3321485853ray-hue/Rhythm-of-Notes/images/04_声部分配与音高.png

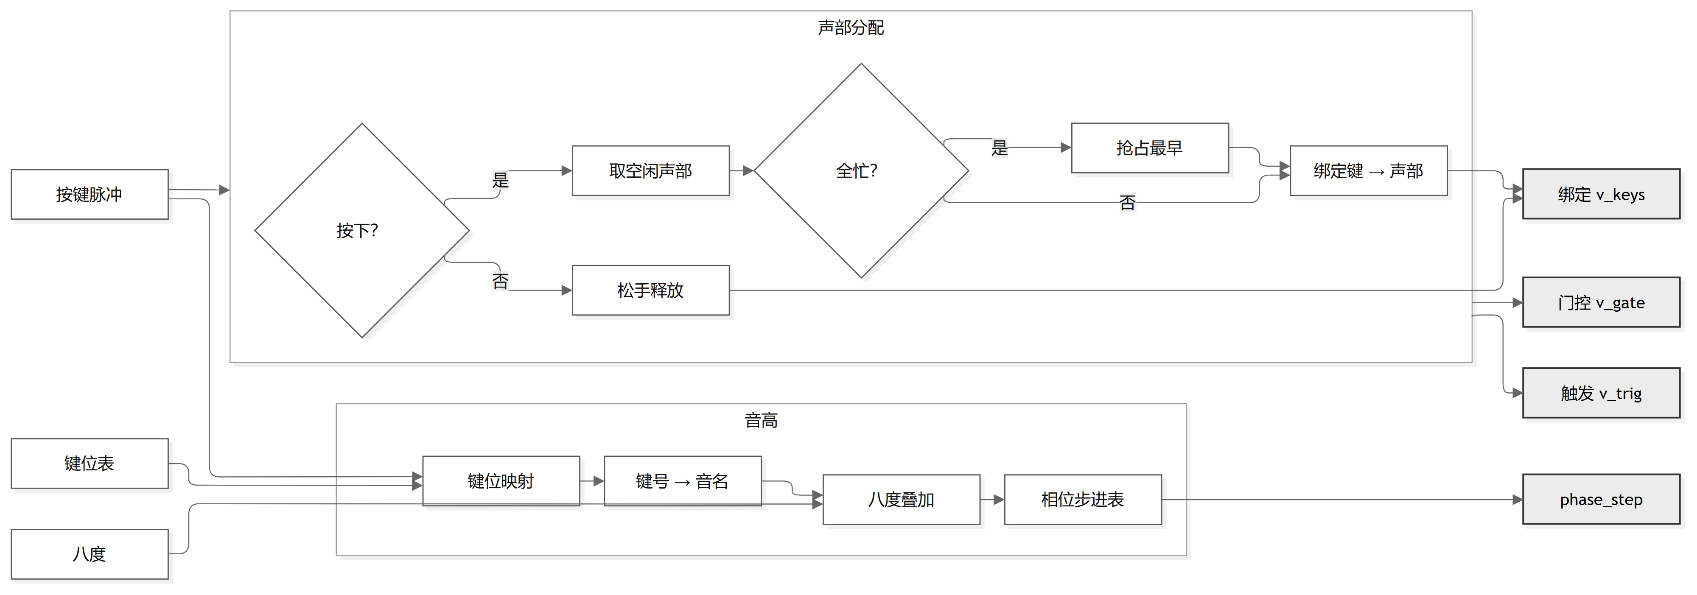
images/04_声部分配与音高.png
