3321485853ray-hue/Rhythm-of-Notes/images/05_加法合成引擎.png

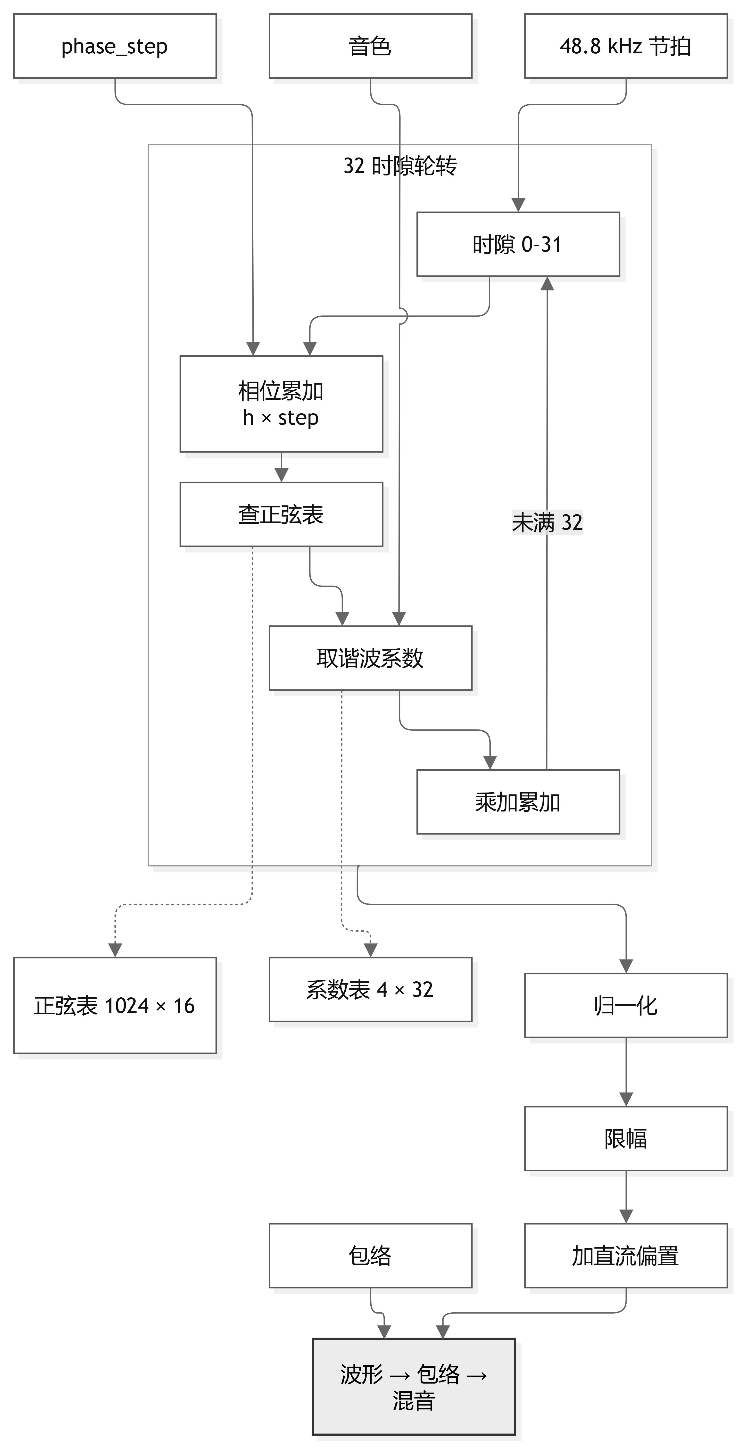
images/05_加法合成引擎.png
