3321485853ray-hue/Rhythm-of-Notes/images/10_FFT频谱.png

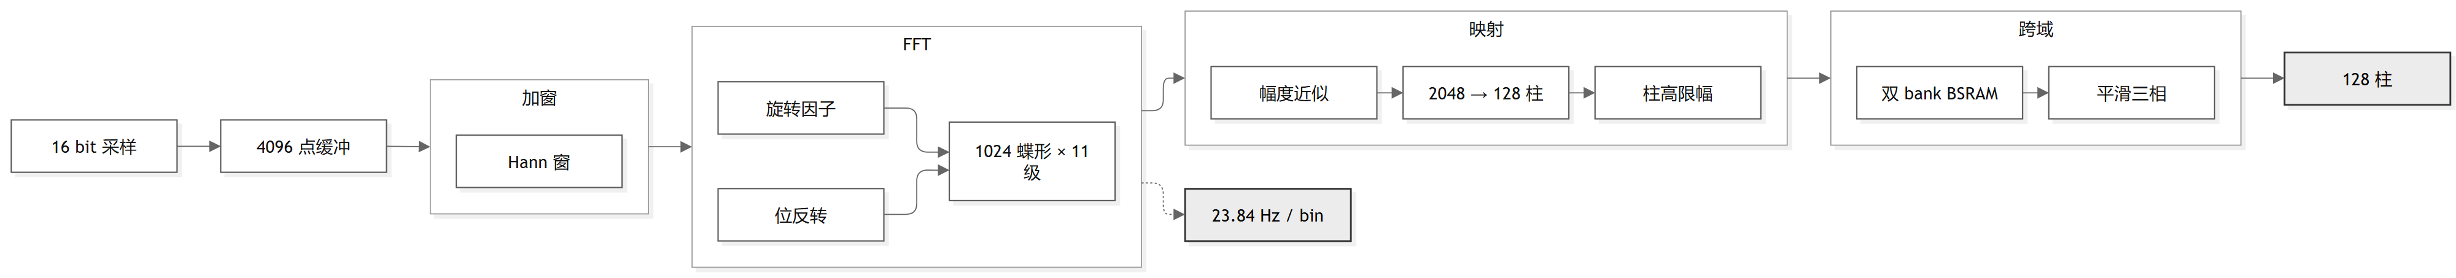
images/10_FFT频谱.png
