3321485853ray-hue/Rhythm-of-Notes/images/图3-12_I2S时序波形.png

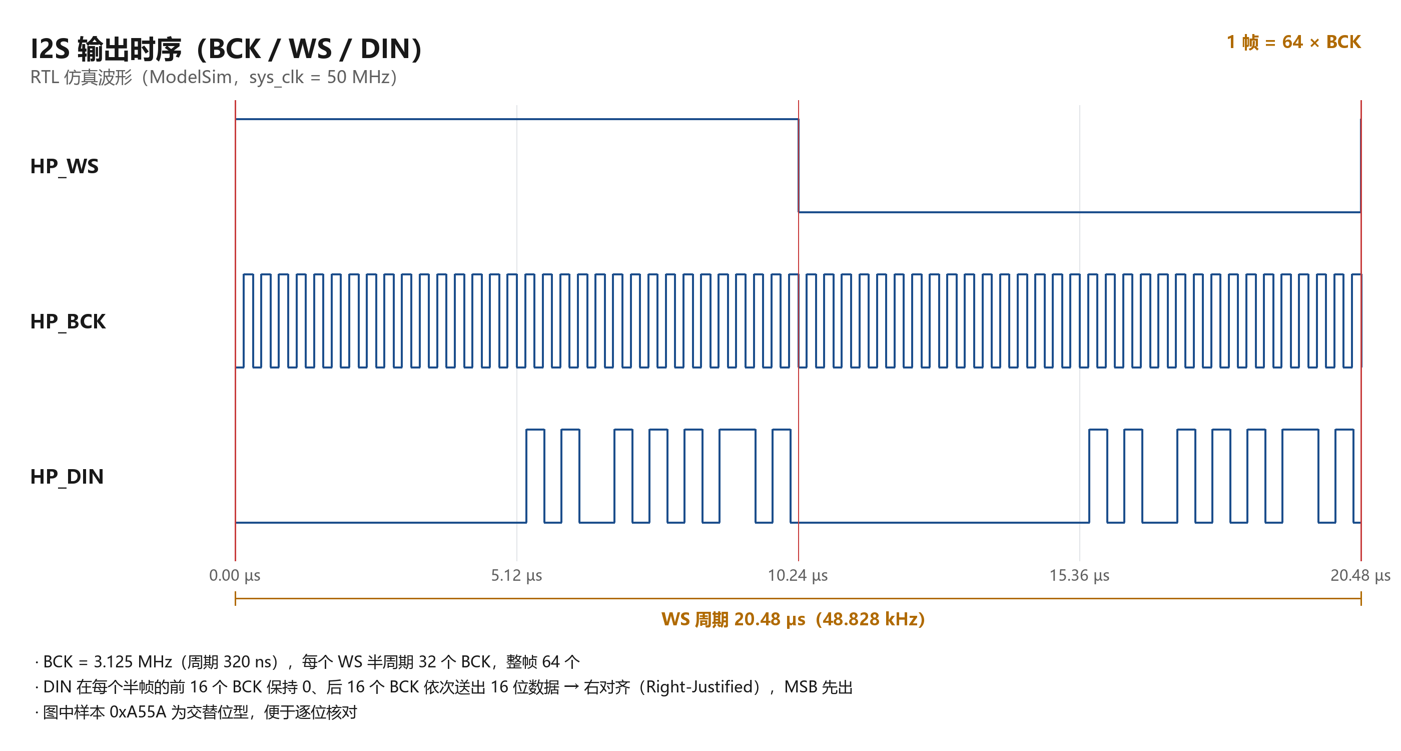
images/图3-12_I2S时序波形.png
