3321485853ray-hue/Rhythm-of-Notes/images/图3-12_ModelSim波形.png

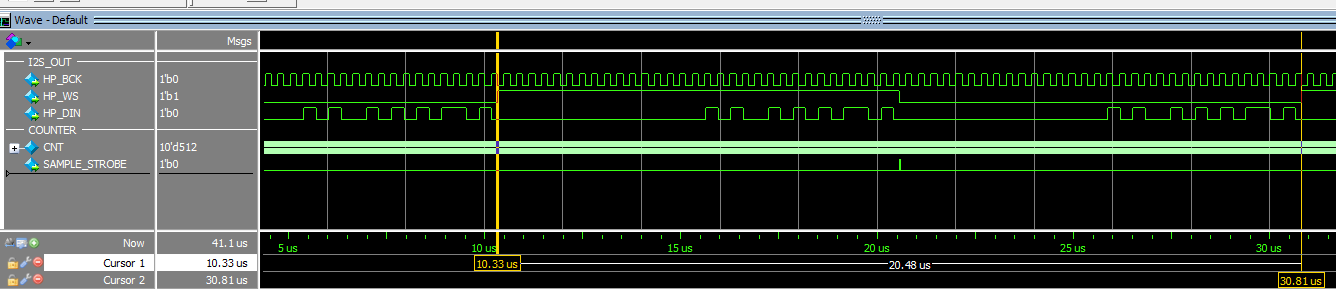
images/图3-12_ModelSim波形.png
