3321485853ray-hue/Rhythm-of-Notes/images/图3-14_颤音震音.png

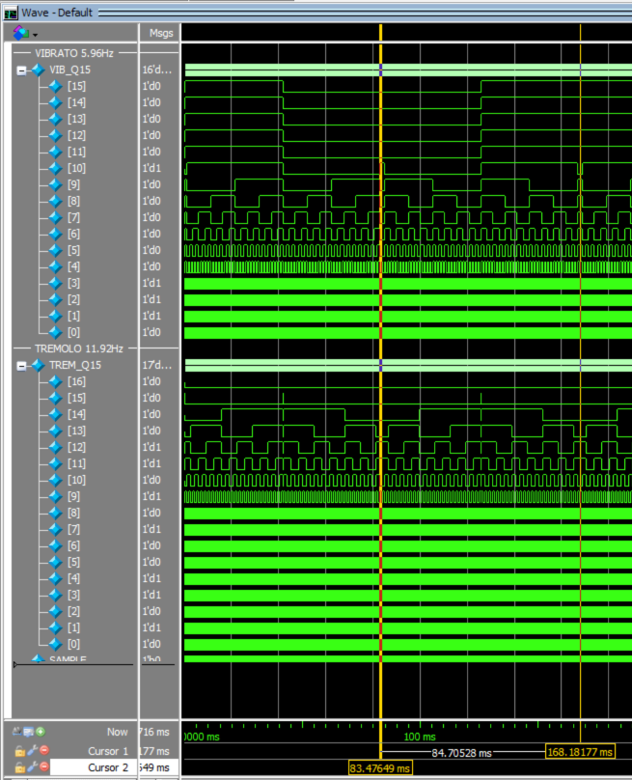
images/图3-14_颤音震音.png
