3321485853ray-hue/Rhythm-of-Notes/images/图3-15_UART帧.png

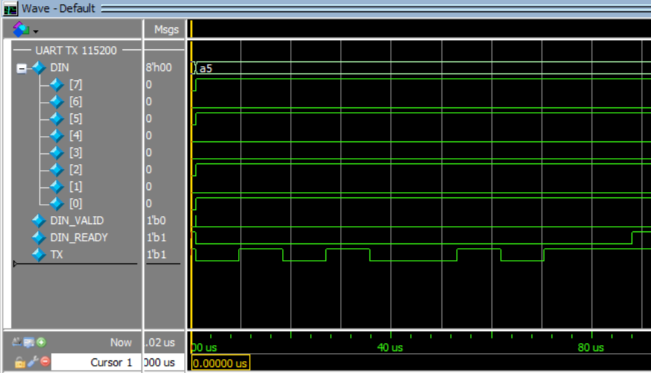
images/图3-15_UART帧.png
