3321485853ray-hue/Rhythm-of-Notes/images/图3-16_延迟.png

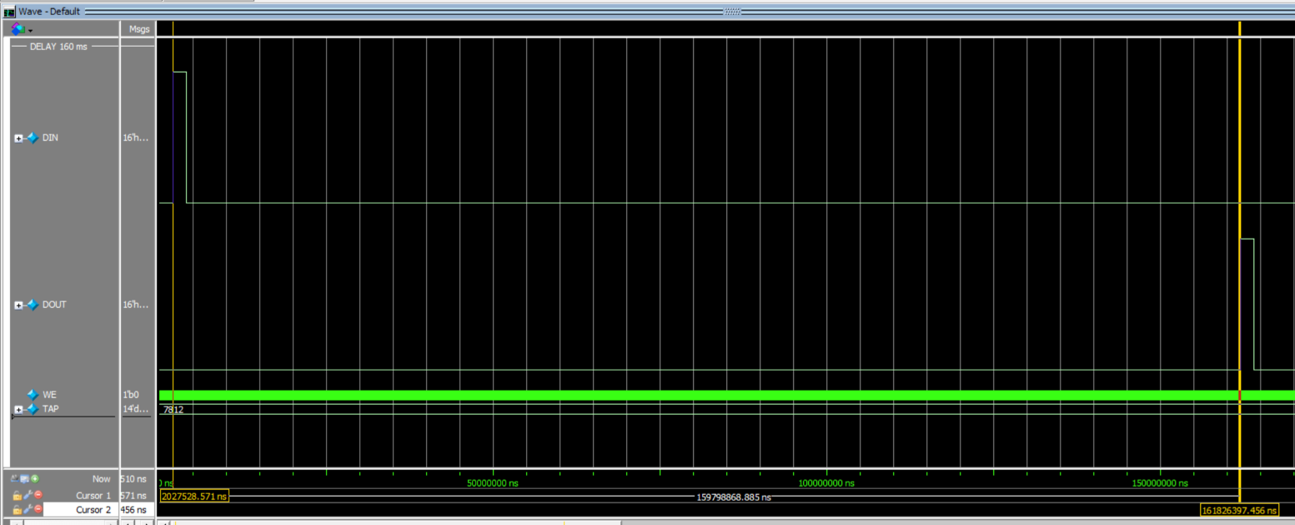
images/图3-16_延迟.png
