3321485853ray-hue/Rhythm-of-Notes/images/图3-17_混响.png

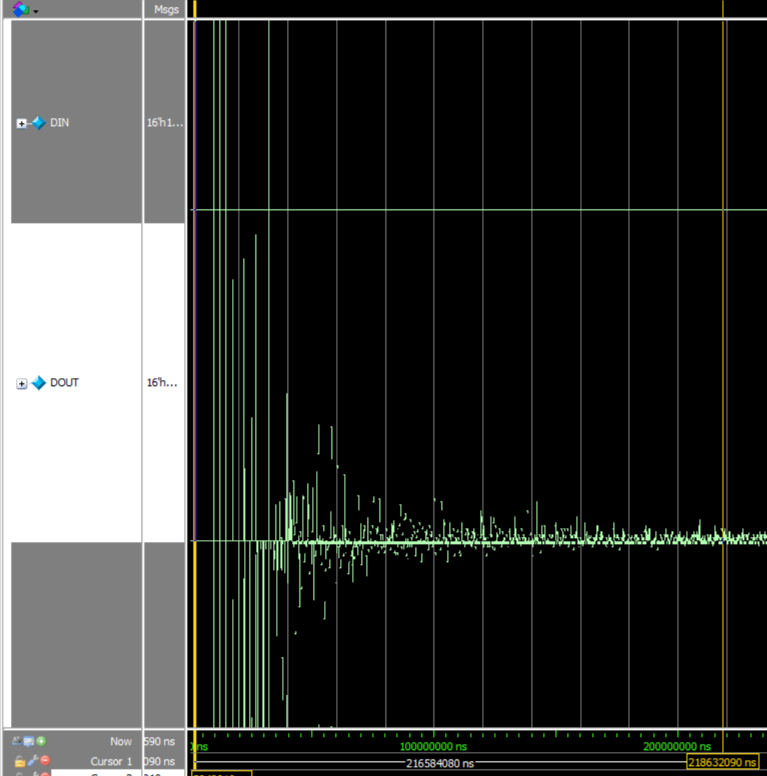
images/图3-17_混响.png
