3321485853ray-hue/Rhythm-of-Notes/images/图3-18_按键消抖.png

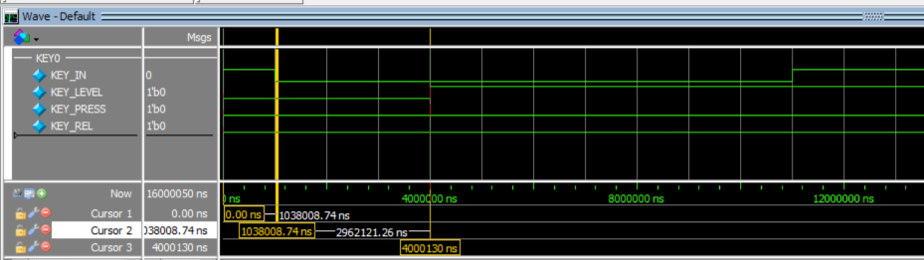
images/图3-18_按键消抖.png
