3321485853ray-hue/Rhythm-of-Notes/hardware/Black.stl

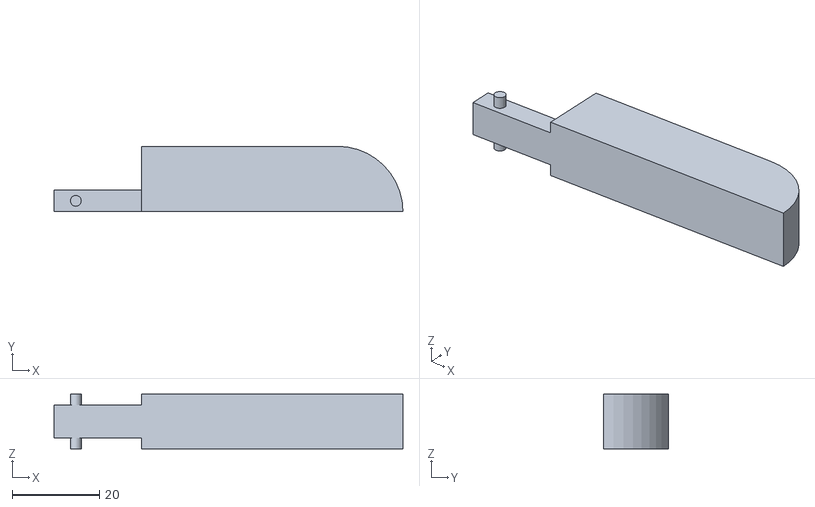
[picture p41: CAD file, 2026-11-04]
hardware/Black.stl
80.0 x 15.0 x 12.5
