3321485853ray-hue/Rhythm-of-Notes/hardware/WhiteUltimate.stl

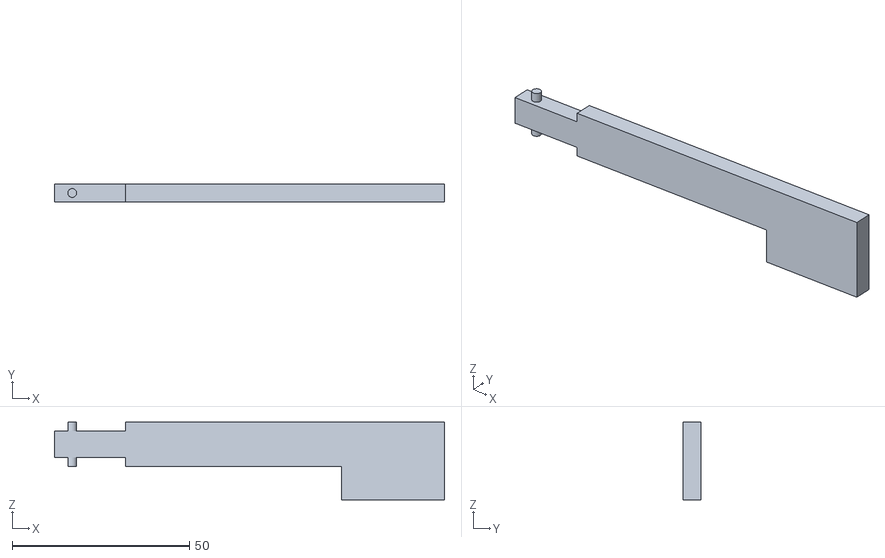
[picture p42: CAD file, 2026-11-04]
hardware/WhiteUltimate.stl
110.0 x 5.00 x 21.9
