3321485853ray-hue/Rhythm-of-Notes/hardware/Holder.stl

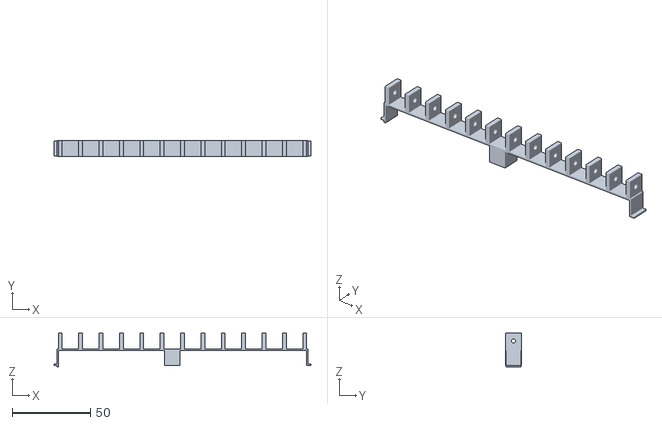
[picture p43: CAD file, 2026-11-04]
hardware/Holder.stl
164.0 x 10.0 x 21.5
