3321485853ray-hue/Rhythm-of-Notes/hardware/WhiteSide.stl

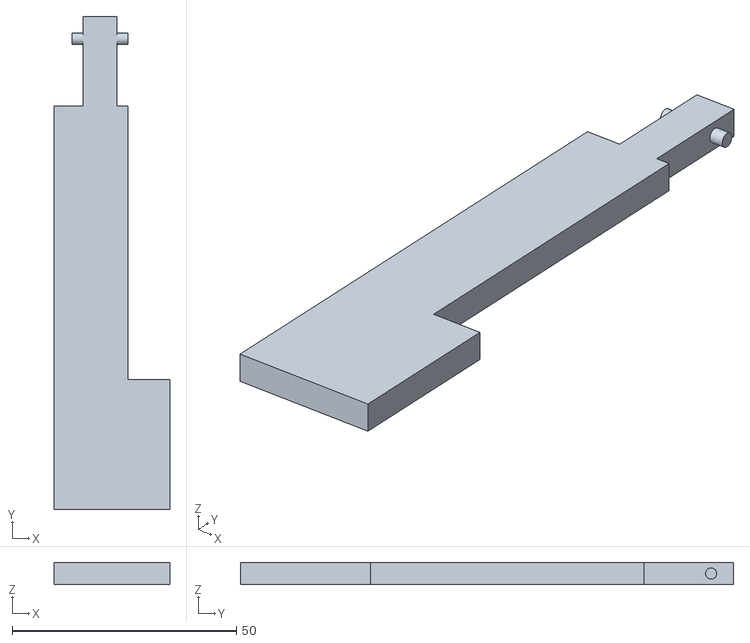
[picture p44: CAD file, 2026-11-04]
hardware/WhiteSide.stl
25.9 x 110.0 x 5.00
