3321485853ray-hue/Rhythm-of-Notes/hardware/base2.stl

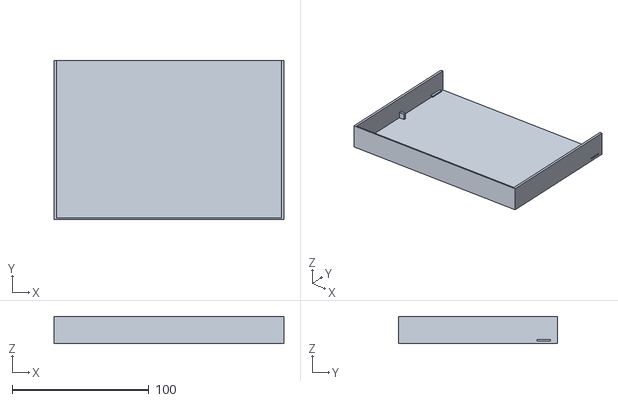
[picture p45: CAD file, 2026-11-04]
hardware/base2.stl
168.0 x 116.0 x 20.0
