3321485853ray-hue/Rhythm-of-Notes/hardware/Whiteequal.stl

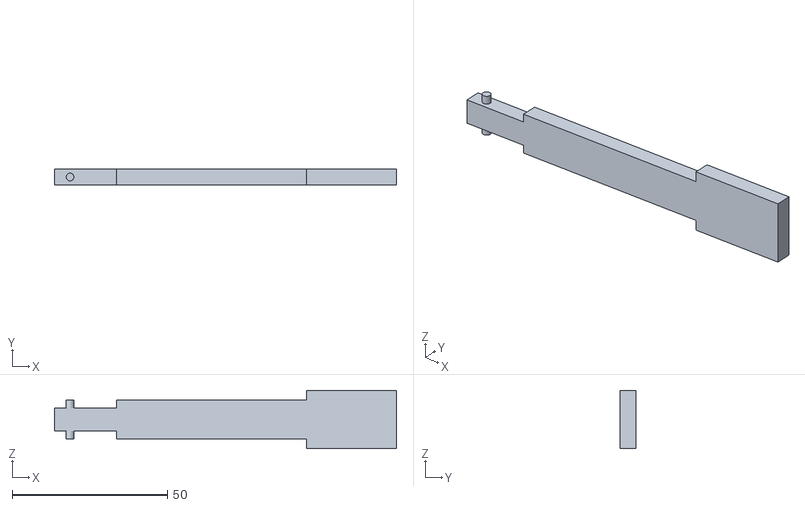
[picture p46: CAD file, 2026-11-04]
hardware/Whiteequal.stl
110.0 x 5.00 x 18.8
