3321485853ray-hue/Rhythm-of-Notes/(list of files, cad)

Other CAD files:
hardware/Whitecringe.stl
