3321485853ray-hue/Rhythm-of-Notes/fpga/src/harm_coef_rom.v

// harm_coef_rom.v —— 各音色 32 次谐波系数（coef>>5，0..255）

module harm_coef_rom (
    input  wire       clk,
    input  wire [7:0] addr,
    output reg  [7:0] dout = 8'd0
);
    reg [7:0] mem [0:255];
    initial begin
        mem[  0] = 8'd255;
        mem[  1] = 8'd  0;
        mem[  2] = 8'd  0;
        mem[  3] = 8'd  0;
        mem[  4] = 8'd  0;
        mem[  5] = 8'd  0;
        mem[  6] = 8'd  0;
        mem[  7] = 8'd  0;
        mem[  8] = 8'd  0;
        mem[  9] = 8'd  0;
        mem[ 10] = 8'd  0;
        mem[ 11] = 8'd  0;
        mem[ 12] = 8'd  0;
        mem[ 13] = 8'd  0;
        mem[ 14] = 8'd  0;
        mem[ 15] = 8'd  0;
        mem[ 16] = 8'd  0;
        mem[ 17] = 8'd  0;
        mem[ 18] = 8'd  0;
        mem[ 19] = 8'd  0;
        mem[ 20] = 8'd  0;
        mem[ 21] = 8'd  0;
        mem[ 22] = 8'd  0;
        mem[ 23] = 8'd  0;
        mem[ 24] = 8'd  0;
        mem[ 25] = 8'd  0;
        mem[ 26] = 8'd  0;
        mem[ 27] = 8'd  0;
        mem[ 28] = 8'd  0;
        mem[ 29] = 8'd  0;
        mem[ 30] = 8'd  0;
        mem[ 31] = 8'd  0;
        mem[ 32] = 8'd114;
        mem[ 33] = 8'd 79;
        mem[ 34] = 8'd 59;
        mem[ 35] = 8'd 45;
        mem[ 36] = 8'd 35;
        mem[ 37] = 8'd 28;
        mem[ 38] = 8'd 22;
        mem[ 39] = 8'd 18;
        mem[ 40] = 8'd 14;
        mem[ 41] = 8'd 12;
        mem[ 42] = 8'd 11;
        mem[ 43] = 8'd 10;
        mem[ 44] = 8'd  9;
        mem[ 45] = 8'd  9;
        mem[ 46] = 8'd  8;
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
        mem[248] = 8'd  0;
        mem[249] = 8'd  0;
        mem[250] = 8'd  0;
        mem[251] = 8'd  0;
        mem[252] = 8'd  0;
        mem[253] = 8'd  0;
        mem[254] = 8'd  0;
        mem[255] = 8'd  0;
    end
    always @(posedge clk) dout <= mem[addr];
endmodule
