3321485853ray-hue/Rhythm-of-Notes/fpga/src/bin2bar_rom.v

// bin2bar_rom.v —— FFT bin → 128 根线性频率柱（0..16000 Hz）

module bin2bar_rom (
    input  wire        clk,
    input  wire [9:0] addr,
    output reg  [7:0] dout = 8'd0
);
    reg [7:0] mem [0:1023];
    initial begin
        mem[   0] = 8'hff;
        mem[   1] = 8'h00;
        mem[   2] = 8'h00;
        mem[   3] = 8'h00;
        mem[   4] = 8'h00;
        mem[   5] = 8'h00;
        mem[   6] = 8'h01;
        mem[   7] = 8'h01;
        mem[   8] = 8'h01;
        mem[   9] = 8'h01;
        mem[  10] = 8'h01;
        mem[  11] = 8'h02;
        mem[  12] = 8'h02;
        mem[  13] = 8'h02;
        mem[  14] = 8'h02;
        mem[  15] = 8'h02;
        mem[  16] = 8'h03;
        mem[  17] = 8'h03;
        mem[  18] = 8'h03;
        mem[  19] = 8'h03;
        mem[  20] = 8'h03;
        mem[  21] = 8'h04;
        mem[  22] = 8'h04;
        mem[  23] = 8'h04;
        mem[  24] = 8'h04;
        mem[  25] = 8'h04;
        mem[  26] = 8'h04;
        mem[  27] = 8'h05;
        mem[  28] = 8'h05;
        mem[  29] = 8'h05;
        mem[  30] = 8'h05;
        mem[  31] = 8'h05;
        mem[  32] = 8'h06;
        mem[  33] = 8'h06;
        mem[  34] = 8'h06;
        mem[  35] = 8'h06;
        mem[  36] = 8'h06;
        mem[  37] = 8'h07;
        mem[  38] = 8'h07;
        mem[  39] = 8'h07;
        mem[  40] = 8'h07;
        mem[  41] = 8'h07;
        mem[  42] = 8'h08;
        mem[  43] = 8'h08;
        mem[  44] = 8'h08;
        mem[  45] = 8'h08;
        mem[  46] = 8'h08;
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
        mem[ 980] = 8'hff;
        mem[ 981] = 8'hff;
        mem[ 982] = 8'hff;
        mem[ 983] = 8'hff;
        mem[ 984] = 8'hff;
        mem[ 985] = 8'hff;
        mem[ 986] = 8'hff;
        mem[ 987] = 8'hff;
        mem[ 988] = 8'hff;
        mem[ 989] = 8'hff;
        mem[ 990] = 8'hff;
        mem[ 991] = 8'hff;
        mem[ 992] = 8'hff;
        mem[ 993] = 8'hff;
        mem[ 994] = 8'hff;
        mem[ 995] = 8'hff;
        mem[ 996] = 8'hff;
        mem[ 997] = 8'hff;
        mem[ 998] = 8'hff;
        mem[ 999] = 8'hff;
        mem[1000] = 8'hff;
        mem[1001] = 8'hff;
        mem[1002] = 8'hff;
        mem[1003] = 8'hff;
        mem[1004] = 8'hff;
        mem[1005] = 8'hff;
        mem[1006] = 8'hff;
        mem[1007] = 8'hff;
        mem[1008] = 8'hff;
        mem[1009] = 8'hff;
        mem[1010] = 8'hff;
        mem[1011] = 8'hff;
        mem[1012] = 8'hff;
        mem[1013] = 8'hff;
        mem[1014] = 8'hff;
        mem[1015] = 8'hff;
        mem[1016] = 8'hff;
        mem[1017] = 8'hff;
        mem[1018] = 8'hff;
        mem[1019] = 8'hff;
        mem[1020] = 8'hff;
        mem[1021] = 8'hff;
        mem[1022] = 8'hff;
        mem[1023] = 8'hff;
    end
    always @(posedge clk) dout <= mem[addr];
endmodule
