3321485853ray-hue/Rhythm-of-Notes/fpga/src/font_rom.v

// font_rom.v —— 8x16 点阵字库（ASCII 32..95，64 字符）

module font_rom (
    input  wire       clk,
    input  wire [9:0] addr,
    output reg  [7:0] dout = 8'd0
);
    reg [7:0] mem [0:1023];
    initial begin
        // ' '
        mem[  0] = 8'h00;
        mem[  1] = 8'h00;
        mem[  2] = 8'h00;
        mem[  3] = 8'h00;
        mem[  4] = 8'h00;
        mem[  5] = 8'h00;
        mem[  6] = 8'h00;
        mem[  7] = 8'h00;
        mem[  8] = 8'h00;
        mem[  9] = 8'h00;
        mem[ 10] = 8'h00;
        mem[ 11] = 8'h00;
        mem[ 12] = 8'h00;
        mem[ 13] = 8'h00;
        mem[ 14] = 8'h00;
        mem[ 15] = 8'h00;
        // '!'
        mem[ 16] = 8'h00;
        mem[ 17] = 8'h00;
        mem[ 18] = 8'h10;
        mem[ 19] = 8'h10;
        mem[ 20] = 8'h10;
        mem[ 21] = 8'h10;
        mem[ 22] = 8'h10;
        mem[ 23] = 8'h10;
        mem[ 24] = 8'h10;
        mem[ 25] = 8'h00;
        mem[ 26] = 8'h10;
        mem[ 27] = 8'h10;
        mem[ 28] = 8'h00;
        mem[ 29] = 8'h00;
        mem[ 30] = 8'h00;
        mem[ 31] = 8'h00;
        // '"'
        mem[ 32] = 8'h00;
        mem[ 33] = 8'h24;
        mem[ 34] = 8'h24;
        mem[ 35] = 8'h24;
        mem[ 36] = 8'h00;
        mem[ 37] = 8'h00;
        mem[ 38] = 8'h00;
        mem[ 39] = 8'h00;
        mem[ 40] = 8'h00;
        mem[ 41] = 8'h00;
        mem[ 42] = 8'h00;
        mem[ 43] = 8'h00;
        mem[ 44] = 8'h00;
        mem[ 45] = 8'h00;
        mem[ 46] = 8'h00;
        mem[ 47] = 8'h00;
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
        mem[980] = 8'h08;
        mem[981] = 8'h08;
        mem[982] = 8'h08;
        mem[983] = 8'h08;
        mem[984] = 8'h08;
        mem[985] = 8'h08;
        mem[986] = 8'h08;
        mem[987] = 8'h38;
        mem[988] = 8'h00;
        mem[989] = 8'h00;
        mem[990] = 8'h00;
        mem[991] = 8'h00;
        // '^'
        mem[992] = 8'h00;
        mem[993] = 8'h10;
        mem[994] = 8'h28;
        mem[995] = 8'h44;
        mem[996] = 8'h00;
        mem[997] = 8'h00;
        mem[998] = 8'h00;
        mem[999] = 8'h00;
        mem[1000] = 8'h00;
        mem[1001] = 8'h00;
        mem[1002] = 8'h00;
        mem[1003] = 8'h00;
        mem[1004] = 8'h00;
        mem[1005] = 8'h00;
        mem[1006] = 8'h00;
        mem[1007] = 8'h00;
        // '_'
        mem[1008] = 8'h00;
        mem[1009] = 8'h00;
        mem[1010] = 8'h00;
        mem[1011] = 8'h00;
        mem[1012] = 8'h00;
        mem[1013] = 8'h00;
        mem[1014] = 8'h00;
        mem[1015] = 8'h00;
        mem[1016] = 8'h00;
        mem[1017] = 8'h00;
        mem[1018] = 8'h00;
        mem[1019] = 8'h00;
        mem[1020] = 8'h00;
        mem[1021] = 8'h7E;
        mem[1022] = 8'h00;
        mem[1023] = 8'h00;
    end
    always @(posedge clk) dout <= mem[addr];
endmodule
