3321485853ray-hue/Rhythm-of-Notes/fpga/src/hann_rom.v

// hann_rom.v —— 2048 点 Hann 窗（Q15，周期型）

module hann_rom (
    input  wire        clk,
    input  wire [10:0] addr,
    output reg  [15:0] dout = 16'd0
);
    reg [15:0] mem [0:2047];
    initial begin
        mem[   0] = 16'h0000;
        mem[   1] = 16'h0000;
        mem[   2] = 16'h0000;
        mem[   3] = 16'h0001;
        mem[   4] = 16'h0001;
        mem[   5] = 16'h0002;
        mem[   6] = 16'h0003;
        mem[   7] = 16'h0004;
        mem[   8] = 16'h0005;
        mem[   9] = 16'h0006;
        mem[  10] = 16'h0008;
        mem[  11] = 16'h0009;
        mem[  12] = 16'h000b;
        mem[  13] = 16'h000d;
        mem[  14] = 16'h000f;
        mem[  15] = 16'h0011;
        mem[  16] = 16'h0014;
        mem[  17] = 16'h0016;
        mem[  18] = 16'h0019;
        mem[  19] = 16'h001c;
        mem[  20] = 16'h001f;
        mem[  21] = 16'h0022;
        mem[  22] = 16'h0025;
        mem[  23] = 16'h0029;
        mem[  24] = 16'h002c;
        mem[  25] = 16'h0030;
        mem[  26] = 16'h0034;
        mem[  27] = 16'h0038;
        mem[  28] = 16'h003c;
        mem[  29] = 16'h0041;
        mem[  30] = 16'h0045;
        mem[  31] = 16'h004a;
        mem[  32] = 16'h004f;
        mem[  33] = 16'h0054;
        mem[  34] = 16'h0059;
        mem[  35] = 16'h005e;
        mem[  36] = 16'h0064;
        mem[  37] = 16'h0069;
        mem[  38] = 16'h006f;
        mem[  39] = 16'h0075;
        mem[  40] = 16'h007b;
        mem[  41] = 16'h0081;
        mem[  42] = 16'h0088;
        mem[  43] = 16'h008e;
        mem[  44] = 16'h0095;
        mem[  45] = 16'h009c;
        mem[  46] = 16'h00a3;
        mem[  47] = 16'h00aa;
        mem[  48] = 16'h00b1;
        mem[  49] = 16'h00b9;
        mem[  50] = 16'h00c0;
        mem[  51] = 16'h00c8;
        mem[  52] = 16'h00d0;
        mem[  53] = 16'h00d8;
        mem[  54] = 16'h00e0;
        mem[  55] = 16'h00e9;
        mem[  56] = 16'h00f1;
        mem[  57] = 16'h00fa;
        mem[  58] = 16'h0103;
        mem[  59] = 16'h010c;
        mem[  60] = 16'h0115;
        mem[  61] = 16'h011e;
        mem[  62] = 16'h0127;
        mem[  63] = 16'h0131;
        mem[  64] = 16'h013b;
        mem[  65] = 16'h0145;
        mem[  66] = 16'h014f;
        mem[  67] = 16'h0159;
        mem[  68] = 16'h0163;
        mem[  69] = 16'h016e;
        mem[  70] = 16'h0178;
        mem[  71] = 16'h0183;
        mem[  72] = 16'h018e;
        mem[  73] = 16'h0199;
        mem[  74] = 16'h01a4;
        mem[  75] = 16'h01b0;
        mem[  76] = 16'h01bb;
        mem[  77] = 16'h01c7;
        mem[  78] = 16'h01d3;
        mem[  79] = 16'h01df;
        mem[  80] = 16'h01eb;
        mem[  81] = 16'h01f7;
        mem[  82] = 16'h0204;
        mem[  83] = 16'h0210;
        mem[  84] = 16'h021d;
        mem[  85] = 16'h022a;
        mem[  86] = 16'h0237;
        mem[  87] = 16'h0244;
        mem[  88] = 16'h0251;
        mem[  89] = 16'h025f;
        mem[  90] = 16'h026d;
        mem[  91] = 16'h027a;
        mem[  92] = 16'h0288;
        mem[  93] = 16'h0296;
        mem[  94] = 16'h02a5;
        mem[  95] = 16'h02b3;
        mem[  96] = 16'h02c1;
        mem[  97] = 16'h02d0;
        mem[  98] = 16'h02df;
        mem[  99] = 16'h02ee;
        mem[ 100] = 16'h02fd;
        mem[ 101] = 16'h030c;
        mem[ 102] = 16'h031c;
        mem[ 103] = 16'h032b;
        mem[ 104] = 16'h033b;
        mem[ 105] = 16'h034b;
        mem[ 106] = 16'h035b;
        mem[ 107] = 16'h036b;
        mem[ 108] = 16'h037b;
        mem[ 109] = 16'h038c;
        mem[ 110] = 16'h039c;
        mem[ 111] = 16'h03ad;
        mem[ 112] = 16'h03be;
        mem[ 113] = 16'h03cf;
        mem[ 114] = 16'h03e0;
        mem[ 115] = 16'h03f1;
        mem[ 116] = 16'h0403;
        mem[ 117] = 16'h0414;
        mem[ 118] = 16'h0426;
        mem[ 119] = 16'h0438;
        mem[ 120] = 16'h044a;
        mem[ 121] = 16'h045c;
        mem[ 122] = 16'h046e;
        mem[ 123] = 16'h0481;
        mem[ 124] = 16'h0493;
        mem[ 125] = 16'h04a6;
        mem[ 126] = 16'h04b9;
        mem[ 127] = 16'h04cc;
        mem[ 128] = 16'h04df;
        mem[ 129] = 16'h04f2;
        mem[ 130] = 16'h0506;
        mem[ 131] = 16'h0519;
        mem[ 132] = 16'h052d;
        mem[ 133] = 16'h0541;
        mem[ 134] = 16'h0555;
        mem[ 135] = 16'h0569;
        mem[ 136] = 16'h057e;
        mem[ 137] = 16'h0592;
        mem[ 138] = 16'h05a7;
        mem[ 139] = 16'h05bb;
        mem[ 140] = 16'h05d0;
        mem[ 141] = 16'h05e5;
        mem[ 142] = 16'h05fa;
        mem[ 143] = 16'h0610;
        mem[ 144] = 16'h0625;
        mem[ 145] = 16'h063b;
        mem[ 146] = 16'h0650;
        mem[ 147] = 16'h0666;
        mem[ 148] = 16'h067c;
        mem[ 149] = 16'h0692;
        mem[ 150] = 16'h06a8;
        mem[ 151] = 16'h06bf;
        mem[ 152] = 16'h06d5;
        mem[ 153] = 16'h06ec;
        mem[ 154] = 16'h0703;
        mem[ 155] = 16'h071a;
        mem[ 156] = 16'h0731;
        mem[ 157] = 16'h0748;
        mem[ 158] = 16'h075f;
        mem[ 159] = 16'h0777;
        mem[ 160] = 16'h078f;
        mem[ 161] = 16'h07a6;
        mem[ 162] = 16'h07be;
        mem[ 163] = 16'h07d6;
        mem[ 164] = 16'h07ee;
        mem[ 165] = 16'h0807;
        mem[ 166] = 16'h081f;
        mem[ 167] = 16'h0838;
        mem[ 168] = 16'h0850;
        mem[ 169] = 16'h0869;
        mem[ 170] = 16'h0882;
        mem[ 171] = 16'h089b;
        mem[ 172] = 16'h08b5;
        mem[ 173] = 16'h08ce;
        mem[ 174] = 16'h08e7;
        mem[ 175] = 16'h0901;
        mem[ 176] = 16'h091b;
        mem[ 177] = 16'h0935;
        mem[ 178] = 16'h094f;
        mem[ 179] = 16'h0969;
        mem[ 180] = 16'h0983;
        mem[ 181] = 16'h099e;
        mem[ 182] = 16'h09b8;
        mem[ 183] = 16'h09d3;
        mem[ 184] = 16'h09ee;
        mem[ 185] = 16'h0a09;
        mem[ 186] = 16'h0a24;
        mem[ 187] = 16'h0a3f;
        mem[ 188] = 16'h0a5a;
        mem[ 189] = 16'h0a76;
        mem[ 190] = 16'h0a92;
        mem[ 191] = 16'h0aad;
        mem[ 192] = 16'h0ac9;
        mem[ 193] = 16'h0ae5;
        mem[ 194] = 16'h0b01;
        mem[ 195] = 16'h0b1d;
        mem[ 196] = 16'h0b3a;
        mem[ 197] = 16'h0b56;
        mem[ 198] = 16'h0b73;
        mem[ 199] = 16'h0b90;
        mem[ 200] = 16'h0bad;
        mem[ 201] = 16'h0bca;
        mem[ 202] = 16'h0be7;
        mem[ 203] = 16'h0c04;
        mem[ 204] = 16'h0c21;
        mem[ 205] = 16'h0c3f;
        mem[ 206] = 16'h0c5d;
        mem[ 207] = 16'h0c7a;
        mem[ 208] = 16'h0c98;
        mem[ 209] = 16'h0cb6;
        mem[ 210] = 16'h0cd4;
        mem[ 211] = 16'h0cf3;
        mem[ 212] = 16'h0d11;
        mem[ 213] = 16'h0d2f;
        mem[ 214] = 16'h0d4e;
        mem[ 215] = 16'h0d6d;
        mem[ 216] = 16'h0d8c;
        mem[ 217] = 16'h0dab;
        mem[ 218] = 16'h0dca;
        mem[ 219] = 16'h0de9;
        mem[ 220] = 16'h0e08;
        mem[ 221] = 16'h0e28;
        mem[ 222] = 16'h0e47;
        mem[ 223] = 16'h0e67;
        mem[ 224] = 16'h0e87;
        mem[ 225] = 16'h0ea7;
        mem[ 226] = 16'h0ec7;
        mem[ 227] = 16'h0ee7;
        mem[ 228] = 16'h0f07;
        mem[ 229] = 16'h0f28;
        mem[ 230] = 16'h0f48;
        mem[ 231] = 16'h0f69;
        mem[ 232] = 16'h0f8a;
        mem[ 233] = 16'h0fab;
        mem[ 234] = 16'h0fcc;
        mem[ 235] = 16'h0fed;
        mem[ 236] = 16'h100e;
        mem[ 237] = 16'h102f;
        mem[ 238] = 16'h1051;
        mem[ 239] = 16'h1072;
        mem[ 240] = 16'h1094;
        mem[ 241] = 16'h10b6;
        mem[ 242] = 16'h10d8;
        mem[ 243] = 16'h10fa;
        mem[ 244] = 16'h111c;
        mem[ 245] = 16'h113e;
        mem[ 246] = 16'h1161;
        mem[ 247] = 16'h1183;
        mem[ 248] = 16'h11a6;
        mem[ 249] = 16'h11c9;
        mem[ 250] = 16'h11eb;
        mem[ 251] = 16'h120e;
        mem[ 252] = 16'h1231;
        mem[ 253] = 16'h1254;
        mem[ 254] = 16'h1278;
        mem[ 255] = 16'h129b;
        mem[ 256] = 16'h12bf;
        mem[ 257] = 16'h12e2;
        mem[ 258] = 16'h1306;
        mem[ 259] = 16'h132a;
        mem[ 260] = 16'h134e;
        mem[ 261] = 16'h1372;
        mem[ 262] = 16'h1396;
        mem[ 263] = 16'h13ba;
        mem[ 264] = 16'h13de;
        mem[ 265] = 16'h1403;
        mem[ 266] = 16'h1427;
        mem[ 267] = 16'h144c;
        mem[ 268] = 16'h1471;
        mem[ 269] = 16'h1496;
        mem[ 270] = 16'h14bb;
        mem[ 271] = 16'h14e0;
        mem[ 272] = 16'h1505;
        mem[ 273] = 16'h152a;
        mem[ 274] = 16'h1550;
        mem[ 275] = 16'h1575;
        mem[ 276] = 16'h159b;
        mem[ 277] = 16'h15c1;
        mem[ 278] = 16'h15e6;
        mem[ 279] = 16'h160c;
        mem[ 280] = 16'h1632;
        mem[ 281] = 16'h1658;
        mem[ 282] = 16'h167f;
        mem[ 283] = 16'h16a5;
        mem[ 284] = 16'h16cb;
        mem[ 285] = 16'h16f2;
        mem[ 286] = 16'h1718;
        mem[ 287] = 16'h173f;
        mem[ 288] = 16'h1766;
        mem[ 289] = 16'h178d;
        mem[ 290] = 16'h17b4;
        mem[ 291] = 16'h17db;
        mem[ 292] = 16'h1802;
        mem[ 293] = 16'h1829;
        mem[ 294] = 16'h1851;
        mem[ 295] = 16'h1878;
        mem[ 296] = 16'h18a0;
        mem[ 297] = 16'h18c8;
        mem[ 298] = 16'h18ef;
        mem[ 299] = 16'h1917;
        mem[ 300] = 16'h193f;
        mem[ 301] = 16'h1967;
        mem[ 302] = 16'h198f;
        mem[ 303] = 16'h19b8;
        mem[ 304] = 16'h19e0;
        mem[ 305] = 16'h1a08;
        mem[ 306] = 16'h1a31;
        mem[ 307] = 16'h1a59;
        mem[ 308] = 16'h1a82;
        mem[ 309] = 16'h1aab;
        mem[ 310] = 16'h1ad4;
        mem[ 311] = 16'h1afd;
        mem[ 312] = 16'h1b26;
        mem[ 313] = 16'h1b4f;
        mem[ 314] = 16'h1b78;
        mem[ 315] = 16'h1ba1;
        mem[ 316] = 16'h1bcb;
        mem[ 317] = 16'h1bf4;
        mem[ 318] = 16'h1c1e;
        mem[ 319] = 16'h1c48;
        mem[ 320] = 16'h1c71;
        mem[ 321] = 16'h1c9b;
        mem[ 322] = 16'h1cc5;
        mem[ 323] = 16'h1cef;
        mem[ 324] = 16'h1d19;
        mem[ 325] = 16'h1d43;
        mem[ 326] = 16'h1d6e;
        mem[ 327] = 16'h1d98;
        mem[ 328] = 16'h1dc2;
        mem[ 329] = 16'h1ded;
        mem[ 330] = 16'h1e17;
        mem[ 331] = 16'h1e42;
        mem[ 332] = 16'h1e6d;
        mem[ 333] = 16'h1e98;
        mem[ 334] = 16'h1ec3;
        mem[ 335] = 16'h1eee;
        mem[ 336] = 16'h1f19;
        mem[ 337] = 16'h1f44;
        mem[ 338] = 16'h1f6f;
        mem[ 339] = 16'h1f9a;
        mem[ 340] = 16'h1fc6;
        mem[ 341] = 16'h1ff1;
        mem[ 342] = 16'h201d;
        mem[ 343] = 16'h2048;
        mem[ 344] = 16'h2074;
        mem[ 345] = 16'h20a0;
        mem[ 346] = 16'h20cc;
        mem[ 347] = 16'h20f8;
        mem[ 348] = 16'h2124;
        mem[ 349] = 16'h2150;
        mem[ 350] = 16'h217c;
        mem[ 351] = 16'h21a8;
        mem[ 352] = 16'h21d4;
        mem[ 353] = 16'h2201;
        mem[ 354] = 16'h222d;
        mem[ 355] = 16'h225a;
        mem[ 356] = 16'h2286;
        mem[ 357] = 16'h22b3;
        mem[ 358] = 16'h22e0;
        mem[ 359] = 16'h230c;
        mem[ 360] = 16'h2339;
        mem[ 361] = 16'h2366;
        mem[ 362] = 16'h2393;
        mem[ 363] = 16'h23c0;
        mem[ 364] = 16'h23ed;
        mem[ 365] = 16'h241b;
        mem[ 366] = 16'h2448;
        mem[ 367] = 16'h2475;
        mem[ 368] = 16'h24a3;
        mem[ 369] = 16'h24d0;
        mem[ 370] = 16'h24fe;
        mem[ 371] = 16'h252b;
        mem[ 372] = 16'h2559;
        mem[ 373] = 16'h2587;
        mem[ 374] = 16'h25b4;
        mem[ 375] = 16'h25e2;
        mem[ 376] = 16'h2610;
        mem[ 377] = 16'h263e;
        mem[ 378] = 16'h266c;
        mem[ 379] = 16'h269a;
        mem[ 380] = 16'h26c9;
        mem[ 381] = 16'h26f7;
        mem[ 382] = 16'h2725;
        mem[ 383] = 16'h2753;
        mem[ 384] = 16'h2782;
        mem[ 385] = 16'h27b0;
        mem[ 386] = 16'h27df;
        mem[ 387] = 16'h280d;
        mem[ 388] = 16'h283c;
        mem[ 389] = 16'h286b;
        mem[ 390] = 16'h2899;
        mem[ 391] = 16'h28c8;
        mem[ 392] = 16'h28f7;
        mem[ 393] = 16'h2926;
        mem[ 394] = 16'h2955;
        mem[ 395] = 16'h2984;
        mem[ 396] = 16'h29b3;
        mem[ 397] = 16'h29e2;
        mem[ 398] = 16'h2a12;
        mem[ 399] = 16'h2a41;
        mem[ 400] = 16'h2a70;
        mem[ 401] = 16'h2a9f;
        mem[ 402] = 16'h2acf;
        mem[ 403] = 16'h2afe;
        mem[ 404] = 16'h2b2e;
        mem[ 405] = 16'h2b5d;
        mem[ 406] = 16'h2b8d;
        mem[ 407] = 16'h2bbd;
        mem[ 408] = 16'h2bec;
        mem[ 409] = 16'h2c1c;
        mem[ 410] = 16'h2c4c;
        mem[ 411] = 16'h2c7c;
        mem[ 412] = 16'h2cac;
        mem[ 413] = 16'h2cdc;
        mem[ 414] = 16'h2d0c;
        mem[ 415] = 16'h2d3c;
        mem[ 416] = 16'h2d6c;
        mem[ 417] = 16'h2d9c;
        mem[ 418] = 16'h2dcc;
        mem[ 419] = 16'h2dfc;
        mem[ 420] = 16'h2e2c;
        mem[ 421] = 16'h2e5d;
        mem[ 422] = 16'h2e8d;
        mem[ 423] = 16'h2ebd;
        mem[ 424] = 16'h2eee;
        mem[ 425] = 16'h2f1e;
        mem[ 426] = 16'h2f4f;
        mem[ 427] = 16'h2f7f;
        mem[ 428] = 16'h2fb0;
        mem[ 429] = 16'h2fe1;
        mem[ 430] = 16'h3011;
        mem[ 431] = 16'h3042;
        mem[ 432] = 16'h3073;
        mem[ 433] = 16'h30a3;
        mem[ 434] = 16'h30d4;
        mem[ 435] = 16'h3105;
        mem[ 436] = 16'h3136;
        mem[ 437] = 16'h3167;
        mem[ 438] = 16'h3198;
        mem[ 439] = 16'h31c9;
        mem[ 440] = 16'h31fa;
        mem[ 441] = 16'h322b;
        mem[ 442] = 16'h325c;
        mem[ 443] = 16'h328d;
        mem[ 444] = 16'h32be;
        mem[ 445] = 16'h32ef;
        mem[ 446] = 16'h3321;
        mem[ 447] = 16'h3352;
        mem[ 448] = 16'h3383;
        mem[ 449] = 16'h33b5;
        mem[ 450] = 16'h33e6;
        mem[ 451] = 16'h3417;
        mem[ 452] = 16'h3449;
        mem[ 453] = 16'h347a;
        mem[ 454] = 16'h34ac;
        mem[ 455] = 16'h34dd;
        mem[ 456] = 16'h350f;
        mem[ 457] = 16'h3540;
        mem[ 458] = 16'h3572;
        mem[ 459] = 16'h35a3;
        mem[ 460] = 16'h35d5;
        mem[ 461] = 16'h3606;
        mem[ 462] = 16'h3638;
        mem[ 463] = 16'h366a;
        mem[ 464] = 16'h369c;
        mem[ 465] = 16'h36cd;
        mem[ 466] = 16'h36ff;
        mem[ 467] = 16'h3731;
        mem[ 468] = 16'h3763;
        mem[ 469] = 16'h3794;
        mem[ 470] = 16'h37c6;
        mem[ 471] = 16'h37f8;
        mem[ 472] = 16'h382a;
        mem[ 473] = 16'h385c;
        mem[ 474] = 16'h388e;
        mem[ 475] = 16'h38c0;
        mem[ 476] = 16'h38f2;
        mem[ 477] = 16'h3924;
        mem[ 478] = 16'h3956;
        mem[ 479] = 16'h3988;
        mem[ 480] = 16'h39ba;
        mem[ 481] = 16'h39ec;
        mem[ 482] = 16'h3a1e;
        mem[ 483] = 16'h3a50;
        mem[ 484] = 16'h3a82;
        mem[ 485] = 16'h3ab4;
        mem[ 486] = 16'h3ae6;
        mem[ 487] = 16'h3b18;
        mem[ 488] = 16'h3b4a;
        mem[ 489] = 16'h3b7c;
        mem[ 490] = 16'h3baf;
        mem[ 491] = 16'h3be1;
        mem[ 492] = 16'h3c13;
        mem[ 493] = 16'h3c45;
        mem[ 494] = 16'h3c77;
        mem[ 495] = 16'h3ca9;
        mem[ 496] = 16'h3cdc;
        mem[ 497] = 16'h3d0e;
        mem[ 498] = 16'h3d40;
        mem[ 499] = 16'h3d72;
        mem[ 500] = 16'h3da4;
        mem[ 501] = 16'h3dd7;
        mem[ 502] = 16'h3e09;
        mem[ 503] = 16'h3e3b;
        mem[ 504] = 16'h3e6d;
        mem[ 505] = 16'h3ea0;
        mem[ 506] = 16'h3ed2;
        mem[ 507] = 16'h3f04;
        mem[ 508] = 16'h3f36;
        mem[ 509] = 16'h3f69;
        mem[ 510] = 16'h3f9b;
        mem[ 511] = 16'h3fcd;
        mem[ 512] = 16'h3fff;
        mem[ 513] = 16'h4032;
        mem[ 514] = 16'h4064;
        mem[ 515] = 16'h4096;
        mem[ 516] = 16'h40c9;
        mem[ 517] = 16'h40fb;
        mem[ 518] = 16'h412d;
        mem[ 519] = 16'h415f;
        mem[ 520] = 16'h4192;
        mem[ 521] = 16'h41c4;
        mem[ 522] = 16'h41f6;
        mem[ 523] = 16'h4228;
        mem[ 524] = 16'h425b;
        mem[ 525] = 16'h428d;
        mem[ 526] = 16'h42bf;
        mem[ 527] = 16'h42f1;
        mem[ 528] = 16'h4323;
        mem[ 529] = 16'h4356;
        mem[ 530] = 16'h4388;
        mem[ 531] = 16'h43ba;
        mem[ 532] = 16'h43ec;
        mem[ 533] = 16'h441e;
        mem[ 534] = 16'h4450;
        mem[ 535] = 16'h4483;
        mem[ 536] = 16'h44b5;
        mem[ 537] = 16'h44e7;
        mem[ 538] = 16'h4519;
        mem[ 539] = 16'h454b;
        mem[ 540] = 16'h457d;
        mem[ 541] = 16'h45af;
        mem[ 542] = 16'h45e1;
        mem[ 543] = 16'h4613;
        mem[ 544] = 16'h4645;
        mem[ 545] = 16'h4677;
        mem[ 546] = 16'h46a9;
        mem[ 547] = 16'h46db;
        mem[ 548] = 16'h470d;
        mem[ 549] = 16'h473f;
        mem[ 550] = 16'h4771;
        mem[ 551] = 16'h47a3;
        mem[ 552] = 16'h47d5;
        mem[ 553] = 16'h4807;
        mem[ 554] = 16'h4839;
        mem[ 555] = 16'h486b;
        mem[ 556] = 16'h489c;
        mem[ 557] = 16'h48ce;
        mem[ 558] = 16'h4900;
        mem[ 559] = 16'h4932;
        mem[ 560] = 16'h4963;
        mem[ 561] = 16'h4995;
        mem[ 562] = 16'h49c7;
        mem[ 563] = 16'h49f9;
        mem[ 564] = 16'h4a2a;
        mem[ 565] = 16'h4a5c;
        mem[ 566] = 16'h4a8d;
        mem[ 567] = 16'h4abf;
        mem[ 568] = 16'h4af0;
        mem[ 569] = 16'h4b22;
        mem[ 570] = 16'h4b53;
        mem[ 571] = 16'h4b85;
        mem[ 572] = 16'h4bb6;
        mem[ 573] = 16'h4be8;
        mem[ 574] = 16'h4c19;
        mem[ 575] = 16'h4c4a;
        mem[ 576] = 16'h4c7c;
        mem[ 577] = 16'h4cad;
        mem[ 578] = 16'h4cde;
        mem[ 579] = 16'h4d10;
        mem[ 580] = 16'h4d41;
        mem[ 581] = 16'h4d72;
        mem[ 582] = 16'h4da3;
        mem[ 583] = 16'h4dd4;
        mem[ 584] = 16'h4e05;
        mem[ 585] = 16'h4e36;
        mem[ 586] = 16'h4e67;
        mem[ 587] = 16'h4e98;
        mem[ 588] = 16'h4ec9;
        mem[ 589] = 16'h4efa;
        mem[ 590] = 16'h4f2b;
        mem[ 591] = 16'h4f5c;
        mem[ 592] = 16'h4f8c;
        mem[ 593] = 16'h4fbd;
        mem[ 594] = 16'h4fee;
        mem[ 595] = 16'h501e;
        mem[ 596] = 16'h504f;
        mem[ 597] = 16'h5080;
        mem[ 598] = 16'h50b0;
        mem[ 599] = 16'h50e1;
        mem[ 600] = 16'h5111;
        mem[ 601] = 16'h5142;
        mem[ 602] = 16'h5172;
        mem[ 603] = 16'h51a2;
        mem[ 604] = 16'h51d3;
        mem[ 605] = 16'h5203;
        mem[ 606] = 16'h5233;
        mem[ 607] = 16'h5263;
        mem[ 608] = 16'h5293;
        mem[ 609] = 16'h52c3;
        mem[ 610] = 16'h52f3;
        mem[ 611] = 16'h5323;
        mem[ 612] = 16'h5353;
        mem[ 613] = 16'h5383;
        mem[ 614] = 16'h53b3;
        mem[ 615] = 16'h53e3;
        mem[ 616] = 16'h5413;
        mem[ 617] = 16'h5442;
        mem[ 618] = 16'h5472;
        mem[ 619] = 16'h54a2;
        mem[ 620] = 16'h54d1;
        mem[ 621] = 16'h5501;
        mem[ 622] = 16'h5530;
        mem[ 623] = 16'h5560;
        mem[ 624] = 16'h558f;
        mem[ 625] = 16'h55be;
        mem[ 626] = 16'h55ed;
        mem[ 627] = 16'h561d;
        mem[ 628] = 16'h564c;
        mem[ 629] = 16'h567b;
        mem[ 630] = 16'h56aa;
        mem[ 631] = 16'h56d9;
        mem[ 632] = 16'h5708;
        mem[ 633] = 16'h5737;
        mem[ 634] = 16'h5766;
        mem[ 635] = 16'h5794;
        mem[ 636] = 16'h57c3;
        mem[ 637] = 16'h57f2;
        mem[ 638] = 16'h5820;
        mem[ 639] = 16'h584f;
        mem[ 640] = 16'h587d;
        mem[ 641] = 16'h58ac;
        mem[ 642] = 16'h58da;
        mem[ 643] = 16'h5908;
        mem[ 644] = 16'h5936;
        mem[ 645] = 16'h5965;
        mem[ 646] = 16'h5993;
        mem[ 647] = 16'h59c1;
        mem[ 648] = 16'h59ef;
        mem[ 649] = 16'h5a1d;
        mem[ 650] = 16'h5a4b;
        mem[ 651] = 16'h5a78;
        mem[ 652] = 16'h5aa6;
        mem[ 653] = 16'h5ad4;
        mem[ 654] = 16'h5b01;
        mem[ 655] = 16'h5b2f;
        mem[ 656] = 16'h5b5c;
        mem[ 657] = 16'h5b8a;
        mem[ 658] = 16'h5bb7;
        mem[ 659] = 16'h5be4;
        mem[ 660] = 16'h5c12;
        mem[ 661] = 16'h5c3f;
        mem[ 662] = 16'h5c6c;
        mem[ 663] = 16'h5c99;
        mem[ 664] = 16'h5cc6;
        mem[ 665] = 16'h5cf3;
        mem[ 666] = 16'h5d1f;
        mem[ 667] = 16'h5d4c;
        mem[ 668] = 16'h5d79;
        mem[ 669] = 16'h5da5;
        mem[ 670] = 16'h5dd2;
        mem[ 671] = 16'h5dfe;
        mem[ 672] = 16'h5e2b;
        mem[ 673] = 16'h5e57;
        mem[ 674] = 16'h5e83;
        mem[ 675] = 16'h5eaf;
        mem[ 676] = 16'h5edb;
        mem[ 677] = 16'h5f07;
        mem[ 678] = 16'h5f33;
        mem[ 679] = 16'h5f5f;
        mem[ 680] = 16'h5f8b;
        mem[ 681] = 16'h5fb7;
        mem[ 682] = 16'h5fe2;
        mem[ 683] = 16'h600e;
        mem[ 684] = 16'h6039;
        mem[ 685] = 16'h6065;
        mem[ 686] = 16'h6090;
        mem[ 687] = 16'h60bb;
        mem[ 688] = 16'h60e6;
        mem[ 689] = 16'h6111;
        mem[ 690] = 16'h613c;
        mem[ 691] = 16'h6167;
        mem[ 692] = 16'h6192;
        mem[ 693] = 16'h61bd;
        mem[ 694] = 16'h61e8;
        mem[ 695] = 16'h6212;
        mem[ 696] = 16'h623d;
        mem[ 697] = 16'h6267;
        mem[ 698] = 16'h6291;
        mem[ 699] = 16'h62bc;
        mem[ 700] = 16'h62e6;
        mem[ 701] = 16'h6310;
        mem[ 702] = 16'h633a;
        mem[ 703] = 16'h6364;
        mem[ 704] = 16'h638e;
        mem[ 705] = 16'h63b7;
        mem[ 706] = 16'h63e1;
        mem[ 707] = 16'h640b;
        mem[ 708] = 16'h6434;
        mem[ 709] = 16'h645e;
        mem[ 710] = 16'h6487;
        mem[ 711] = 16'h64b0;
        mem[ 712] = 16'h64d9;
        mem[ 713] = 16'h6502;
        mem[ 714] = 16'h652b;
        mem[ 715] = 16'h6554;
        mem[ 716] = 16'h657d;
        mem[ 717] = 16'h65a6;
        mem[ 718] = 16'h65ce;
        mem[ 719] = 16'h65f7;
        mem[ 720] = 16'h661f;
        mem[ 721] = 16'h6647;
        mem[ 722] = 16'h6670;
        mem[ 723] = 16'h6698;
        mem[ 724] = 16'h66c0;
        mem[ 725] = 16'h66e8;
        mem[ 726] = 16'h6710;
        mem[ 727] = 16'h6737;
        mem[ 728] = 16'h675f;
        mem[ 729] = 16'h6787;
        mem[ 730] = 16'h67ae;
        mem[ 731] = 16'h67d6;
        mem[ 732] = 16'h67fd;
        mem[ 733] = 16'h6824;
        mem[ 734] = 16'h684b;
        mem[ 735] = 16'h6872;
        mem[ 736] = 16'h6899;
        mem[ 737] = 16'h68c0;
        mem[ 738] = 16'h68e7;
        mem[ 739] = 16'h690d;
        mem[ 740] = 16'h6934;
        mem[ 741] = 16'h695a;
        mem[ 742] = 16'h6980;
        mem[ 743] = 16'h69a7;
        mem[ 744] = 16'h69cd;
        mem[ 745] = 16'h69f3;
        mem[ 746] = 16'h6a19;
        mem[ 747] = 16'h6a3e;
        mem[ 748] = 16'h6a64;
        mem[ 749] = 16'h6a8a;
        mem[ 750] = 16'h6aaf;
        mem[ 751] = 16'h6ad5;
        mem[ 752] = 16'h6afa;
        mem[ 753] = 16'h6b1f;
        mem[ 754] = 16'h6b44;
        mem[ 755] = 16'h6b69;
        mem[ 756] = 16'h6b8e;
        mem[ 757] = 16'h6bb3;
        mem[ 758] = 16'h6bd8;
        mem[ 759] = 16'h6bfc;
        mem[ 760] = 16'h6c21;
        mem[ 761] = 16'h6c45;
        mem[ 762] = 16'h6c69;
        mem[ 763] = 16'h6c8d;
        mem[ 764] = 16'h6cb1;
        mem[ 765] = 16'h6cd5;
        mem[ 766] = 16'h6cf9;
        mem[ 767] = 16'h6d1d;
        mem[ 768] = 16'h6d40;
        mem[ 769] = 16'h6d64;
        mem[ 770] = 16'h6d87;
        mem[ 771] = 16'h6dab;
        mem[ 772] = 16'h6dce;
        mem[ 773] = 16'h6df1;
        mem[ 774] = 16'h6e14;
        mem[ 775] = 16'h6e36;
        mem[ 776] = 16'h6e59;
        mem[ 777] = 16'h6e7c;
        mem[ 778] = 16'h6e9e;
        mem[ 779] = 16'h6ec1;
        mem[ 780] = 16'h6ee3;
        mem[ 781] = 16'h6f05;
        mem[ 782] = 16'h6f27;
        mem[ 783] = 16'h6f49;
        mem[ 784] = 16'h6f6b;
        mem[ 785] = 16'h6f8d;
        mem[ 786] = 16'h6fae;
        mem[ 787] = 16'h6fd0;
        mem[ 788] = 16'h6ff1;
        mem[ 789] = 16'h7012;
        mem[ 790] = 16'h7033;
        mem[ 791] = 16'h7054;
        mem[ 792] = 16'h7075;
        mem[ 793] = 16'h7096;
        mem[ 794] = 16'h70b7;
        mem[ 795] = 16'h70d7;
        mem[ 796] = 16'h70f8;
        mem[ 797] = 16'h7118;
        mem[ 798] = 16'h7138;
        mem[ 799] = 16'h7158;
        mem[ 800] = 16'h7178;
        mem[ 801] = 16'h7198;
        mem[ 802] = 16'h71b8;
        mem[ 803] = 16'h71d7;
        mem[ 804] = 16'h71f7;
        mem[ 805] = 16'h7216;
        mem[ 806] = 16'h7235;
        mem[ 807] = 16'h7254;
        mem[ 808] = 16'h7273;
        mem[ 809] = 16'h7292;
        mem[ 810] = 16'h72b1;
        mem[ 811] = 16'h72d0;
        mem[ 812] = 16'h72ee;
        mem[ 813] = 16'h730c;
        mem[ 814] = 16'h732b;
        mem[ 815] = 16'h7349;
        mem[ 816] = 16'h7367;
        mem[ 817] = 16'h7385;
        mem[ 818] = 16'h73a2;
        mem[ 819] = 16'h73c0;
        mem[ 820] = 16'h73de;
        mem[ 821] = 16'h73fb;
        mem[ 822] = 16'h7418;
        mem[ 823] = 16'h7435;
        mem[ 824] = 16'h7452;
        mem[ 825] = 16'h746f;
        mem[ 826] = 16'h748c;
        mem[ 827] = 16'h74a9;
        mem[ 828] = 16'h74c5;
        mem[ 829] = 16'h74e2;
        mem[ 830] = 16'h74fe;
        mem[ 831] = 16'h751a;
        mem[ 832] = 16'h7536;
        mem[ 833] = 16'h7552;
        mem[ 834] = 16'h756d;
        mem[ 835] = 16'h7589;
        mem[ 836] = 16'h75a5;
        mem[ 837] = 16'h75c0;
        mem[ 838] = 16'h75db;
        mem[ 839] = 16'h75f6;
        mem[ 840] = 16'h7611;
        mem[ 841] = 16'h762c;
        mem[ 842] = 16'h7647;
        mem[ 843] = 16'h7661;
        mem[ 844] = 16'h767c;
        mem[ 845] = 16'h7696;
        mem[ 846] = 16'h76b0;
        mem[ 847] = 16'h76ca;
        mem[ 848] = 16'h76e4;
        mem[ 849] = 16'h76fe;
        mem[ 850] = 16'h7718;
        mem[ 851] = 16'h7731;
        mem[ 852] = 16'h774a;
        mem[ 853] = 16'h7764;
        mem[ 854] = 16'h777d;
        mem[ 855] = 16'h7796;
        mem[ 856] = 16'h77af;
        mem[ 857] = 16'h77c7;
        mem[ 858] = 16'h77e0;
        mem[ 859] = 16'h77f8;
        mem[ 860] = 16'h7811;
        mem[ 861] = 16'h7829;
        mem[ 862] = 16'h7841;
        mem[ 863] = 16'h7859;
        mem[ 864] = 16'h7870;
        mem[ 865] = 16'h7888;
        mem[ 866] = 16'h78a0;
        mem[ 867] = 16'h78b7;
        mem[ 868] = 16'h78ce;
        mem[ 869] = 16'h78e5;
        mem[ 870] = 16'h78fc;
        mem[ 871] = 16'h7913;
        mem[ 872] = 16'h792a;
        mem[ 873] = 16'h7940;
        mem[ 874] = 16'h7957;
        mem[ 875] = 16'h796d;
        mem[ 876] = 16'h7983;
        mem[ 877] = 16'h7999;
        mem[ 878] = 16'h79af;
        mem[ 879] = 16'h79c4;
        mem[ 880] = 16'h79da;
        mem[ 881] = 16'h79ef;
        mem[ 882] = 16'h7a05;
        mem[ 883] = 16'h7a1a;
        mem[ 884] = 16'h7a2f;
        mem[ 885] = 16'h7a44;
        mem[ 886] = 16'h7a58;
        mem[ 887] = 16'h7a6d;
        mem[ 888] = 16'h7a81;
        mem[ 889] = 16'h7a96;
        mem[ 890] = 16'h7aaa;
        mem[ 891] = 16'h7abe;
        mem[ 892] = 16'h7ad2;
        mem[ 893] = 16'h7ae6;
        mem[ 894] = 16'h7af9;
        mem[ 895] = 16'h7b0d;
        mem[ 896] = 16'h7b20;
        mem[ 897] = 16'h7b33;
        mem[ 898] = 16'h7b46;
        mem[ 899] = 16'h7b59;
        mem[ 900] = 16'h7b6c;
        mem[ 901] = 16'h7b7e;
        mem[ 902] = 16'h7b91;
        mem[ 903] = 16'h7ba3;
        mem[ 904] = 16'h7bb5;
        mem[ 905] = 16'h7bc7;
        mem[ 906] = 16'h7bd9;
        mem[ 907] = 16'h7beb;
        mem[ 908] = 16'h7bfc;
        mem[ 909] = 16'h7c0e;
        mem[ 910] = 16'h7c1f;
        mem[ 911] = 16'h7c30;
        mem[ 912] = 16'h7c41;
        mem[ 913] = 16'h7c52;
        mem[ 914] = 16'h7c63;
        mem[ 915] = 16'h7c73;
        mem[ 916] = 16'h7c84;
        mem[ 917] = 16'h7c94;
        mem[ 918] = 16'h7ca4;
        mem[ 919] = 16'h7cb4;
        mem[ 920] = 16'h7cc4;
        mem[ 921] = 16'h7cd4;
        mem[ 922] = 16'h7ce3;
        mem[ 923] = 16'h7cf3;
        mem[ 924] = 16'h7d02;
        mem[ 925] = 16'h7d11;
        mem[ 926] = 16'h7d20;
        mem[ 927] = 16'h7d2f;
        mem[ 928] = 16'h7d3e;
        mem[ 929] = 16'h7d4c;
        mem[ 930] = 16'h7d5a;
        mem[ 931] = 16'h7d69;
        mem[ 932] = 16'h7d77;
        mem[ 933] = 16'h7d85;
        mem[ 934] = 16'h7d92;
        mem[ 935] = 16'h7da0;
        mem[ 936] = 16'h7dae;
        mem[ 937] = 16'h7dbb;
        mem[ 938] = 16'h7dc8;
        mem[ 939] = 16'h7dd5;
        mem[ 940] = 16'h7de2;
        mem[ 941] = 16'h7def;
        mem[ 942] = 16'h7dfb;
        mem[ 943] = 16'h7e08;
        mem[ 944] = 16'h7e14;
        mem[ 945] = 16'h7e20;
        mem[ 946] = 16'h7e2c;
        mem[ 947] = 16'h7e38;
        mem[ 948] = 16'h7e44;
        mem[ 949] = 16'h7e4f;
        mem[ 950] = 16'h7e5b;
        mem[ 951] = 16'h7e66;
        mem[ 952] = 16'h7e71;
        mem[ 953] = 16'h7e7c;
        mem[ 954] = 16'h7e87;
        mem[ 955] = 16'h7e91;
        mem[ 956] = 16'h7e9c;
        mem[ 957] = 16'h7ea6;
        mem[ 958] = 16'h7eb0;
        mem[ 959] = 16'h7eba;
        mem[ 960] = 16'h7ec4;
        mem[ 961] = 16'h7ece;
        mem[ 962] = 16'h7ed8;
        mem[ 963] = 16'h7ee1;
        mem[ 964] = 16'h7eea;
        mem[ 965] = 16'h7ef3;
        mem[ 966] = 16'h7efc;
        mem[ 967] = 16'h7f05;
        mem[ 968] = 16'h7f0e;
        mem[ 969] = 16'h7f16;
        mem[ 970] = 16'h7f1f;
        mem[ 971] = 16'h7f27;
        mem[ 972] = 16'h7f2f;
        mem[ 973] = 16'h7f37;
        mem[ 974] = 16'h7f3f;
        mem[ 975] = 16'h7f46;
        mem[ 976] = 16'h7f4e;
        mem[ 977] = 16'h7f55;
        mem[ 978] = 16'h7f5c;
        mem[ 979] = 16'h7f63;
        mem[ 980] = 16'h7f6a;
        mem[ 981] = 16'h7f71;
        mem[ 982] = 16'h7f77;
        mem[ 983] = 16'h7f7e;
        mem[ 984] = 16'h7f84;
        mem[ 985] = 16'h7f8a;
        mem[ 986] = 16'h7f90;
        mem[ 987] = 16'h7f96;
        mem[ 988] = 16'h7f9b;
        mem[ 989] = 16'h7fa1;
        mem[ 990] = 16'h7fa6;
        mem[ 991] = 16'h7fab;
        mem[ 992] = 16'h7fb0;
        mem[ 993] = 16'h7fb5;
        mem[ 994] = 16'h7fba;
        mem[ 995] = 16'h7fbe;
        mem[ 996] = 16'h7fc3;
        mem[ 997] = 16'h7fc7;
        mem[ 998] = 16'h7fcb;
        mem[ 999] = 16'h7fcf;
        mem[1000] = 16'h7fd3;
        mem[1001] = 16'h7fd6;
        mem[1002] = 16'h7fda;
        mem[1003] = 16'h7fdd;
        mem[1004] = 16'h7fe0;
        mem[1005] = 16'h7fe3;
        mem[1006] = 16'h7fe6;
        mem[1007] = 16'h7fe9;
        mem[1008] = 16'h7feb;
        mem[1009] = 16'h7fee;
        mem[1010] = 16'h7ff0;
        mem[1011] = 16'h7ff2;
        mem[1012] = 16'h7ff4;
        mem[1013] = 16'h7ff6;
        mem[1014] = 16'h7ff7;
        mem[1015] = 16'h7ff9;
        mem[1016] = 16'h7ffa;
        mem[1017] = 16'h7ffb;
        mem[1018] = 16'h7ffc;
        mem[1019] = 16'h7ffd;
        mem[1020] = 16'h7ffe;
        mem[1021] = 16'h7ffe;
        mem[1022] = 16'h7fff;
        mem[1023] = 16'h7fff;
        mem[1024] = 16'h7fff;
        mem[1025] = 16'h7fff;
        mem[1026] = 16'h7fff;
        mem[1027] = 16'h7ffe;
        mem[1028] = 16'h7ffe;
        mem[1029] = 16'h7ffd;
        mem[1030] = 16'h7ffc;
        mem[1031] = 16'h7ffb;
        mem[1032] = 16'h7ffa;
        mem[1033] = 16'h7ff9;
        mem[1034] = 16'h7ff7;
        mem[1035] = 16'h7ff6;
        mem[1036] = 16'h7ff4;
        mem[1037] = 16'h7ff2;
        mem[1038] = 16'h7ff0;
        mem[1039] = 16'h7fee;
        mem[1040] = 16'h7feb;
        mem[1041] = 16'h7fe9;
        mem[1042] = 16'h7fe6;
        mem[1043] = 16'h7fe3;
        mem[1044] = 16'h7fe0;
        mem[1045] = 16'h7fdd;
        mem[1046] = 16'h7fda;
        mem[1047] = 16'h7fd6;
        mem[1048] = 16'h7fd3;
        mem[1049] = 16'h7fcf;
        mem[1050] = 16'h7fcb;
        mem[1051] = 16'h7fc7;
        mem[1052] = 16'h7fc3;
        mem[1053] = 16'h7fbe;
        mem[1054] = 16'h7fba;
        mem[1055] = 16'h7fb5;
        mem[1056] = 16'h7fb0;
        mem[1057] = 16'h7fab;
        mem[1058] = 16'h7fa6;
        mem[1059] = 16'h7fa1;
        mem[1060] = 16'h7f9b;
        mem[1061] = 16'h7f96;
        mem[1062] = 16'h7f90;
        mem[1063] = 16'h7f8a;
        mem[1064] = 16'h7f84;
        mem[1065] = 16'h7f7e;
        mem[1066] = 16'h7f77;
        mem[1067] = 16'h7f71;
        mem[1068] = 16'h7f6a;
        mem[1069] = 16'h7f63;
        mem[1070] = 16'h7f5c;
        mem[1071] = 16'h7f55;
        mem[1072] = 16'h7f4e;
        mem[1073] = 16'h7f46;
        mem[1074] = 16'h7f3f;
        mem[1075] = 16'h7f37;
        mem[1076] = 16'h7f2f;
        mem[1077] = 16'h7f27;
        mem[1078] = 16'h7f1f;
        mem[1079] = 16'h7f16;
        mem[1080] = 16'h7f0e;
        mem[1081] = 16'h7f05;
        mem[1082] = 16'h7efc;
        mem[1083] = 16'h7ef3;
        mem[1084] = 16'h7eea;
        mem[1085] = 16'h7ee1;
        mem[1086] = 16'h7ed8;
        mem[1087] = 16'h7ece;
        mem[1088] = 16'h7ec4;
        mem[1089] = 16'h7eba;
        mem[1090] = 16'h7eb0;
        mem[1091] = 16'h7ea6;
        mem[1092] = 16'h7e9c;
        mem[1093] = 16'h7e91;
        mem[1094] = 16'h7e87;
        mem[1095] = 16'h7e7c;
        mem[1096] = 16'h7e71;
        mem[1097] = 16'h7e66;
        mem[1098] = 16'h7e5b;
        mem[1099] = 16'h7e4f;
        mem[1100] = 16'h7e44;
        mem[1101] = 16'h7e38;
        mem[1102] = 16'h7e2c;
        mem[1103] = 16'h7e20;
        mem[1104] = 16'h7e14;
        mem[1105] = 16'h7e08;
        mem[1106] = 16'h7dfb;
        mem[1107] = 16'h7def;
        mem[1108] = 16'h7de2;
        mem[1109] = 16'h7dd5;
        mem[1110] = 16'h7dc8;
        mem[1111] = 16'h7dbb;
        mem[1112] = 16'h7dae;
        mem[1113] = 16'h7da0;
        mem[1114] = 16'h7d92;
        mem[1115] = 16'h7d85;
        mem[1116] = 16'h7d77;
        mem[1117] = 16'h7d69;
        mem[1118] = 16'h7d5a;
        mem[1119] = 16'h7d4c;
        mem[1120] = 16'h7d3e;
        mem[1121] = 16'h7d2f;
        mem[1122] = 16'h7d20;
        mem[1123] = 16'h7d11;
        mem[1124] = 16'h7d02;
        mem[1125] = 16'h7cf3;
        mem[1126] = 16'h7ce3;
        mem[1127] = 16'h7cd4;
        mem[1128] = 16'h7cc4;
        mem[1129] = 16'h7cb4;
        mem[1130] = 16'h7ca4;
        mem[1131] = 16'h7c94;
        mem[1132] = 16'h7c84;
        mem[1133] = 16'h7c73;
        mem[1134] = 16'h7c63;
        mem[1135] = 16'h7c52;
        mem[1136] = 16'h7c41;
        mem[1137] = 16'h7c30;
        mem[1138] = 16'h7c1f;
        mem[1139] = 16'h7c0e;
        mem[1140] = 16'h7bfc;
        mem[1141] = 16'h7beb;
        mem[1142] = 16'h7bd9;
        mem[1143] = 16'h7bc7;
        mem[1144] = 16'h7bb5;
        mem[1145] = 16'h7ba3;
        mem[1146] = 16'h7b91;
        mem[1147] = 16'h7b7e;
        mem[1148] = 16'h7b6c;
        mem[1149] = 16'h7b59;
        mem[1150] = 16'h7b46;
        mem[1151] = 16'h7b33;
        mem[1152] = 16'h7b20;
        mem[1153] = 16'h7b0d;
        mem[1154] = 16'h7af9;
        mem[1155] = 16'h7ae6;
        mem[1156] = 16'h7ad2;
        mem[1157] = 16'h7abe;
        mem[1158] = 16'h7aaa;
        mem[1159] = 16'h7a96;
        mem[1160] = 16'h7a81;
        mem[1161] = 16'h7a6d;
        mem[1162] = 16'h7a58;
        mem[1163] = 16'h7a44;
        mem[1164] = 16'h7a2f;
        mem[1165] = 16'h7a1a;
        mem[1166] = 16'h7a05;
        mem[1167] = 16'h79ef;
        mem[1168] = 16'h79da;
        mem[1169] = 16'h79c4;
        mem[1170] = 16'h79af;
        mem[1171] = 16'h7999;
        mem[1172] = 16'h7983;
        mem[1173] = 16'h796d;
        mem[1174] = 16'h7957;
        mem[1175] = 16'h7940;
        mem[1176] = 16'h792a;
        mem[1177] = 16'h7913;
        mem[1178] = 16'h78fc;
        mem[1179] = 16'h78e5;
        mem[1180] = 16'h78ce;
        mem[1181] = 16'h78b7;
        mem[1182] = 16'h78a0;
        mem[1183] = 16'h7888;
        mem[1184] = 16'h7870;
        mem[1185] = 16'h7859;
        mem[1186] = 16'h7841;
        mem[1187] = 16'h7829;
        mem[1188] = 16'h7811;
        mem[1189] = 16'h77f8;
        mem[1190] = 16'h77e0;
        mem[1191] = 16'h77c7;
        mem[1192] = 16'h77af;
        mem[1193] = 16'h7796;
        mem[1194] = 16'h777d;
        mem[1195] = 16'h7764;
        mem[1196] = 16'h774a;
        mem[1197] = 16'h7731;
        mem[1198] = 16'h7718;
        mem[1199] = 16'h76fe;
        mem[1200] = 16'h76e4;
        mem[1201] = 16'h76ca;
        mem[1202] = 16'h76b0;
        mem[1203] = 16'h7696;
        mem[1204] = 16'h767c;
        mem[1205] = 16'h7661;
        mem[1206] = 16'h7647;
        mem[1207] = 16'h762c;
        mem[1208] = 16'h7611;
        mem[1209] = 16'h75f6;
        mem[1210] = 16'h75db;
        mem[1211] = 16'h75c0;
        mem[1212] = 16'h75a5;
        mem[1213] = 16'h7589;
        mem[1214] = 16'h756d;
        mem[1215] = 16'h7552;
        mem[1216] = 16'h7536;
        mem[1217] = 16'h751a;
        mem[1218] = 16'h74fe;
        mem[1219] = 16'h74e2;
        mem[1220] = 16'h74c5;
        mem[1221] = 16'h74a9;
        mem[1222] = 16'h748c;
        mem[1223] = 16'h746f;
        mem[1224] = 16'h7452;
        mem[1225] = 16'h7435;
        mem[1226] = 16'h7418;
        mem[1227] = 16'h73fb;
        mem[1228] = 16'h73de;
        mem[1229] = 16'h73c0;
        mem[1230] = 16'h73a2;
        mem[1231] = 16'h7385;
        mem[1232] = 16'h7367;
        mem[1233] = 16'h7349;
        mem[1234] = 16'h732b;
        mem[1235] = 16'h730c;
        mem[1236] = 16'h72ee;
        mem[1237] = 16'h72d0;
        mem[1238] = 16'h72b1;
        mem[1239] = 16'h7292;
        mem[1240] = 16'h7273;
        mem[1241] = 16'h7254;
        mem[1242] = 16'h7235;
        mem[1243] = 16'h7216;
        mem[1244] = 16'h71f7;
        mem[1245] = 16'h71d7;
        mem[1246] = 16'h71b8;
        mem[1247] = 16'h7198;
        mem[1248] = 16'h7178;
        mem[1249] = 16'h7158;
        mem[1250] = 16'h7138;
        mem[1251] = 16'h7118;
        mem[1252] = 16'h70f8;
        mem[1253] = 16'h70d7;
        mem[1254] = 16'h70b7;
        mem[1255] = 16'h7096;
        mem[1256] = 16'h7075;
        mem[1257] = 16'h7054;
        mem[1258] = 16'h7033;
        mem[1259] = 16'h7012;
        mem[1260] = 16'h6ff1;
        mem[1261] = 16'h6fd0;
        mem[1262] = 16'h6fae;
        mem[1263] = 16'h6f8d;
        mem[1264] = 16'h6f6b;
        mem[1265] = 16'h6f49;
        mem[1266] = 16'h6f27;
        mem[1267] = 16'h6f05;
        mem[1268] = 16'h6ee3;
        mem[1269] = 16'h6ec1;
        mem[1270] = 16'h6e9e;
        mem[1271] = 16'h6e7c;
        mem[1272] = 16'h6e59;
        mem[1273] = 16'h6e36;
        mem[1274] = 16'h6e14;
        mem[1275] = 16'h6df1;
        mem[1276] = 16'h6dce;
        mem[1277] = 16'h6dab;
        mem[1278] = 16'h6d87;
        mem[1279] = 16'h6d64;
        mem[1280] = 16'h6d40;
        mem[1281] = 16'h6d1d;
        mem[1282] = 16'h6cf9;
        mem[1283] = 16'h6cd5;
        mem[1284] = 16'h6cb1;
        mem[1285] = 16'h6c8d;
        mem[1286] = 16'h6c69;
        mem[1287] = 16'h6c45;
        mem[1288] = 16'h6c21;
        mem[1289] = 16'h6bfc;
        mem[1290] = 16'h6bd8;
        mem[1291] = 16'h6bb3;
        mem[1292] = 16'h6b8e;
        mem[1293] = 16'h6b69;
        mem[1294] = 16'h6b44;
        mem[1295] = 16'h6b1f;
        mem[1296] = 16'h6afa;
        mem[1297] = 16'h6ad5;
        mem[1298] = 16'h6aaf;
        mem[1299] = 16'h6a8a;
        mem[1300] = 16'h6a64;
        mem[1301] = 16'h6a3e;
        mem[1302] = 16'h6a19;
        mem[1303] = 16'h69f3;
        mem[1304] = 16'h69cd;
        mem[1305] = 16'h69a7;
        mem[1306] = 16'h6980;
        mem[1307] = 16'h695a;
        mem[1308] = 16'h6934;
        mem[1309] = 16'h690d;
        mem[1310] = 16'h68e7;
        mem[1311] = 16'h68c0;
        mem[1312] = 16'h6899;
        mem[1313] = 16'h6872;
        mem[1314] = 16'h684b;
        mem[1315] = 16'h6824;
        mem[1316] = 16'h67fd;
        mem[1317] = 16'h67d6;
        mem[1318] = 16'h67ae;
        mem[1319] = 16'h6787;
        mem[1320] = 16'h675f;
        mem[1321] = 16'h6737;
        mem[1322] = 16'h6710;
        mem[1323] = 16'h66e8;
        mem[1324] = 16'h66c0;
        mem[1325] = 16'h6698;
        mem[1326] = 16'h6670;
        mem[1327] = 16'h6647;
        mem[1328] = 16'h661f;
        mem[1329] = 16'h65f7;
        mem[1330] = 16'h65ce;
        mem[1331] = 16'h65a6;
        mem[1332] = 16'h657d;
        mem[1333] = 16'h6554;
        mem[1334] = 16'h652b;
        mem[1335] = 16'h6502;
        mem[1336] = 16'h64d9;
        mem[1337] = 16'h64b0;
        mem[1338] = 16'h6487;
        mem[1339] = 16'h645e;
        mem[1340] = 16'h6434;
        mem[1341] = 16'h640b;
        mem[1342] = 16'h63e1;
        mem[1343] = 16'h63b7;
        mem[1344] = 16'h638e;
        mem[1345] = 16'h6364;
        mem[1346] = 16'h633a;
        mem[1347] = 16'h6310;
        mem[1348] = 16'h62e6;
        mem[1349] = 16'h62bc;
        mem[1350] = 16'h6291;
        mem[1351] = 16'h6267;
        mem[1352] = 16'h623d;
        mem[1353] = 16'h6212;
        mem[1354] = 16'h61e8;
        mem[1355] = 16'h61bd;
        mem[1356] = 16'h6192;
        mem[1357] = 16'h6167;
        mem[1358] = 16'h613c;
        mem[1359] = 16'h6111;
        mem[1360] = 16'h60e6;
        mem[1361] = 16'h60bb;
        mem[1362] = 16'h6090;
        mem[1363] = 16'h6065;
        mem[1364] = 16'h6039;
        mem[1365] = 16'h600e;
        mem[1366] = 16'h5fe2;
        mem[1367] = 16'h5fb7;
        mem[1368] = 16'h5f8b;
        mem[1369] = 16'h5f5f;
        mem[1370] = 16'h5f33;
        mem[1371] = 16'h5f07;
        mem[1372] = 16'h5edb;
        mem[1373] = 16'h5eaf;
        mem[1374] = 16'h5e83;
        mem[1375] = 16'h5e57;
        mem[1376] = 16'h5e2b;
        mem[1377] = 16'h5dfe;
        mem[1378] = 16'h5dd2;
        mem[1379] = 16'h5da5;
        mem[1380] = 16'h5d79;
        mem[1381] = 16'h5d4c;
        mem[1382] = 16'h5d1f;
        mem[1383] = 16'h5cf3;
        mem[1384] = 16'h5cc6;
        mem[1385] = 16'h5c99;
        mem[1386] = 16'h5c6c;
        mem[1387] = 16'h5c3f;
        mem[1388] = 16'h5c12;
        mem[1389] = 16'h5be4;
        mem[1390] = 16'h5bb7;
        mem[1391] = 16'h5b8a;
        mem[1392] = 16'h5b5c;
        mem[1393] = 16'h5b2f;
        mem[1394] = 16'h5b01;
        mem[1395] = 16'h5ad4;
        mem[1396] = 16'h5aa6;
        mem[1397] = 16'h5a78;
        mem[1398] = 16'h5a4b;
        mem[1399] = 16'h5a1d;
        mem[1400] = 16'h59ef;
        mem[1401] = 16'h59c1;
        mem[1402] = 16'h5993;
        mem[1403] = 16'h5965;
        mem[1404] = 16'h5936;
        mem[1405] = 16'h5908;
        mem[1406] = 16'h58da;
        mem[1407] = 16'h58ac;
        mem[1408] = 16'h587d;
        mem[1409] = 16'h584f;
        mem[1410] = 16'h5820;
        mem[1411] = 16'h57f2;
        mem[1412] = 16'h57c3;
        mem[1413] = 16'h5794;
        mem[1414] = 16'h5766;
        mem[1415] = 16'h5737;
        mem[1416] = 16'h5708;
        mem[1417] = 16'h56d9;
        mem[1418] = 16'h56aa;
        mem[1419] = 16'h567b;
        mem[1420] = 16'h564c;
        mem[1421] = 16'h561d;
        mem[1422] = 16'h55ed;
        mem[1423] = 16'h55be;
        mem[1424] = 16'h558f;
        mem[1425] = 16'h5560;
        mem[1426] = 16'h5530;
        mem[1427] = 16'h5501;
        mem[1428] = 16'h54d1;
        mem[1429] = 16'h54a2;
        mem[1430] = 16'h5472;
        mem[1431] = 16'h5442;
        mem[1432] = 16'h5413;
        mem[1433] = 16'h53e3;
        mem[1434] = 16'h53b3;
        mem[1435] = 16'h5383;
        mem[1436] = 16'h5353;
        mem[1437] = 16'h5323;
        mem[1438] = 16'h52f3;
        mem[1439] = 16'h52c3;
        mem[1440] = 16'h5293;
        mem[1441] = 16'h5263;
        mem[1442] = 16'h5233;
        mem[1443] = 16'h5203;
        mem[1444] = 16'h51d3;
        mem[1445] = 16'h51a2;
        mem[1446] = 16'h5172;
        mem[1447] = 16'h5142;
        mem[1448] = 16'h5111;
        mem[1449] = 16'h50e1;
        mem[1450] = 16'h50b0;
        mem[1451] = 16'h5080;
        mem[1452] = 16'h504f;
        mem[1453] = 16'h501e;
        mem[1454] = 16'h4fee;
        mem[1455] = 16'h4fbd;
        mem[1456] = 16'h4f8c;
        mem[1457] = 16'h4f5c;
        mem[1458] = 16'h4f2b;
        mem[1459] = 16'h4efa;
        mem[1460] = 16'h4ec9;
        mem[1461] = 16'h4e98;
        mem[1462] = 16'h4e67;
        mem[1463] = 16'h4e36;
        mem[1464] = 16'h4e05;
        mem[1465] = 16'h4dd4;
        mem[1466] = 16'h4da3;
        mem[1467] = 16'h4d72;
        mem[1468] = 16'h4d41;
        mem[1469] = 16'h4d10;
        mem[1470] = 16'h4cde;
        mem[1471] = 16'h4cad;
        mem[1472] = 16'h4c7c;
        mem[1473] = 16'h4c4a;
        mem[1474] = 16'h4c19;
        mem[1475] = 16'h4be8;
        mem[1476] = 16'h4bb6;
        mem[1477] = 16'h4b85;
        mem[1478] = 16'h4b53;
        mem[1479] = 16'h4b22;
        mem[1480] = 16'h4af0;
        mem[1481] = 16'h4abf;
        mem[1482] = 16'h4a8d;
        mem[1483] = 16'h4a5c;
        mem[1484] = 16'h4a2a;
        mem[1485] = 16'h49f9;
        mem[1486] = 16'h49c7;
        mem[1487] = 16'h4995;
        mem[1488] = 16'h4963;
        mem[1489] = 16'h4932;
        mem[1490] = 16'h4900;
        mem[1491] = 16'h48ce;
        mem[1492] = 16'h489c;
        mem[1493] = 16'h486b;
        mem[1494] = 16'h4839;
        mem[1495] = 16'h4807;
        mem[1496] = 16'h47d5;
        mem[1497] = 16'h47a3;
        mem[1498] = 16'h4771;
        mem[1499] = 16'h473f;
        mem[1500] = 16'h470d;
        mem[1501] = 16'h46db;
        mem[1502] = 16'h46a9;
        mem[1503] = 16'h4677;
        mem[1504] = 16'h4645;
        mem[1505] = 16'h4613;
        mem[1506] = 16'h45e1;
        mem[1507] = 16'h45af;
        mem[1508] = 16'h457d;
        mem[1509] = 16'h454b;
        mem[1510] = 16'h4519;
        mem[1511] = 16'h44e7;
        mem[1512] = 16'h44b5;
        mem[1513] = 16'h4483;
        mem[1514] = 16'h4450;
        mem[1515] = 16'h441e;
        mem[1516] = 16'h43ec;
        mem[1517] = 16'h43ba;
        mem[1518] = 16'h4388;
        mem[1519] = 16'h4356;
        mem[1520] = 16'h4323;
        mem[1521] = 16'h42f1;
        mem[1522] = 16'h42bf;
        mem[1523] = 16'h428d;
        mem[1524] = 16'h425b;
        mem[1525] = 16'h4228;
        mem[1526] = 16'h41f6;
        mem[1527] = 16'h41c4;
        mem[1528] = 16'h4192;
        mem[1529] = 16'h415f;
        mem[1530] = 16'h412d;
        mem[1531] = 16'h40fb;
        mem[1532] = 16'h40c9;
        mem[1533] = 16'h4096;
        mem[1534] = 16'h4064;
        mem[1535] = 16'h4032;
        mem[1536] = 16'h4000;
        mem[1537] = 16'h3fcd;
        mem[1538] = 16'h3f9b;
        mem[1539] = 16'h3f69;
        mem[1540] = 16'h3f36;
        mem[1541] = 16'h3f04;
        mem[1542] = 16'h3ed2;
        mem[1543] = 16'h3ea0;
        mem[1544] = 16'h3e6d;
        mem[1545] = 16'h3e3b;
        mem[1546] = 16'h3e09;
        mem[1547] = 16'h3dd7;
        mem[1548] = 16'h3da4;
        mem[1549] = 16'h3d72;
        mem[1550] = 16'h3d40;
        mem[1551] = 16'h3d0e;
        mem[1552] = 16'h3cdc;
        mem[1553] = 16'h3ca9;
        mem[1554] = 16'h3c77;
        mem[1555] = 16'h3c45;
        mem[1556] = 16'h3c13;
        mem[1557] = 16'h3be1;
        mem[1558] = 16'h3baf;
        mem[1559] = 16'h3b7c;
        mem[1560] = 16'h3b4a;
        mem[1561] = 16'h3b18;
        mem[1562] = 16'h3ae6;
        mem[1563] = 16'h3ab4;
        mem[1564] = 16'h3a82;
        mem[1565] = 16'h3a50;
        mem[1566] = 16'h3a1e;
        mem[1567] = 16'h39ec;
        mem[1568] = 16'h39ba;
        mem[1569] = 16'h3988;
        mem[1570] = 16'h3956;
        mem[1571] = 16'h3924;
        mem[1572] = 16'h38f2;
        mem[1573] = 16'h38c0;
        mem[1574] = 16'h388e;
        mem[1575] = 16'h385c;
        mem[1576] = 16'h382a;
        mem[1577] = 16'h37f8;
        mem[1578] = 16'h37c6;
        mem[1579] = 16'h3794;
        mem[1580] = 16'h3763;
        mem[1581] = 16'h3731;
        mem[1582] = 16'h36ff;
        mem[1583] = 16'h36cd;
        mem[1584] = 16'h369c;
        mem[1585] = 16'h366a;
        mem[1586] = 16'h3638;
        mem[1587] = 16'h3606;
        mem[1588] = 16'h35d5;
        mem[1589] = 16'h35a3;
        mem[1590] = 16'h3572;
        mem[1591] = 16'h3540;
        mem[1592] = 16'h350f;
        mem[1593] = 16'h34dd;
        mem[1594] = 16'h34ac;
        mem[1595] = 16'h347a;
        mem[1596] = 16'h3449;
        mem[1597] = 16'h3417;
        mem[1598] = 16'h33e6;
        mem[1599] = 16'h33b5;
        mem[1600] = 16'h3383;
        mem[1601] = 16'h3352;
        mem[1602] = 16'h3321;
        mem[1603] = 16'h32ef;
        mem[1604] = 16'h32be;
        mem[1605] = 16'h328d;
        mem[1606] = 16'h325c;
        mem[1607] = 16'h322b;
        mem[1608] = 16'h31fa;
        mem[1609] = 16'h31c9;
        mem[1610] = 16'h3198;
        mem[1611] = 16'h3167;
        mem[1612] = 16'h3136;
        mem[1613] = 16'h3105;
        mem[1614] = 16'h30d4;
        mem[1615] = 16'h30a3;
        mem[1616] = 16'h3073;
        mem[1617] = 16'h3042;
        mem[1618] = 16'h3011;
        mem[1619] = 16'h2fe1;
        mem[1620] = 16'h2fb0;
        mem[1621] = 16'h2f7f;
        mem[1622] = 16'h2f4f;
        mem[1623] = 16'h2f1e;
        mem[1624] = 16'h2eee;
        mem[1625] = 16'h2ebd;
        mem[1626] = 16'h2e8d;
        mem[1627] = 16'h2e5d;
        mem[1628] = 16'h2e2c;
        mem[1629] = 16'h2dfc;
        mem[1630] = 16'h2dcc;
        mem[1631] = 16'h2d9c;
        mem[1632] = 16'h2d6c;
        mem[1633] = 16'h2d3c;
        mem[1634] = 16'h2d0c;
        mem[1635] = 16'h2cdc;
        mem[1636] = 16'h2cac;
        mem[1637] = 16'h2c7c;
        mem[1638] = 16'h2c4c;
        mem[1639] = 16'h2c1c;
        mem[1640] = 16'h2bec;
        mem[1641] = 16'h2bbd;
        mem[1642] = 16'h2b8d;
        mem[1643] = 16'h2b5d;
        mem[1644] = 16'h2b2e;
        mem[1645] = 16'h2afe;
        mem[1646] = 16'h2acf;
        mem[1647] = 16'h2a9f;
        mem[1648] = 16'h2a70;
        mem[1649] = 16'h2a41;
        mem[1650] = 16'h2a12;
        mem[1651] = 16'h29e2;
        mem[1652] = 16'h29b3;
        mem[1653] = 16'h2984;
        mem[1654] = 16'h2955;
        mem[1655] = 16'h2926;
        mem[1656] = 16'h28f7;
        mem[1657] = 16'h28c8;
        mem[1658] = 16'h2899;
        mem[1659] = 16'h286b;
        mem[1660] = 16'h283c;
        mem[1661] = 16'h280d;
        mem[1662] = 16'h27df;
        mem[1663] = 16'h27b0;
        mem[1664] = 16'h2782;
        mem[1665] = 16'h2753;
        mem[1666] = 16'h2725;
        mem[1667] = 16'h26f7;
        mem[1668] = 16'h26c9;
        mem[1669] = 16'h269a;
        mem[1670] = 16'h266c;
        mem[1671] = 16'h263e;
        mem[1672] = 16'h2610;
        mem[1673] = 16'h25e2;
        mem[1674] = 16'h25b4;
        mem[1675] = 16'h2587;
        mem[1676] = 16'h2559;
        mem[1677] = 16'h252b;
        mem[1678] = 16'h24fe;
        mem[1679] = 16'h24d0;
        mem[1680] = 16'h24a3;
        mem[1681] = 16'h2475;
        mem[1682] = 16'h2448;
        mem[1683] = 16'h241b;
        mem[1684] = 16'h23ed;
        mem[1685] = 16'h23c0;
        mem[1686] = 16'h2393;
        mem[1687] = 16'h2366;
        mem[1688] = 16'h2339;
        mem[1689] = 16'h230c;
        mem[1690] = 16'h22e0;
        mem[1691] = 16'h22b3;
        mem[1692] = 16'h2286;
        mem[1693] = 16'h225a;
        mem[1694] = 16'h222d;
        mem[1695] = 16'h2201;
        mem[1696] = 16'h21d4;
        mem[1697] = 16'h21a8;
        mem[1698] = 16'h217c;
        mem[1699] = 16'h2150;
        mem[1700] = 16'h2124;
        mem[1701] = 16'h20f8;
        mem[1702] = 16'h20cc;
        mem[1703] = 16'h20a0;
        mem[1704] = 16'h2074;
        mem[1705] = 16'h2048;
        mem[1706] = 16'h201d;
        mem[1707] = 16'h1ff1;
        mem[1708] = 16'h1fc6;
        mem[1709] = 16'h1f9a;
        mem[1710] = 16'h1f6f;
        mem[1711] = 16'h1f44;
        mem[1712] = 16'h1f19;
        mem[1713] = 16'h1eee;
        mem[1714] = 16'h1ec3;
        mem[1715] = 16'h1e98;
        mem[1716] = 16'h1e6d;
        mem[1717] = 16'h1e42;
        mem[1718] = 16'h1e17;
        mem[1719] = 16'h1ded;
        mem[1720] = 16'h1dc2;
        mem[1721] = 16'h1d98;
        mem[1722] = 16'h1d6e;
        mem[1723] = 16'h1d43;
        mem[1724] = 16'h1d19;
        mem[1725] = 16'h1cef;
        mem[1726] = 16'h1cc5;
        mem[1727] = 16'h1c9b;
        mem[1728] = 16'h1c71;
        mem[1729] = 16'h1c48;
        mem[1730] = 16'h1c1e;
        mem[1731] = 16'h1bf4;
        mem[1732] = 16'h1bcb;
        mem[1733] = 16'h1ba1;
        mem[1734] = 16'h1b78;
        mem[1735] = 16'h1b4f;
        mem[1736] = 16'h1b26;
        mem[1737] = 16'h1afd;
        mem[1738] = 16'h1ad4;
        mem[1739] = 16'h1aab;
        mem[1740] = 16'h1a82;
        mem[1741] = 16'h1a59;
        mem[1742] = 16'h1a31;
        mem[1743] = 16'h1a08;
        mem[1744] = 16'h19e0;
        mem[1745] = 16'h19b8;
        mem[1746] = 16'h198f;
        mem[1747] = 16'h1967;
        mem[1748] = 16'h193f;
        mem[1749] = 16'h1917;
        mem[1750] = 16'h18ef;
        mem[1751] = 16'h18c8;
        mem[1752] = 16'h18a0;
        mem[1753] = 16'h1878;
        mem[1754] = 16'h1851;
        mem[1755] = 16'h1829;
        mem[1756] = 16'h1802;
        mem[1757] = 16'h17db;
        mem[1758] = 16'h17b4;
        mem[1759] = 16'h178d;
        mem[1760] = 16'h1766;
        mem[1761] = 16'h173f;
        mem[1762] = 16'h1718;
        mem[1763] = 16'h16f2;
        mem[1764] = 16'h16cb;
        mem[1765] = 16'h16a5;
        mem[1766] = 16'h167f;
        mem[1767] = 16'h1658;
        mem[1768] = 16'h1632;
        mem[1769] = 16'h160c;
        mem[1770] = 16'h15e6;
        mem[1771] = 16'h15c1;
        mem[1772] = 16'h159b;
        mem[1773] = 16'h1575;
        mem[1774] = 16'h1550;
        mem[1775] = 16'h152a;
        mem[1776] = 16'h1505;
        mem[1777] = 16'h14e0;
        mem[1778] = 16'h14bb;
        mem[1779] = 16'h1496;
        mem[1780] = 16'h1471;
        mem[1781] = 16'h144c;
        mem[1782] = 16'h1427;
        mem[1783] = 16'h1403;
        mem[1784] = 16'h13de;
        mem[1785] = 16'h13ba;
        mem[1786] = 16'h1396;
        mem[1787] = 16'h1372;
        mem[1788] = 16'h134e;
        mem[1789] = 16'h132a;
        mem[1790] = 16'h1306;
        mem[1791] = 16'h12e2;
        mem[1792] = 16'h12bf;
        mem[1793] = 16'h129b;
        mem[1794] = 16'h1278;
        mem[1795] = 16'h1254;
        mem[1796] = 16'h1231;
        mem[1797] = 16'h120e;
        mem[1798] = 16'h11eb;
        mem[1799] = 16'h11c9;
        mem[1800] = 16'h11a6;
        mem[1801] = 16'h1183;
        mem[1802] = 16'h1161;
        mem[1803] = 16'h113e;
        mem[1804] = 16'h111c;
        mem[1805] = 16'h10fa;
        mem[1806] = 16'h10d8;
        mem[1807] = 16'h10b6;
        mem[1808] = 16'h1094;
        mem[1809] = 16'h1072;
        mem[1810] = 16'h1051;
        mem[1811] = 16'h102f;
        mem[1812] = 16'h100e;
        mem[1813] = 16'h0fed;
        mem[1814] = 16'h0fcc;
        mem[1815] = 16'h0fab;
        mem[1816] = 16'h0f8a;
        mem[1817] = 16'h0f69;
        mem[1818] = 16'h0f48;
        mem[1819] = 16'h0f28;
        mem[1820] = 16'h0f07;
        mem[1821] = 16'h0ee7;
        mem[1822] = 16'h0ec7;
        mem[1823] = 16'h0ea7;
        mem[1824] = 16'h0e87;
        mem[1825] = 16'h0e67;
        mem[1826] = 16'h0e47;
        mem[1827] = 16'h0e28;
        mem[1828] = 16'h0e08;
        mem[1829] = 16'h0de9;
        mem[1830] = 16'h0dca;
        mem[1831] = 16'h0dab;
        mem[1832] = 16'h0d8c;
        mem[1833] = 16'h0d6d;
        mem[1834] = 16'h0d4e;
        mem[1835] = 16'h0d2f;
        mem[1836] = 16'h0d11;
        mem[1837] = 16'h0cf3;
        mem[1838] = 16'h0cd4;
        mem[1839] = 16'h0cb6;
        mem[1840] = 16'h0c98;
        mem[1841] = 16'h0c7a;
        mem[1842] = 16'h0c5d;
        mem[1843] = 16'h0c3f;
        mem[1844] = 16'h0c21;
        mem[1845] = 16'h0c04;
        mem[1846] = 16'h0be7;
        mem[1847] = 16'h0bca;
        mem[1848] = 16'h0bad;
        mem[1849] = 16'h0b90;
        mem[1850] = 16'h0b73;
        mem[1851] = 16'h0b56;
        mem[1852] = 16'h0b3a;
        mem[1853] = 16'h0b1d;
        mem[1854] = 16'h0b01;
        mem[1855] = 16'h0ae5;
        mem[1856] = 16'h0ac9;
        mem[1857] = 16'h0aad;
        mem[1858] = 16'h0a92;
        mem[1859] = 16'h0a76;
        mem[1860] = 16'h0a5a;
        mem[1861] = 16'h0a3f;
        mem[1862] = 16'h0a24;
        mem[1863] = 16'h0a09;
        mem[1864] = 16'h09ee;
        mem[1865] = 16'h09d3;
        mem[1866] = 16'h09b8;
        mem[1867] = 16'h099e;
        mem[1868] = 16'h0983;
        mem[1869] = 16'h0969;
        mem[1870] = 16'h094f;
        mem[1871] = 16'h0935;
        mem[1872] = 16'h091b;
        mem[1873] = 16'h0901;
        mem[1874] = 16'h08e7;
        mem[1875] = 16'h08ce;
        mem[1876] = 16'h08b5;
        mem[1877] = 16'h089b;
        mem[1878] = 16'h0882;
        mem[1879] = 16'h0869;
        mem[1880] = 16'h0850;
        mem[1881] = 16'h0838;
        mem[1882] = 16'h081f;
        mem[1883] = 16'h0807;
        mem[1884] = 16'h07ee;
        mem[1885] = 16'h07d6;
        mem[1886] = 16'h07be;
        mem[1887] = 16'h07a6;
        mem[1888] = 16'h078f;
        mem[1889] = 16'h0777;
        mem[1890] = 16'h075f;
        mem[1891] = 16'h0748;
        mem[1892] = 16'h0731;
        mem[1893] = 16'h071a;
        mem[1894] = 16'h0703;
        mem[1895] = 16'h06ec;
        mem[1896] = 16'h06d5;
        mem[1897] = 16'h06bf;
        mem[1898] = 16'h06a8;
        mem[1899] = 16'h0692;
        mem[1900] = 16'h067c;
        mem[1901] = 16'h0666;
        mem[1902] = 16'h0650;
        mem[1903] = 16'h063b;
        mem[1904] = 16'h0625;
        mem[1905] = 16'h0610;
        mem[1906] = 16'h05fa;
        mem[1907] = 16'h05e5;
        mem[1908] = 16'h05d0;
        mem[1909] = 16'h05bb;
        mem[1910] = 16'h05a7;
        mem[1911] = 16'h0592;
        mem[1912] = 16'h057e;
        mem[1913] = 16'h0569;
        mem[1914] = 16'h0555;
        mem[1915] = 16'h0541;
        mem[1916] = 16'h052d;
        mem[1917] = 16'h0519;
        mem[1918] = 16'h0506;
        mem[1919] = 16'h04f2;
        mem[1920] = 16'h04df;
        mem[1921] = 16'h04cc;
        mem[1922] = 16'h04b9;
        mem[1923] = 16'h04a6;
        mem[1924] = 16'h0493;
        mem[1925] = 16'h0481;
        mem[1926] = 16'h046e;
        mem[1927] = 16'h045c;
        mem[1928] = 16'h044a;
        mem[1929] = 16'h0438;
        mem[1930] = 16'h0426;
        mem[1931] = 16'h0414;
        mem[1932] = 16'h0403;
        mem[1933] = 16'h03f1;
        mem[1934] = 16'h03e0;
        mem[1935] = 16'h03cf;
        mem[1936] = 16'h03be;
        mem[1937] = 16'h03ad;
        mem[1938] = 16'h039c;
        mem[1939] = 16'h038c;
        mem[1940] = 16'h037b;
        mem[1941] = 16'h036b;
        mem[1942] = 16'h035b;
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
        mem[2041] = 16'h0004;
        mem[2042] = 16'h0003;
        mem[2043] = 16'h0002;
        mem[2044] = 16'h0001;
        mem[2045] = 16'h0001;
        mem[2046] = 16'h0000;
        mem[2047] = 16'h0000;
    end
    always @(posedge clk) dout <= mem[addr];
endmodule
