3321485853ray-hue/Rhythm-of-Notes/fpga/src/label_rom.v

// label_rom.v —— 160x45 字符屏的静态标签（720p，原点 y=8）

module label_rom (
    input  wire        clk,
    input  wire [12:0] addr,
    output reg  [7:0]  dout = 8'd0
);
    reg [7:0] mem [0:8191];
    initial begin
        // row  0
        mem[   0] = 8'h20;
        mem[   1] = 8'h20;
        mem[   2] = 8'h20;
        mem[   3] = 8'h20;
        mem[   4] = 8'h20;
        mem[   5] = 8'h20;
        mem[   6] = 8'h20;
        mem[   7] = 8'h20;
        mem[   8] = 8'h20;
        mem[   9] = 8'h20;
        mem[  10] = 8'h20;
        mem[  11] = 8'h20;
        mem[  12] = 8'h20;
        mem[  13] = 8'h20;
        mem[  14] = 8'h20;
        mem[  15] = 8'h20;
        mem[  16] = 8'h20;
        mem[  17] = 8'h20;
        mem[  18] = 8'h20;
        mem[  19] = 8'h20;
        mem[  20] = 8'h20;
        mem[  21] = 8'h20;
        mem[  22] = 8'h20;
        mem[  23] = 8'h20;
        mem[  24] = 8'h20;
        mem[  25] = 8'h20;
        mem[  26] = 8'h20;
        mem[  27] = 8'h20;
        mem[  28] = 8'h20;
        mem[  29] = 8'h20;
        mem[  30] = 8'h20;
        mem[  31] = 8'h20;
        mem[  32] = 8'h20;
        mem[  33] = 8'h20;
        mem[  34] = 8'h20;
        mem[  35] = 8'h20;
        mem[  36] = 8'h20;
        mem[  37] = 8'h20;
        mem[  38] = 8'h20;
        mem[  39] = 8'h20;
        mem[  40] = 8'h20;
        mem[  41] = 8'h20;
        mem[  42] = 8'h20;
        mem[  43] = 8'h20;
        mem[  44] = 8'h20;
        mem[  45] = 8'h20;
        mem[  46] = 8'h20;
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
        mem[4393] = 8'h20;
        mem[4394] = 8'h20;
        mem[4395] = 8'h20;
        mem[4396] = 8'h20;
        mem[4397] = 8'h20;
        mem[4398] = 8'h20;
        mem[4399] = 8'h20;
        mem[4400] = 8'h20;
        mem[4401] = 8'h20;
        mem[4402] = 8'h20;
        mem[4403] = 8'h20;
        mem[4404] = 8'h20;
        mem[4405] = 8'h20;
        mem[4406] = 8'h20;
        mem[4407] = 8'h20;
        mem[4408] = 8'h20;
        mem[4409] = 8'h20;
        mem[4410] = 8'h20;
        mem[4411] = 8'h20;
        mem[4412] = 8'h20;
        mem[4413] = 8'h20;
        mem[4414] = 8'h20;
        mem[4415] = 8'h20;
        mem[4416] = 8'h20;
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
