3321485853ray-hue/Rhythm-of-Notes/fpga/src/sine_rom.v

// sine_rom.v — 1024 点 × 16 位有符号正弦表（一个完整周期，10 位地址）

module sine_rom (
    input  wire               clk,
    input  wire [9:0]         addr,
    output reg  signed [15:0] dout = 16'sd0
);
reg signed [15:0] mem [0:1023];
initial begin
    mem[   0] = 16'h0000;
    mem[   1] = 16'h00B8;
    mem[   2] = 16'h0170;
    mem[   3] = 16'h0228;
    mem[   4] = 16'h02E0;
    mem[   5] = 16'h0398;
    mem[   6] = 16'h0450;
    mem[   7] = 16'h0508;
    mem[   8] = 16'h05C0;
    mem[   9] = 16'h0678;
    mem[  10] = 16'h0730;
    mem[  11] = 16'h07E7;
    mem[  12] = 16'h089F;
    mem[  13] = 16'h0956;
    mem[  14] = 16'h0A0E;
    mem[  15] = 16'h0AC5;
    mem[  16] = 16'h0B7D;
    mem[  17] = 16'h0C34;
    mem[  18] = 16'h0CEB;
    mem[  19] = 16'h0DA2;
    mem[  20] = 16'h0E58;
    mem[  21] = 16'h0F0F;
    mem[  22] = 16'h0FC5;
    mem[  23] = 16'h107C;
    mem[  24] = 16'h1132;
    mem[  25] = 16'h11E8;
    mem[  26] = 16'h129E;
    mem[  27] = 16'h1353;
    mem[  28] = 16'h1409;
    mem[  29] = 16'h14BE;
    mem[  30] = 16'h1573;
    mem[  31] = 16'h1628;
    mem[  32] = 16'h16DD;
    mem[  33] = 16'h1791;
    mem[  34] = 16'h1845;
    mem[  35] = 16'h18F9;
    mem[  36] = 16'h19AD;
    mem[  37] = 16'h1A61;
    mem[  38] = 16'h1B14;
    mem[  39] = 16'h1BC7;
    mem[  40] = 16'h1C79;
    mem[  41] = 16'h1D2C;
    mem[  42] = 16'h1DDE;
    mem[  43] = 16'h1E90;
    mem[  44] = 16'h1F41;
    mem[  45] = 16'h1FF3;
    mem[  46] = 16'h20A4;
    mem[  47] = 16'h2154;
    mem[  48] = 16'h2205;
    mem[  49] = 16'h22B5;
    mem[  50] = 16'h2364;
    mem[  51] = 16'h2413;
    mem[  52] = 16'h24C2;
    mem[  53] = 16'h2571;
    mem[  54] = 16'h261F;
    mem[  55] = 16'h26CD;
    mem[  56] = 16'h277B;
    mem[  57] = 16'h2828;
    mem[  58] = 16'h28D5;
    mem[  59] = 16'h2981;
    mem[  60] = 16'h2A2D;
    mem[  61] = 16'h2AD8;
    mem[  62] = 16'h2B84;
    mem[  63] = 16'h2C2E;
    mem[  64] = 16'h2CD9;
    mem[  65] = 16'h2D82;
    mem[  66] = 16'h2E2C;
    mem[  67] = 16'h2ED5;
    mem[  68] = 16'h2F7D;
    mem[  69] = 16'h3025;
    mem[  70] = 16'h30CD;
    mem[  71] = 16'h3174;
    mem[  72] = 16'h321B;
    mem[  73] = 16'h32C1;
    mem[  74] = 16'h3366;
    mem[  75] = 16'h340C;
    mem[  76] = 16'h34B0;
    mem[  77] = 16'h3555;
    mem[  78] = 16'h35F8;
    mem[  79] = 16'h369B;
    mem[  80] = 16'h373E;
    mem[  81] = 16'h37E0;
    mem[  82] = 16'h3882;
    mem[  83] = 16'h3923;
    mem[  84] = 16'h39C3;
    mem[  85] = 16'h3A63;
    mem[  86] = 16'h3B02;
    mem[  87] = 16'h3BA1;
    mem[  88] = 16'h3C3F;
    mem[  89] = 16'h3CDD;
    mem[  90] = 16'h3D7A;
    mem[  91] = 16'h3E16;
    mem[  92] = 16'h3EB2;
    mem[  93] = 16'h3F4D;
    mem[  94] = 16'h3FE8;
    mem[  95] = 16'h4082;
    mem[  96] = 16'h411B;
    mem[  97] = 16'h41B4;
    mem[  98] = 16'h424C;
    mem[  99] = 16'h42E3;
    mem[ 100] = 16'h437A;
    mem[ 101] = 16'h4410;
    mem[ 102] = 16'h44A6;
    mem[ 103] = 16'h453B;
    mem[ 104] = 16'h45CF;
    mem[ 105] = 16'h4662;
    mem[ 106] = 16'h46F5;
    mem[ 107] = 16'h4787;
    mem[ 108] = 16'h4819;
    mem[ 109] = 16'h48AA;
    mem[ 110] = 16'h493A;
    mem[ 111] = 16'h49C9;
    mem[ 112] = 16'h4A58;
    mem[ 113] = 16'h4AE6;
    mem[ 114] = 16'h4B73;
    mem[ 115] = 16'h4BFF;
    mem[ 116] = 16'h4C8B;
    mem[ 117] = 16'h4D16;
    mem[ 118] = 16'h4DA0;
    mem[ 119] = 16'h4E2A;
    mem[ 120] = 16'h4EB3;
    mem[ 121] = 16'h4F3B;
    mem[ 122] = 16'h4FC2;
    mem[ 123] = 16'h5049;
    mem[ 124] = 16'h50CE;
    mem[ 125] = 16'h5153;
    mem[ 126] = 16'h51D7;
    mem[ 127] = 16'h525B;
    mem[ 128] = 16'h52DD;
    mem[ 129] = 16'h535F;
    mem[ 130] = 16'h53E0;
    mem[ 131] = 16'h5460;
    mem[ 132] = 16'h54DF;
    mem[ 133] = 16'h555E;
    mem[ 134] = 16'h55DC;
    mem[ 135] = 16'h5658;
    mem[ 136] = 16'h56D5;
    mem[ 137] = 16'h5750;
    mem[ 138] = 16'h57CA;
    mem[ 139] = 16'h5844;
    mem[ 140] = 16'h58BC;
    mem[ 141] = 16'h5934;
    mem[ 142] = 16'h59AB;
    mem[ 143] = 16'h5A21;
    mem[ 144] = 16'h5A96;
    mem[ 145] = 16'h5B0B;
    mem[ 146] = 16'h5B7E;
    mem[ 147] = 16'h5BF1;
    mem[ 148] = 16'h5C62;
    mem[ 149] = 16'h5CD3;
    mem[ 150] = 16'h5D43;
    mem[ 151] = 16'h5DB2;
    mem[ 152] = 16'h5E20;
    mem[ 153] = 16'h5E8D;
    mem[ 154] = 16'h5EFA;
    mem[ 155] = 16'h5F65;
    mem[ 156] = 16'h5FD0;
    mem[ 157] = 16'h6039;
    mem[ 158] = 16'h60A2;
    mem[ 159] = 16'h6109;
    mem[ 160] = 16'h6170;
    mem[ 161] = 16'h61D6;
    mem[ 162] = 16'h623B;
    mem[ 163] = 16'h629F;
    mem[ 164] = 16'h6302;
    mem[ 165] = 16'h6364;
    mem[ 166] = 16'h63C5;
    mem[ 167] = 16'h6425;
    mem[ 168] = 16'h6484;
    mem[ 169] = 16'h64E2;
    mem[ 170] = 16'h653F;
    mem[ 171] = 16'h659B;
    mem[ 172] = 16'h65F7;
    mem[ 173] = 16'h6651;
    mem[ 174] = 16'h66AA;
    mem[ 175] = 16'h6702;
    mem[ 176] = 16'h675A;
    mem[ 177] = 16'h67B0;
    mem[ 178] = 16'h6805;
    mem[ 179] = 16'h6859;
    mem[ 180] = 16'h68AD;
    mem[ 181] = 16'h68FF;
    mem[ 182] = 16'h6950;
    mem[ 183] = 16'h69A0;
    mem[ 184] = 16'h69F0;
    mem[ 185] = 16'h6A3E;
    mem[ 186] = 16'h6A8B;
    mem[ 187] = 16'h6AD7;
    mem[ 188] = 16'h6B22;
    mem[ 189] = 16'h6B6C;
    mem[ 190] = 16'h6BB5;
    mem[ 191] = 16'h6BFD;
    mem[ 192] = 16'h6C44;
    mem[ 193] = 16'h6C8A;
    mem[ 194] = 16'h6CCF;
    mem[ 195] = 16'h6D13;
    mem[ 196] = 16'h6D56;
    mem[ 197] = 16'h6D98;
    mem[ 198] = 16'h6DD8;
    mem[ 199] = 16'h6E18;
    mem[ 200] = 16'h6E56;
    mem[ 201] = 16'h6E94;
    mem[ 202] = 16'h6ED0;
    mem[ 203] = 16'h6F0C;
    mem[ 204] = 16'h6F46;
    mem[ 205] = 16'h6F7F;
    mem[ 206] = 16'h6FB7;
    mem[ 207] = 16'h6FEE;
    mem[ 208] = 16'h7024;
    mem[ 209] = 16'h7059;
    mem[ 210] = 16'h708D;
    mem[ 211] = 16'h70C0;
    mem[ 212] = 16'h70F1;
    mem[ 213] = 16'h7122;
    mem[ 214] = 16'h7151;
    mem[ 215] = 16'h7180;
    mem[ 216] = 16'h71AD;
    mem[ 217] = 16'h71D9;
    mem[ 218] = 16'h7204;
    mem[ 219] = 16'h722E;
    mem[ 220] = 16'h7257;
    mem[ 221] = 16'h727F;
    mem[ 222] = 16'h72A6;
    mem[ 223] = 16'h72CB;
    mem[ 224] = 16'h72F0;
    mem[ 225] = 16'h7313;
    mem[ 226] = 16'h7335;
    mem[ 227] = 16'h7356;
    mem[ 228] = 16'h7376;
    mem[ 229] = 16'h7395;
    mem[ 230] = 16'h73B3;
    mem[ 231] = 16'h73D0;
    mem[ 232] = 16'h73EB;
    mem[ 233] = 16'h7406;
    mem[ 234] = 16'h741F;
    mem[ 235] = 16'h7437;
    mem[ 236] = 16'h744E;
    mem[ 237] = 16'h7464;
    mem[ 238] = 16'h7479;
    mem[ 239] = 16'h748D;
    mem[ 240] = 16'h74A0;
    mem[ 241] = 16'h74B1;
    mem[ 242] = 16'h74C1;
    mem[ 243] = 16'h74D1;
    mem[ 244] = 16'h74DF;
    mem[ 245] = 16'h74EC;
    mem[ 246] = 16'h74F8;
    mem[ 247] = 16'h7502;
    mem[ 248] = 16'h750C;
    mem[ 249] = 16'h7514;
    mem[ 250] = 16'h751C;
    mem[ 251] = 16'h7522;
    mem[ 252] = 16'h7527;
    mem[ 253] = 16'h752B;
    mem[ 254] = 16'h752E;
    mem[ 255] = 16'h752F;
    mem[ 256] = 16'h7530;
    mem[ 257] = 16'h752F;
    mem[ 258] = 16'h752E;
    mem[ 259] = 16'h752B;
    mem[ 260] = 16'h7527;
    mem[ 261] = 16'h7522;
    mem[ 262] = 16'h751C;
    mem[ 263] = 16'h7514;
    mem[ 264] = 16'h750C;
    mem[ 265] = 16'h7502;
    mem[ 266] = 16'h74F8;
    mem[ 267] = 16'h74EC;
    mem[ 268] = 16'h74DF;
    mem[ 269] = 16'h74D1;
    mem[ 270] = 16'h74C1;
    mem[ 271] = 16'h74B1;
    mem[ 272] = 16'h74A0;
    mem[ 273] = 16'h748D;
    mem[ 274] = 16'h7479;
    mem[ 275] = 16'h7464;
    mem[ 276] = 16'h744E;
    mem[ 277] = 16'h7437;
    mem[ 278] = 16'h741F;
    mem[ 279] = 16'h7406;
    mem[ 280] = 16'h73EB;
    mem[ 281] = 16'h73D0;
    mem[ 282] = 16'h73B3;
    mem[ 283] = 16'h7395;
    mem[ 284] = 16'h7376;
    mem[ 285] = 16'h7356;
    mem[ 286] = 16'h7335;
    mem[ 287] = 16'h7313;
    mem[ 288] = 16'h72F0;
    mem[ 289] = 16'h72CB;
    mem[ 290] = 16'h72A6;
    mem[ 291] = 16'h727F;
    mem[ 292] = 16'h7257;
    mem[ 293] = 16'h722E;
    mem[ 294] = 16'h7204;
    mem[ 295] = 16'h71D9;
    mem[ 296] = 16'h71AD;
    mem[ 297] = 16'h7180;
    mem[ 298] = 16'h7151;
    mem[ 299] = 16'h7122;
    mem[ 300] = 16'h70F1;
    mem[ 301] = 16'h70C0;
    mem[ 302] = 16'h708D;
    mem[ 303] = 16'h7059;
    mem[ 304] = 16'h7024;
    mem[ 305] = 16'h6FEE;
    mem[ 306] = 16'h6FB7;
    mem[ 307] = 16'h6F7F;
    mem[ 308] = 16'h6F46;
    mem[ 309] = 16'h6F0C;
    mem[ 310] = 16'h6ED0;
    mem[ 311] = 16'h6E94;
    mem[ 312] = 16'h6E56;
    mem[ 313] = 16'h6E18;
    mem[ 314] = 16'h6DD8;
    mem[ 315] = 16'h6D98;
    mem[ 316] = 16'h6D56;
    mem[ 317] = 16'h6D13;
    mem[ 318] = 16'h6CCF;
    mem[ 319] = 16'h6C8A;
    mem[ 320] = 16'h6C44;
    mem[ 321] = 16'h6BFD;
    mem[ 322] = 16'h6BB5;
    mem[ 323] = 16'h6B6C;
    mem[ 324] = 16'h6B22;
    mem[ 325] = 16'h6AD7;
    mem[ 326] = 16'h6A8B;
    mem[ 327] = 16'h6A3E;
    mem[ 328] = 16'h69F0;
    mem[ 329] = 16'h69A0;
    mem[ 330] = 16'h6950;
    mem[ 331] = 16'h68FF;
    mem[ 332] = 16'h68AD;
    mem[ 333] = 16'h6859;
    mem[ 334] = 16'h6805;
    mem[ 335] = 16'h67B0;
    mem[ 336] = 16'h675A;
    mem[ 337] = 16'h6702;
    mem[ 338] = 16'h66AA;
    mem[ 339] = 16'h6651;
    mem[ 340] = 16'h65F7;
    mem[ 341] = 16'h659B;
    mem[ 342] = 16'h653F;
    mem[ 343] = 16'h64E2;
    mem[ 344] = 16'h6484;
    mem[ 345] = 16'h6425;
    mem[ 346] = 16'h63C5;
    mem[ 347] = 16'h6364;
    mem[ 348] = 16'h6302;
    mem[ 349] = 16'h629F;
    mem[ 350] = 16'h623B;
    mem[ 351] = 16'h61D6;
    mem[ 352] = 16'h6170;
    mem[ 353] = 16'h6109;
    mem[ 354] = 16'h60A2;
    mem[ 355] = 16'h6039;
    mem[ 356] = 16'h5FD0;
    mem[ 357] = 16'h5F65;
    mem[ 358] = 16'h5EFA;
    mem[ 359] = 16'h5E8D;
    mem[ 360] = 16'h5E20;
    mem[ 361] = 16'h5DB2;
    mem[ 362] = 16'h5D43;
    mem[ 363] = 16'h5CD3;
    mem[ 364] = 16'h5C62;
    mem[ 365] = 16'h5BF1;
    mem[ 366] = 16'h5B7E;
    mem[ 367] = 16'h5B0B;
    mem[ 368] = 16'h5A96;
    mem[ 369] = 16'h5A21;
    mem[ 370] = 16'h59AB;
    mem[ 371] = 16'h5934;
    mem[ 372] = 16'h58BC;
    mem[ 373] = 16'h5844;
    mem[ 374] = 16'h57CA;
    mem[ 375] = 16'h5750;
    mem[ 376] = 16'h56D5;
    mem[ 377] = 16'h5658;
    mem[ 378] = 16'h55DC;
    mem[ 379] = 16'h555E;
    mem[ 380] = 16'h54DF;
    mem[ 381] = 16'h5460;
    mem[ 382] = 16'h53E0;
    mem[ 383] = 16'h535F;
    mem[ 384] = 16'h52DD;
    mem[ 385] = 16'h525B;
    mem[ 386] = 16'h51D7;
    mem[ 387] = 16'h5153;
    mem[ 388] = 16'h50CE;
    mem[ 389] = 16'h5049;
    mem[ 390] = 16'h4FC2;
    mem[ 391] = 16'h4F3B;
    mem[ 392] = 16'h4EB3;
    mem[ 393] = 16'h4E2A;
    mem[ 394] = 16'h4DA0;
    mem[ 395] = 16'h4D16;
    mem[ 396] = 16'h4C8B;
    mem[ 397] = 16'h4BFF;
    mem[ 398] = 16'h4B73;
    mem[ 399] = 16'h4AE6;
    mem[ 400] = 16'h4A58;
    mem[ 401] = 16'h49C9;
    mem[ 402] = 16'h493A;
    mem[ 403] = 16'h48AA;
    mem[ 404] = 16'h4819;
    mem[ 405] = 16'h4787;
    mem[ 406] = 16'h46F5;
    mem[ 407] = 16'h4662;
    mem[ 408] = 16'h45CF;
    mem[ 409] = 16'h453B;
    mem[ 410] = 16'h44A6;
    mem[ 411] = 16'h4410;
    mem[ 412] = 16'h437A;
    mem[ 413] = 16'h42E3;
    mem[ 414] = 16'h424C;
    mem[ 415] = 16'h41B4;
    mem[ 416] = 16'h411B;
    mem[ 417] = 16'h4082;
    mem[ 418] = 16'h3FE8;
    mem[ 419] = 16'h3F4D;
    mem[ 420] = 16'h3EB2;
    mem[ 421] = 16'h3E16;
    mem[ 422] = 16'h3D7A;
    mem[ 423] = 16'h3CDD;
    mem[ 424] = 16'h3C3F;
    mem[ 425] = 16'h3BA1;
    mem[ 426] = 16'h3B02;
    mem[ 427] = 16'h3A63;
    mem[ 428] = 16'h39C3;
    mem[ 429] = 16'h3923;
    mem[ 430] = 16'h3882;
    mem[ 431] = 16'h37E0;
    mem[ 432] = 16'h373E;
    mem[ 433] = 16'h369B;
    mem[ 434] = 16'h35F8;
    mem[ 435] = 16'h3555;
    mem[ 436] = 16'h34B0;
    mem[ 437] = 16'h340C;
    mem[ 438] = 16'h3366;
    mem[ 439] = 16'h32C1;
    mem[ 440] = 16'h321B;
    mem[ 441] = 16'h3174;
    mem[ 442] = 16'h30CD;
    mem[ 443] = 16'h3025;
    mem[ 444] = 16'h2F7D;
    mem[ 445] = 16'h2ED5;
    mem[ 446] = 16'h2E2C;
    mem[ 447] = 16'h2D82;
    mem[ 448] = 16'h2CD9;
    mem[ 449] = 16'h2C2E;
    mem[ 450] = 16'h2B84;
    mem[ 451] = 16'h2AD8;
    mem[ 452] = 16'h2A2D;
    mem[ 453] = 16'h2981;
    mem[ 454] = 16'h28D5;
    mem[ 455] = 16'h2828;
    mem[ 456] = 16'h277B;
    mem[ 457] = 16'h26CD;
    mem[ 458] = 16'h261F;
    mem[ 459] = 16'h2571;
    mem[ 460] = 16'h24C2;
    mem[ 461] = 16'h2413;
    mem[ 462] = 16'h2364;
    mem[ 463] = 16'h22B5;
    mem[ 464] = 16'h2205;
    mem[ 465] = 16'h2154;
    mem[ 466] = 16'h20A4;
    mem[ 467] = 16'h1FF3;
    mem[ 468] = 16'h1F41;
    mem[ 469] = 16'h1E90;
    mem[ 470] = 16'h1DDE;
    mem[ 471] = 16'h1D2C;
    mem[ 472] = 16'h1C79;
    mem[ 473] = 16'h1BC7;
    mem[ 474] = 16'h1B14;
    mem[ 475] = 16'h1A61;
    mem[ 476] = 16'h19AD;
    mem[ 477] = 16'h18F9;
    mem[ 478] = 16'h1845;
    mem[ 479] = 16'h1791;
    mem[ 480] = 16'h16DD;
    mem[ 481] = 16'h1628;
    mem[ 482] = 16'h1573;
    mem[ 483] = 16'h14BE;
    mem[ 484] = 16'h1409;
    mem[ 485] = 16'h1353;
    mem[ 486] = 16'h129E;
    mem[ 487] = 16'h11E8;
    mem[ 488] = 16'h1132;
    mem[ 489] = 16'h107C;
    mem[ 490] = 16'h0FC5;
    mem[ 491] = 16'h0F0F;
    mem[ 492] = 16'h0E58;
    mem[ 493] = 16'h0DA2;
    mem[ 494] = 16'h0CEB;
    mem[ 495] = 16'h0C34;
    mem[ 496] = 16'h0B7D;
    mem[ 497] = 16'h0AC5;
    mem[ 498] = 16'h0A0E;
    mem[ 499] = 16'h0956;
    mem[ 500] = 16'h089F;
    mem[ 501] = 16'h07E7;
    mem[ 502] = 16'h0730;
    mem[ 503] = 16'h0678;
    mem[ 504] = 16'h05C0;
    mem[ 505] = 16'h0508;
    mem[ 506] = 16'h0450;
    mem[ 507] = 16'h0398;
    mem[ 508] = 16'h02E0;
    mem[ 509] = 16'h0228;
    mem[ 510] = 16'h0170;
    mem[ 511] = 16'h00B8;
    mem[ 512] = 16'h0000;
    mem[ 513] = 16'hFF48;
    mem[ 514] = 16'hFE90;
    mem[ 515] = 16'hFDD8;
    mem[ 516] = 16'hFD20;
    mem[ 517] = 16'hFC68;
    mem[ 518] = 16'hFBB0;
    mem[ 519] = 16'hFAF8;
    mem[ 520] = 16'hFA40;
    mem[ 521] = 16'hF988;
    mem[ 522] = 16'hF8D0;
    mem[ 523] = 16'hF819;
    mem[ 524] = 16'hF761;
    mem[ 525] = 16'hF6AA;
    mem[ 526] = 16'hF5F2;
    mem[ 527] = 16'hF53B;
    mem[ 528] = 16'hF483;
    mem[ 529] = 16'hF3CC;
    mem[ 530] = 16'hF315;
    mem[ 531] = 16'hF25E;
    mem[ 532] = 16'hF1A8;
    mem[ 533] = 16'hF0F1;
    mem[ 534] = 16'hF03B;
    mem[ 535] = 16'hEF84;
    mem[ 536] = 16'hEECE;
    mem[ 537] = 16'hEE18;
    mem[ 538] = 16'hED62;
    mem[ 539] = 16'hECAD;
    mem[ 540] = 16'hEBF7;
    mem[ 541] = 16'hEB42;
    mem[ 542] = 16'hEA8D;
    mem[ 543] = 16'hE9D8;
    mem[ 544] = 16'hE923;
    mem[ 545] = 16'hE86F;
    mem[ 546] = 16'hE7BB;
    mem[ 547] = 16'hE707;
    mem[ 548] = 16'hE653;
    mem[ 549] = 16'hE59F;
    mem[ 550] = 16'hE4EC;
    mem[ 551] = 16'hE439;
    mem[ 552] = 16'hE387;
    mem[ 553] = 16'hE2D4;
    mem[ 554] = 16'hE222;
    mem[ 555] = 16'hE170;
    mem[ 556] = 16'hE0BF;
    mem[ 557] = 16'hE00D;
    mem[ 558] = 16'hDF5C;
    mem[ 559] = 16'hDEAC;
    mem[ 560] = 16'hDDFB;
    mem[ 561] = 16'hDD4B;
    mem[ 562] = 16'hDC9C;
    mem[ 563] = 16'hDBED;
    mem[ 564] = 16'hDB3E;
    mem[ 565] = 16'hDA8F;
    mem[ 566] = 16'hD9E1;
    mem[ 567] = 16'hD933;
    mem[ 568] = 16'hD885;
    mem[ 569] = 16'hD7D8;
    mem[ 570] = 16'hD72B;
    mem[ 571] = 16'hD67F;
    mem[ 572] = 16'hD5D3;
    mem[ 573] = 16'hD528;
    mem[ 574] = 16'hD47C;
    mem[ 575] = 16'hD3D2;
    mem[ 576] = 16'hD327;
    mem[ 577] = 16'hD27E;
    mem[ 578] = 16'hD1D4;
    mem[ 579] = 16'hD12B;
    mem[ 580] = 16'hD083;
    mem[ 581] = 16'hCFDB;
    mem[ 582] = 16'hCF33;
    mem[ 583] = 16'hCE8C;
    mem[ 584] = 16'hCDE5;
    mem[ 585] = 16'hCD3F;
    mem[ 586] = 16'hCC9A;
    mem[ 587] = 16'hCBF4;
    mem[ 588] = 16'hCB50;
    mem[ 589] = 16'hCAAB;
    mem[ 590] = 16'hCA08;
    mem[ 591] = 16'hC965;
    mem[ 592] = 16'hC8C2;
    mem[ 593] = 16'hC820;
    mem[ 594] = 16'hC77E;
    mem[ 595] = 16'hC6DD;
    mem[ 596] = 16'hC63D;
    mem[ 597] = 16'hC59D;
    mem[ 598] = 16'hC4FE;
    mem[ 599] = 16'hC45F;
    mem[ 600] = 16'hC3C1;
    mem[ 601] = 16'hC323;
    mem[ 602] = 16'hC286;
    mem[ 603] = 16'hC1EA;
    mem[ 604] = 16'hC14E;
    mem[ 605] = 16'hC0B3;
    mem[ 606] = 16'hC018;
    mem[ 607] = 16'hBF7E;
    mem[ 608] = 16'hBEE5;
    mem[ 609] = 16'hBE4C;
    mem[ 610] = 16'hBDB4;
    mem[ 611] = 16'hBD1D;
    mem[ 612] = 16'hBC86;
    mem[ 613] = 16'hBBF0;
    mem[ 614] = 16'hBB5A;
    mem[ 615] = 16'hBAC5;
    mem[ 616] = 16'hBA31;
    mem[ 617] = 16'hB99E;
    mem[ 618] = 16'hB90B;
    mem[ 619] = 16'hB879;
    mem[ 620] = 16'hB7E7;
    mem[ 621] = 16'hB756;
    mem[ 622] = 16'hB6C6;
    mem[ 623] = 16'hB637;
    mem[ 624] = 16'hB5A8;
    mem[ 625] = 16'hB51A;
    mem[ 626] = 16'hB48D;
    mem[ 627] = 16'hB401;
    mem[ 628] = 16'hB375;
    mem[ 629] = 16'hB2EA;
    mem[ 630] = 16'hB260;
    mem[ 631] = 16'hB1D6;
    mem[ 632] = 16'hB14D;
    mem[ 633] = 16'hB0C5;
    mem[ 634] = 16'hB03E;
    mem[ 635] = 16'hAFB7;
    mem[ 636] = 16'hAF32;
    mem[ 637] = 16'hAEAD;
    mem[ 638] = 16'hAE29;
    mem[ 639] = 16'hADA5;
    mem[ 640] = 16'hAD23;
    mem[ 641] = 16'hACA1;
    mem[ 642] = 16'hAC20;
    mem[ 643] = 16'hABA0;
    mem[ 644] = 16'hAB21;
    mem[ 645] = 16'hAAA2;
    mem[ 646] = 16'hAA24;
    mem[ 647] = 16'hA9A8;
    mem[ 648] = 16'hA92B;
    mem[ 649] = 16'hA8B0;
    mem[ 650] = 16'hA836;
    mem[ 651] = 16'hA7BC;
    mem[ 652] = 16'hA744;
    mem[ 653] = 16'hA6CC;
    mem[ 654] = 16'hA655;
    mem[ 655] = 16'hA5DF;
    mem[ 656] = 16'hA56A;
    mem[ 657] = 16'hA4F5;
    mem[ 658] = 16'hA482;
    mem[ 659] = 16'hA40F;
    mem[ 660] = 16'hA39E;
    mem[ 661] = 16'hA32D;
    mem[ 662] = 16'hA2BD;
    mem[ 663] = 16'hA24E;
    mem[ 664] = 16'hA1E0;
    mem[ 665] = 16'hA173;
    mem[ 666] = 16'hA106;
    mem[ 667] = 16'hA09B;
    mem[ 668] = 16'hA030;
    mem[ 669] = 16'h9FC7;
    mem[ 670] = 16'h9F5E;
    mem[ 671] = 16'h9EF7;
    mem[ 672] = 16'h9E90;
    mem[ 673] = 16'h9E2A;
    mem[ 674] = 16'h9DC5;
    mem[ 675] = 16'h9D61;
    mem[ 676] = 16'h9CFE;
    mem[ 677] = 16'h9C9C;
    mem[ 678] = 16'h9C3B;
    mem[ 679] = 16'h9BDB;
    mem[ 680] = 16'h9B7C;
    mem[ 681] = 16'h9B1E;
    mem[ 682] = 16'h9AC1;
    mem[ 683] = 16'h9A65;
    mem[ 684] = 16'h9A09;
    mem[ 685] = 16'h99AF;
    mem[ 686] = 16'h9956;
    mem[ 687] = 16'h98FE;
    mem[ 688] = 16'h98A6;
    mem[ 689] = 16'h9850;
    mem[ 690] = 16'h97FB;
    mem[ 691] = 16'h97A7;
    mem[ 692] = 16'h9753;
    mem[ 693] = 16'h9701;
    mem[ 694] = 16'h96B0;
    mem[ 695] = 16'h9660;
    mem[ 696] = 16'h9610;
    mem[ 697] = 16'h95C2;
    mem[ 698] = 16'h9575;
    mem[ 699] = 16'h9529;
    mem[ 700] = 16'h94DE;
    mem[ 701] = 16'h9494;
    mem[ 702] = 16'h944B;
    mem[ 703] = 16'h9403;
    mem[ 704] = 16'h93BC;
    mem[ 705] = 16'h9376;
    mem[ 706] = 16'h9331;
    mem[ 707] = 16'h92ED;
    mem[ 708] = 16'h92AA;
    mem[ 709] = 16'h9268;
    mem[ 710] = 16'h9228;
    mem[ 711] = 16'h91E8;
    mem[ 712] = 16'h91AA;
    mem[ 713] = 16'h916C;
    mem[ 714] = 16'h9130;
    mem[ 715] = 16'h90F4;
    mem[ 716] = 16'h90BA;
    mem[ 717] = 16'h9081;
    mem[ 718] = 16'h9049;
    mem[ 719] = 16'h9012;
    mem[ 720] = 16'h8FDC;
    mem[ 721] = 16'h8FA7;
    mem[ 722] = 16'h8F73;
    mem[ 723] = 16'h8F40;
    mem[ 724] = 16'h8F0F;
    mem[ 725] = 16'h8EDE;
    mem[ 726] = 16'h8EAF;
    mem[ 727] = 16'h8E80;
    mem[ 728] = 16'h8E53;
    mem[ 729] = 16'h8E27;
    mem[ 730] = 16'h8DFC;
    mem[ 731] = 16'h8DD2;
    mem[ 732] = 16'h8DA9;
    mem[ 733] = 16'h8D81;
    mem[ 734] = 16'h8D5A;
    mem[ 735] = 16'h8D35;
    mem[ 736] = 16'h8D10;
    mem[ 737] = 16'h8CED;
    mem[ 738] = 16'h8CCB;
    mem[ 739] = 16'h8CAA;
    mem[ 740] = 16'h8C8A;
    mem[ 741] = 16'h8C6B;
    mem[ 742] = 16'h8C4D;
    mem[ 743] = 16'h8C30;
    mem[ 744] = 16'h8C15;
    mem[ 745] = 16'h8BFA;
    mem[ 746] = 16'h8BE1;
    mem[ 747] = 16'h8BC9;
    mem[ 748] = 16'h8BB2;
    mem[ 749] = 16'h8B9C;
    mem[ 750] = 16'h8B87;
    mem[ 751] = 16'h8B73;
    mem[ 752] = 16'h8B60;
    mem[ 753] = 16'h8B4F;
    mem[ 754] = 16'h8B3F;
    mem[ 755] = 16'h8B2F;
    mem[ 756] = 16'h8B21;
    mem[ 757] = 16'h8B14;
    mem[ 758] = 16'h8B08;
    mem[ 759] = 16'h8AFE;
    mem[ 760] = 16'h8AF4;
    mem[ 761] = 16'h8AEC;
    mem[ 762] = 16'h8AE4;
    mem[ 763] = 16'h8ADE;
    mem[ 764] = 16'h8AD9;
    mem[ 765] = 16'h8AD5;
    mem[ 766] = 16'h8AD2;
    mem[ 767] = 16'h8AD1;
    mem[ 768] = 16'h8AD0;
    mem[ 769] = 16'h8AD1;
    mem[ 770] = 16'h8AD2;
    mem[ 771] = 16'h8AD5;
    mem[ 772] = 16'h8AD9;
    mem[ 773] = 16'h8ADE;
    mem[ 774] = 16'h8AE4;
    mem[ 775] = 16'h8AEC;
    mem[ 776] = 16'h8AF4;
    mem[ 777] = 16'h8AFE;
    mem[ 778] = 16'h8B08;
    mem[ 779] = 16'h8B14;
    mem[ 780] = 16'h8B21;
    mem[ 781] = 16'h8B2F;
    mem[ 782] = 16'h8B3F;
    mem[ 783] = 16'h8B4F;
    mem[ 784] = 16'h8B60;
    mem[ 785] = 16'h8B73;
    mem[ 786] = 16'h8B87;
    mem[ 787] = 16'h8B9C;
    mem[ 788] = 16'h8BB2;
    mem[ 789] = 16'h8BC9;
    mem[ 790] = 16'h8BE1;
    mem[ 791] = 16'h8BFA;
    mem[ 792] = 16'h8C15;
    mem[ 793] = 16'h8C30;
    mem[ 794] = 16'h8C4D;
    mem[ 795] = 16'h8C6B;
    mem[ 796] = 16'h8C8A;
    mem[ 797] = 16'h8CAA;
    mem[ 798] = 16'h8CCB;
    mem[ 799] = 16'h8CED;
    mem[ 800] = 16'h8D10;
    mem[ 801] = 16'h8D35;
    mem[ 802] = 16'h8D5A;
    mem[ 803] = 16'h8D81;
    mem[ 804] = 16'h8DA9;
    mem[ 805] = 16'h8DD2;
    mem[ 806] = 16'h8DFC;
    mem[ 807] = 16'h8E27;
    mem[ 808] = 16'h8E53;
    mem[ 809] = 16'h8E80;
    mem[ 810] = 16'h8EAF;
    mem[ 811] = 16'h8EDE;
    mem[ 812] = 16'h8F0F;
    mem[ 813] = 16'h8F40;
    mem[ 814] = 16'h8F73;
    mem[ 815] = 16'h8FA7;
    mem[ 816] = 16'h8FDC;
    mem[ 817] = 16'h9012;
    mem[ 818] = 16'h9049;
    mem[ 819] = 16'h9081;
    mem[ 820] = 16'h90BA;
    mem[ 821] = 16'h90F4;
    mem[ 822] = 16'h9130;
    mem[ 823] = 16'h916C;
    mem[ 824] = 16'h91AA;
    mem[ 825] = 16'h91E8;
    mem[ 826] = 16'h9228;
    mem[ 827] = 16'h9268;
    mem[ 828] = 16'h92AA;
    mem[ 829] = 16'h92ED;
    mem[ 830] = 16'h9331;
    mem[ 831] = 16'h9376;
    mem[ 832] = 16'h93BC;
    mem[ 833] = 16'h9403;
    mem[ 834] = 16'h944B;
    mem[ 835] = 16'h9494;
    mem[ 836] = 16'h94DE;
    mem[ 837] = 16'h9529;
    mem[ 838] = 16'h9575;
    mem[ 839] = 16'h95C2;
    mem[ 840] = 16'h9610;
    mem[ 841] = 16'h9660;
    mem[ 842] = 16'h96B0;
    mem[ 843] = 16'h9701;
    mem[ 844] = 16'h9753;
    mem[ 845] = 16'h97A7;
    mem[ 846] = 16'h97FB;
    mem[ 847] = 16'h9850;
    mem[ 848] = 16'h98A6;
    mem[ 849] = 16'h98FE;
    mem[ 850] = 16'h9956;
    mem[ 851] = 16'h99AF;
    mem[ 852] = 16'h9A09;
    mem[ 853] = 16'h9A65;
    mem[ 854] = 16'h9AC1;
    mem[ 855] = 16'h9B1E;
    mem[ 856] = 16'h9B7C;
    mem[ 857] = 16'h9BDB;
    mem[ 858] = 16'h9C3B;
    mem[ 859] = 16'h9C9C;
    mem[ 860] = 16'h9CFE;
    mem[ 861] = 16'h9D61;
    mem[ 862] = 16'h9DC5;
    mem[ 863] = 16'h9E2A;
    mem[ 864] = 16'h9E90;
    mem[ 865] = 16'h9EF7;
    mem[ 866] = 16'h9F5E;
    mem[ 867] = 16'h9FC7;
    mem[ 868] = 16'hA030;
    mem[ 869] = 16'hA09B;
    mem[ 870] = 16'hA106;
    mem[ 871] = 16'hA173;
    mem[ 872] = 16'hA1E0;
    mem[ 873] = 16'hA24E;
    mem[ 874] = 16'hA2BD;
    mem[ 875] = 16'hA32D;
    mem[ 876] = 16'hA39E;
    mem[ 877] = 16'hA40F;
    mem[ 878] = 16'hA482;
    mem[ 879] = 16'hA4F5;
    mem[ 880] = 16'hA56A;
    mem[ 881] = 16'hA5DF;
    mem[ 882] = 16'hA655;
    mem[ 883] = 16'hA6CC;
    mem[ 884] = 16'hA744;
    mem[ 885] = 16'hA7BC;
    mem[ 886] = 16'hA836;
    mem[ 887] = 16'hA8B0;
    mem[ 888] = 16'hA92B;
    mem[ 889] = 16'hA9A8;
    mem[ 890] = 16'hAA24;
    mem[ 891] = 16'hAAA2;
    mem[ 892] = 16'hAB21;
    mem[ 893] = 16'hABA0;
    mem[ 894] = 16'hAC20;
    mem[ 895] = 16'hACA1;
    mem[ 896] = 16'hAD23;
    mem[ 897] = 16'hADA5;
    mem[ 898] = 16'hAE29;
    mem[ 899] = 16'hAEAD;
    mem[ 900] = 16'hAF32;
    mem[ 901] = 16'hAFB7;
    mem[ 902] = 16'hB03E;
    mem[ 903] = 16'hB0C5;
    mem[ 904] = 16'hB14D;
    mem[ 905] = 16'hB1D6;
    mem[ 906] = 16'hB260;
    mem[ 907] = 16'hB2EA;
    mem[ 908] = 16'hB375;
    mem[ 909] = 16'hB401;
    mem[ 910] = 16'hB48D;
    mem[ 911] = 16'hB51A;
    mem[ 912] = 16'hB5A8;
    mem[ 913] = 16'hB637;
    mem[ 914] = 16'hB6C6;
    mem[ 915] = 16'hB756;
    mem[ 916] = 16'hB7E7;
    mem[ 917] = 16'hB879;
    mem[ 918] = 16'hB90B;
    mem[ 919] = 16'hB99E;
    mem[ 920] = 16'hBA31;
    mem[ 921] = 16'hBAC5;
    mem[ 922] = 16'hBB5A;
    mem[ 923] = 16'hBBF0;
    mem[ 924] = 16'hBC86;
    mem[ 925] = 16'hBD1D;
    mem[ 926] = 16'hBDB4;
    mem[ 927] = 16'hBE4C;
    mem[ 928] = 16'hBEE5;
    mem[ 929] = 16'hBF7E;
    mem[ 930] = 16'hC018;
    mem[ 931] = 16'hC0B3;
    mem[ 932] = 16'hC14E;
    mem[ 933] = 16'hC1EA;
    mem[ 934] = 16'hC286;
    mem[ 935] = 16'hC323;
    mem[ 936] = 16'hC3C1;
    mem[ 937] = 16'hC45F;
    mem[ 938] = 16'hC4FE;
    mem[ 939] = 16'hC59D;
    mem[ 940] = 16'hC63D;
    mem[ 941] = 16'hC6DD;
    mem[ 942] = 16'hC77E;
    mem[ 943] = 16'hC820;
    mem[ 944] = 16'hC8C2;
    mem[ 945] = 16'hC965;
    mem[ 946] = 16'hCA08;
    mem[ 947] = 16'hCAAB;
    mem[ 948] = 16'hCB50;
    mem[ 949] = 16'hCBF4;
    mem[ 950] = 16'hCC9A;
    mem[ 951] = 16'hCD3F;
    mem[ 952] = 16'hCDE5;
    mem[ 953] = 16'hCE8C;
    mem[ 954] = 16'hCF33;
    mem[ 955] = 16'hCFDB;
    mem[ 956] = 16'hD083;
    mem[ 957] = 16'hD12B;
    mem[ 958] = 16'hD1D4;
    mem[ 959] = 16'hD27E;
    mem[ 960] = 16'hD327;
    mem[ 961] = 16'hD3D2;
    mem[ 962] = 16'hD47C;
    mem[ 963] = 16'hD528;
    mem[ 964] = 16'hD5D3;
    mem[ 965] = 16'hD67F;
    mem[ 966] = 16'hD72B;
    mem[ 967] = 16'hD7D8;
    mem[ 968] = 16'hD885;
    mem[ 969] = 16'hD933;
    mem[ 970] = 16'hD9E1;
    mem[ 971] = 16'hDA8F;
    mem[ 972] = 16'hDB3E;
    mem[ 973] = 16'hDBED;
    mem[ 974] = 16'hDC9C;
    mem[ 975] = 16'hDD4B;
    mem[ 976] = 16'hDDFB;
    mem[ 977] = 16'hDEAC;
    mem[ 978] = 16'hDF5C;
    mem[ 979] = 16'hE00D;
    mem[ 980] = 16'hE0BF;
    mem[ 981] = 16'hE170;
    mem[ 982] = 16'hE222;
    mem[ 983] = 16'hE2D4;
    mem[ 984] = 16'hE387;
    mem[ 985] = 16'hE439;
    mem[ 986] = 16'hE4EC;
    mem[ 987] = 16'hE59F;
    mem[ 988] = 16'hE653;
    mem[ 989] = 16'hE707;
    mem[ 990] = 16'hE7BB;
    mem[ 991] = 16'hE86F;
    mem[ 992] = 16'hE923;
    mem[ 993] = 16'hE9D8;
    mem[ 994] = 16'hEA8D;
    mem[ 995] = 16'hEB42;
    mem[ 996] = 16'hEBF7;
    mem[ 997] = 16'hECAD;
    mem[ 998] = 16'hED62;
    mem[ 999] = 16'hEE18;
    mem[1000] = 16'hEECE;
    mem[1001] = 16'hEF84;
    mem[1002] = 16'hF03B;
    mem[1003] = 16'hF0F1;
    mem[1004] = 16'hF1A8;
    mem[1005] = 16'hF25E;
    mem[1006] = 16'hF315;
    mem[1007] = 16'hF3CC;
    mem[1008] = 16'hF483;
    mem[1009] = 16'hF53B;
    mem[1010] = 16'hF5F2;
    mem[1011] = 16'hF6AA;
    mem[1012] = 16'hF761;
    mem[1013] = 16'hF819;
    mem[1014] = 16'hF8D0;
    mem[1015] = 16'hF988;
    mem[1016] = 16'hFA40;
    mem[1017] = 16'hFAF8;
    mem[1018] = 16'hFBB0;
    mem[1019] = 16'hFC68;
    mem[1020] = 16'hFD20;
    mem[1021] = 16'hFDD8;
    mem[1022] = 16'hFE90;
    mem[1023] = 16'hFF48;
end
always @(posedge clk) dout <= mem[addr];   // 同步读，1 拍延迟
endmodule
