3321485853ray-hue/Rhythm-of-Notes/fpga/src/twiddle_rom.v

// twiddle_rom.v —— 2048 点 FFT 旋转因子（Q15）

module twiddle_rom (
    input  wire        clk,
    input  wire [9:0] addr,
    output reg  [31:0] dout = 32'd0
);
    reg [31:0] mem [0:1023];
    initial begin
        mem[   0] = 32'h7fff0000;
        mem[   1] = 32'h7fffff9b;
        mem[   2] = 32'h7ffeff37;
        mem[   3] = 32'h7ffefed2;
        mem[   4] = 32'h7ffdfe6e;
        mem[   5] = 32'h7ffbfe09;
        mem[   6] = 32'h7ff9fda5;
        mem[   7] = 32'h7ff7fd40;
        mem[   8] = 32'h7ff5fcdc;
        mem[   9] = 32'h7ff3fc77;
        mem[  10] = 32'h7ff0fc13;
        mem[  11] = 32'h7fecfbae;
        mem[  12] = 32'h7fe9fb4a;
        mem[  13] = 32'h7fe5fae5;
        mem[  14] = 32'h7fe1fa81;
        mem[  15] = 32'h7fdcfa1d;
        mem[  16] = 32'h7fd8f9b8;
        mem[  17] = 32'h7fd2f954;
        mem[  18] = 32'h7fcdf8ef;
        mem[  19] = 32'h7fc7f88b;
        mem[  20] = 32'h7fc1f827;
        mem[  21] = 32'h7fbbf7c2;
        mem[  22] = 32'h7fb4f75e;
        mem[  23] = 32'h7fadf6fa;
        mem[  24] = 32'h7fa6f696;
        mem[  25] = 32'h7f9ff631;
        mem[  26] = 32'h7f97f5cd;
        mem[  27] = 32'h7f8ff569;
        mem[  28] = 32'h7f86f505;
        mem[  29] = 32'h7f7df4a1;
        mem[  30] = 32'h7f74f43c;
        mem[  31] = 32'h7f6bf3d8;
        mem[  32] = 32'h7f61f374;
        mem[  33] = 32'h7f57f310;
        mem[  34] = 32'h7f4df2ac;
        mem[  35] = 32'h7f42f248;
        mem[  36] = 32'h7f37f1e4;
        mem[  37] = 32'h7f2cf180;
        mem[  38] = 32'h7f21f11d;
        mem[  39] = 32'h7f15f0b9;
        mem[  40] = 32'h7f09f055;
        mem[  41] = 32'h7efceff1;
        mem[  42] = 32'h7eefef8e;
        mem[  43] = 32'h7ee2ef2a;
        mem[  44] = 32'h7ed5eec6;
        mem[  45] = 32'h7ec7ee63;
        mem[  46] = 32'h7eb9edff;
        mem[  47] = 32'h7eabed9c;
        mem[  48] = 32'h7e9ced38;
        mem[  49] = 32'h7e8decd5;
        mem[  50] = 32'h7e7eec71;
        mem[  51] = 32'h7e6fec0e;
        mem[  52] = 32'h7e5febab;
        mem[  53] = 32'h7e4feb47;
        mem[  54] = 32'h7e3eeae4;
        mem[  55] = 32'h7e2eea81;
        mem[  56] = 32'h7e1dea1e;
        mem[  57] = 32'h7e0be9bb;
        mem[  58] = 32'h7dfae958;
        mem[  59] = 32'h7de8e8f5;
        mem[  60] = 32'h7dd5e892;
        mem[  61] = 32'h7dc3e830;
        mem[  62] = 32'h7db0e7cd;
        mem[  63] = 32'h7d9de76a;
        mem[  64] = 32'h7d89e707;
        mem[  65] = 32'h7d76e6a5;
        mem[  66] = 32'h7d62e642;
        mem[  67] = 32'h7d4de5e0;
        mem[  68] = 32'h7d39e57e;
        mem[  69] = 32'h7d24e51b;
        mem[  70] = 32'h7d0ee4b9;
        mem[  71] = 32'h7cf9e457;
        mem[  72] = 32'h7ce3e3f5;
        mem[  73] = 32'h7ccde393;
        mem[  74] = 32'h7cb6e331;
        mem[  75] = 32'h7c9fe2cf;
        mem[  76] = 32'h7c88e26d;
        mem[  77] = 32'h7c71e20b;
        mem[  78] = 32'h7c59e1a9;
        mem[  79] = 32'h7c41e148;
        mem[  80] = 32'h7c29e0e6;
        mem[  81] = 32'h7c10e085;
        mem[  82] = 32'h7bf8e023;
        mem[  83] = 32'h7bdedfc2;
        mem[  84] = 32'h7bc5df61;
        mem[  85] = 32'h7babdf00;
        mem[  86] = 32'h7b91de9f;
        mem[  87] = 32'h7b77de3e;
        mem[  88] = 32'h7b5cdddd;
        mem[  89] = 32'h7b41dd7c;
        mem[  90] = 32'h7b26dd1b;
        mem[  91] = 32'h7b0adcba;
        mem[  92] = 32'h7aeedc5a;
        mem[  93] = 32'h7ad2dbf9;
        mem[  94] = 32'h7ab6db99;
        mem[  95] = 32'h7a99db38;
        mem[  96] = 32'h7a7cdad8;
        mem[  97] = 32'h7a5fda78;
        mem[  98] = 32'h7a41da18;
        mem[  99] = 32'h7a23d9b8;
        mem[ 100] = 32'h7a05d958;
        mem[ 101] = 32'h79e6d8f8;
        mem[ 102] = 32'h79c8d899;
        mem[ 103] = 32'h79a9d839;
        mem[ 104] = 32'h7989d7da;
        mem[ 105] = 32'h796ad77a;
        mem[ 106] = 32'h794ad71b;
        mem[ 107] = 32'h7929d6bc;
        mem[ 108] = 32'h7909d65d;
        mem[ 109] = 32'h78e8d5fe;
        mem[ 110] = 32'h78c7d59f;
        mem[ 111] = 32'h78a5d540;
        mem[ 112] = 32'h7884d4e1;
        mem[ 113] = 32'h7862d483;
        mem[ 114] = 32'h783fd424;
        mem[ 115] = 32'h781dd3c6;
        mem[ 116] = 32'h77fad367;
        mem[ 117] = 32'h77d7d309;
        mem[ 118] = 32'h77b3d2ab;
        mem[ 119] = 32'h778fd24d;
        mem[ 120] = 32'h776bd1ef;
        mem[ 121] = 32'h7747d192;
        mem[ 122] = 32'h7722d134;
        mem[ 123] = 32'h76fed0d6;
        mem[ 124] = 32'h76d8d079;
        mem[ 125] = 32'h76b3d01c;
        mem[ 126] = 32'h768dcfbf;
        mem[ 127] = 32'h7667cf62;
        mem[ 128] = 32'h7641cf05;
        mem[ 129] = 32'h761acea8;
        mem[ 130] = 32'h75f3ce4b;
        mem[ 131] = 32'h75cccdef;
        mem[ 132] = 32'h75a5cd92;
        mem[ 133] = 32'h757dcd36;
        mem[ 134] = 32'h7555ccda;
        mem[ 135] = 32'h752dcc7d;
        mem[ 136] = 32'h7504cc21;
        mem[ 137] = 32'h74dbcbc6;
        mem[ 138] = 32'h74b2cb6a;
        mem[ 139] = 32'h7488cb0e;
        mem[ 140] = 32'h745fcab3;
        mem[ 141] = 32'h7435ca58;
        mem[ 142] = 32'h740ac9fc;
        mem[ 143] = 32'h73e0c9a1;
        mem[ 144] = 32'h73b5c946;
        mem[ 145] = 32'h738ac8eb;
        mem[ 146] = 32'h735ec891;
        mem[ 147] = 32'h7333c836;
        mem[ 148] = 32'h7307c7dc;
        mem[ 149] = 32'h72dbc782;
        mem[ 150] = 32'h72aec727;
        mem[ 151] = 32'h7281c6cd;
        mem[ 152] = 32'h7254c674;
        mem[ 153] = 32'h7227c61a;
        mem[ 154] = 32'h71f9c5c0;
        mem[ 155] = 32'h71cbc567;
        mem[ 156] = 32'h719dc50e;
        mem[ 157] = 32'h716fc4b4;
        mem[ 158] = 32'h7140c45b;
        mem[ 159] = 32'h7111c402;
        mem[ 160] = 32'h70e2c3aa;
        mem[ 161] = 32'h70b2c351;
        mem[ 162] = 32'h7083c2f9;
        mem[ 163] = 32'h7053c2a0;
        mem[ 164] = 32'h7022c248;
        mem[ 165] = 32'h6ff2c1f0;
        mem[ 166] = 32'h6fc1c198;
        mem[ 167] = 32'h6f90c141;
        mem[ 168] = 32'h6f5ec0e9;
        mem[ 169] = 32'h6f2cc092;
        mem[ 170] = 32'h6efbc03b;
        mem[ 171] = 32'h6ec8bfe3;
        mem[ 172] = 32'h6e96bf8d;
        mem[ 173] = 32'h6e63bf36;
        mem[ 174] = 32'h6e30bedf;
        mem[ 175] = 32'h6dfdbe89;
        mem[ 176] = 32'h6dc9be32;
        mem[ 177] = 32'h6d95bddc;
        mem[ 178] = 32'h6d61bd86;
        mem[ 179] = 32'h6d2dbd30;
        mem[ 180] = 32'h6cf8bcdb;
        mem[ 181] = 32'h6cc3bc85;
        mem[ 182] = 32'h6c8ebc30;
        mem[ 183] = 32'h6c59bbdb;
        mem[ 184] = 32'h6c23bb86;
        mem[ 185] = 32'h6bedbb31;
        mem[ 186] = 32'h6bb7badc;
        mem[ 187] = 32'h6b81ba88;
        mem[ 188] = 32'h6b4aba33;
        mem[ 189] = 32'h6b13b9df;
        mem[ 190] = 32'h6adcb98b;
        mem[ 191] = 32'h6aa4b937;
        mem[ 192] = 32'h6a6db8e4;
        mem[ 193] = 32'h6a35b890;
        mem[ 194] = 32'h69fdb83d;
        mem[ 195] = 32'h69c4b7ea;
        mem[ 196] = 32'h698bb797;
        mem[ 197] = 32'h6952b744;
        mem[ 198] = 32'h6919b6f1;
        mem[ 199] = 32'h68e0b69f;
        mem[ 200] = 32'h68a6b64c;
        mem[ 201] = 32'h686cb5fa;
        mem[ 202] = 32'h6832b5a8;
        mem[ 203] = 32'h67f7b557;
        mem[ 204] = 32'h67bcb505;
        mem[ 205] = 32'h6781b4b4;
        mem[ 206] = 32'h6746b463;
        mem[ 207] = 32'h670ab412;
        mem[ 208] = 32'h66cfb3c1;
        mem[ 209] = 32'h6693b370;
        mem[ 210] = 32'h6656b320;
        mem[ 211] = 32'h661ab2cf;
        mem[ 212] = 32'h65ddb27f;
        mem[ 213] = 32'h65a0b22f;
        mem[ 214] = 32'h6563b1e0;
        mem[ 215] = 32'h6525b190;
        mem[ 216] = 32'h64e8b141;
        mem[ 217] = 32'h64aab0f2;
        mem[ 218] = 32'h646cb0a3;
        mem[ 219] = 32'h642db054;
        mem[ 220] = 32'h63eeb005;
        mem[ 221] = 32'h63afafb7;
        mem[ 222] = 32'h6370af69;
        mem[ 223] = 32'h6331af1b;
        mem[ 224] = 32'h62f1aecd;
        mem[ 225] = 32'h62b1ae7f;
        mem[ 226] = 32'h6271ae32;
        mem[ 227] = 32'h6231ade5;
        mem[ 228] = 32'h61f0ad98;
        mem[ 229] = 32'h61afad4b;
        mem[ 230] = 32'h616eacfe;
        mem[ 231] = 32'h612dacb2;
        mem[ 232] = 32'h60ebac65;
        mem[ 233] = 32'h60aaac19;
        mem[ 234] = 32'h6068abce;
        mem[ 235] = 32'h6025ab82;
        mem[ 236] = 32'h5fe3ab37;
        mem[ 237] = 32'h5fa0aaeb;
        mem[ 238] = 32'h5f5daaa0;
        mem[ 239] = 32'h5f1aaa56;
        mem[ 240] = 32'h5ed7aa0b;
        mem[ 241] = 32'h5e93a9c1;
        mem[ 242] = 32'h5e4fa976;
        mem[ 243] = 32'h5e0ba92d;
        mem[ 244] = 32'h5dc7a8e3;
        mem[ 245] = 32'h5d82a899;
        mem[ 246] = 32'h5d3ea850;
        mem[ 247] = 32'h5cf9a807;
        mem[ 248] = 32'h5cb3a7be;
        mem[ 249] = 32'h5c6ea775;
        mem[ 250] = 32'h5c28a72d;
        mem[ 251] = 32'h5be2a6e4;
        mem[ 252] = 32'h5b9ca69c;
        mem[ 253] = 32'h5b56a654;
        mem[ 254] = 32'h5b0fa60d;
        mem[ 255] = 32'h5ac9a5c5;
        mem[ 256] = 32'h5a82a57e;
        mem[ 257] = 32'h5a3ba537;
        mem[ 258] = 32'h59f3a4f1;
        mem[ 259] = 32'h59aca4aa;
        mem[ 260] = 32'h5964a464;
        mem[ 261] = 32'h591ca41e;
        mem[ 262] = 32'h58d3a3d8;
        mem[ 263] = 32'h588ba392;
        mem[ 264] = 32'h5842a34d;
        mem[ 265] = 32'h57f9a307;
        mem[ 266] = 32'h57b0a2c2;
        mem[ 267] = 32'h5767a27e;
        mem[ 268] = 32'h571da239;
        mem[ 269] = 32'h56d3a1f5;
        mem[ 270] = 32'h568aa1b1;
        mem[ 271] = 32'h563fa16d;
        mem[ 272] = 32'h55f5a129;
        mem[ 273] = 32'h55aaa0e6;
        mem[ 274] = 32'h5560a0a3;
        mem[ 275] = 32'h5515a060;
        mem[ 276] = 32'h54c9a01d;
        mem[ 277] = 32'h547e9fdb;
        mem[ 278] = 32'h54329f98;
        mem[ 279] = 32'h53e79f56;
        mem[ 280] = 32'h539b9f15;
        mem[ 281] = 32'h534e9ed3;
        mem[ 282] = 32'h53029e92;
        mem[ 283] = 32'h52b59e51;
        mem[ 284] = 32'h52689e10;
        mem[ 285] = 32'h521b9dcf;
        mem[ 286] = 32'h51ce9d8f;
        mem[ 287] = 32'h51819d4f;
        mem[ 288] = 32'h51339d0f;
        mem[ 289] = 32'h50e59ccf;
        mem[ 290] = 32'h50979c90;
        mem[ 291] = 32'h50499c51;
        mem[ 292] = 32'h4ffb9c12;
        mem[ 293] = 32'h4fac9bd3;
        mem[ 294] = 32'h4f5d9b94;
        mem[ 295] = 32'h4f0e9b56;
        mem[ 296] = 32'h4ebf9b18;
        mem[ 297] = 32'h4e709adb;
        mem[ 298] = 32'h4e209a9d;
        mem[ 299] = 32'h4dd19a60;
        mem[ 300] = 32'h4d819a23;
        mem[ 301] = 32'h4d3199e6;
        mem[ 302] = 32'h4ce099aa;
        mem[ 303] = 32'h4c90996d;
        mem[ 304] = 32'h4c3f9931;
        mem[ 305] = 32'h4bee98f6;
        mem[ 306] = 32'h4b9d98ba;
        mem[ 307] = 32'h4b4c987f;
        mem[ 308] = 32'h4afb9844;
        mem[ 309] = 32'h4aa99809;
        mem[ 310] = 32'h4a5897ce;
        mem[ 311] = 32'h4a069794;
        mem[ 312] = 32'h49b4975a;
        mem[ 313] = 32'h49619720;
        mem[ 314] = 32'h490f96e7;
        mem[ 315] = 32'h48bc96ae;
        mem[ 316] = 32'h48699675;
        mem[ 317] = 32'h4816963c;
        mem[ 318] = 32'h47c39603;
        mem[ 319] = 32'h477095cb;
        mem[ 320] = 32'h471c9593;
        mem[ 321] = 32'h46c9955c;
        mem[ 322] = 32'h46759524;
        mem[ 323] = 32'h462194ed;
        mem[ 324] = 32'h45cd94b6;
        mem[ 325] = 32'h4578947f;
        mem[ 326] = 32'h45249449;
        mem[ 327] = 32'h44cf9413;
        mem[ 328] = 32'h447a93dd;
        mem[ 329] = 32'h442593a7;
        mem[ 330] = 32'h43d09372;
        mem[ 331] = 32'h437b933d;
        mem[ 332] = 32'h43259308;
        mem[ 333] = 32'h42d092d3;
        mem[ 334] = 32'h427a929f;
        mem[ 335] = 32'h4224926b;
        mem[ 336] = 32'h41ce9237;
        mem[ 337] = 32'h41779203;
        mem[ 338] = 32'h412191d0;
        mem[ 339] = 32'h40ca919d;
        mem[ 340] = 32'h4073916a;
        mem[ 341] = 32'h401d9138;
        mem[ 342] = 32'h3fc59105;
        mem[ 343] = 32'h3f6e90d4;
        mem[ 344] = 32'h3f1790a2;
        mem[ 345] = 32'h3ebf9070;
        mem[ 346] = 32'h3e68903f;
        mem[ 347] = 32'h3e10900e;
        mem[ 348] = 32'h3db88fde;
        mem[ 349] = 32'h3d608fad;
        mem[ 350] = 32'h3d078f7d;
        mem[ 351] = 32'h3caf8f4e;
        mem[ 352] = 32'h3c568f1e;
        mem[ 353] = 32'h3bfe8eef;
        mem[ 354] = 32'h3ba58ec0;
        mem[ 355] = 32'h3b4c8e91;
        mem[ 356] = 32'h3af28e63;
        mem[ 357] = 32'h3a998e35;
        mem[ 358] = 32'h3a408e07;
        mem[ 359] = 32'h39e68dd9;
        mem[ 360] = 32'h398c8dac;
        mem[ 361] = 32'h39338d7f;
        mem[ 362] = 32'h38d98d52;
        mem[ 363] = 32'h387e8d25;
        mem[ 364] = 32'h38248cf9;
        mem[ 365] = 32'h37ca8ccd;
        mem[ 366] = 32'h376f8ca2;
        mem[ 367] = 32'h37158c76;
        mem[ 368] = 32'h36ba8c4b;
        mem[ 369] = 32'h365f8c20;
        mem[ 370] = 32'h36048bf6;
        mem[ 371] = 32'h35a88bcb;
        mem[ 372] = 32'h354d8ba1;
        mem[ 373] = 32'h34f28b78;
        mem[ 374] = 32'h34968b4e;
        mem[ 375] = 32'h343a8b25;
        mem[ 376] = 32'h33df8afc;
        mem[ 377] = 32'h33838ad3;
        mem[ 378] = 32'h33268aab;
        mem[ 379] = 32'h32ca8a83;
        mem[ 380] = 32'h326e8a5b;
        mem[ 381] = 32'h32118a34;
        mem[ 382] = 32'h31b58a0d;
        mem[ 383] = 32'h315889e6;
        mem[ 384] = 32'h30fb89bf;
        mem[ 385] = 32'h309e8999;
        mem[ 386] = 32'h30418973;
        mem[ 387] = 32'h2fe4894d;
        mem[ 388] = 32'h2f878928;
        mem[ 389] = 32'h2f2a8902;
        mem[ 390] = 32'h2ecc88de;
        mem[ 391] = 32'h2e6e88b9;
        mem[ 392] = 32'h2e118895;
        mem[ 393] = 32'h2db38871;
        mem[ 394] = 32'h2d55884d;
        mem[ 395] = 32'h2cf78829;
        mem[ 396] = 32'h2c998806;
        mem[ 397] = 32'h2c3a87e3;
        mem[ 398] = 32'h2bdc87c1;
        mem[ 399] = 32'h2b7d879e;
        mem[ 400] = 32'h2b1f877c;
        mem[ 401] = 32'h2ac0875b;
        mem[ 402] = 32'h2a618739;
        mem[ 403] = 32'h2a028718;
        mem[ 404] = 32'h29a386f7;
        mem[ 405] = 32'h294486d7;
        mem[ 406] = 32'h28e586b6;
        mem[ 407] = 32'h28868696;
        mem[ 408] = 32'h28268677;
        mem[ 409] = 32'h27c78657;
        mem[ 410] = 32'h27678638;
        mem[ 411] = 32'h2708861a;
        mem[ 412] = 32'h26a885fb;
        mem[ 413] = 32'h264885dd;
        mem[ 414] = 32'h25e885bf;
        mem[ 415] = 32'h258885a1;
        mem[ 416] = 32'h25288584;
        mem[ 417] = 32'h24c88567;
        mem[ 418] = 32'h2467854a;
        mem[ 419] = 32'h2407852e;
        mem[ 420] = 32'h23a68512;
        mem[ 421] = 32'h234684f6;
        mem[ 422] = 32'h22e584da;
        mem[ 423] = 32'h228484bf;
        mem[ 424] = 32'h222384a4;
        mem[ 425] = 32'h21c28489;
        mem[ 426] = 32'h2161846f;
        mem[ 427] = 32'h21008455;
        mem[ 428] = 32'h209f843b;
        mem[ 429] = 32'h203e8422;
        mem[ 430] = 32'h1fdd8408;
        mem[ 431] = 32'h1f7b83f0;
        mem[ 432] = 32'h1f1a83d7;
        mem[ 433] = 32'h1eb883bf;
        mem[ 434] = 32'h1e5783a7;
        mem[ 435] = 32'h1df5838f;
        mem[ 436] = 32'h1d938378;
        mem[ 437] = 32'h1d318361;
        mem[ 438] = 32'h1ccf834a;
        mem[ 439] = 32'h1c6d8333;
        mem[ 440] = 32'h1c0b831d;
        mem[ 441] = 32'h1ba98307;
        mem[ 442] = 32'h1b4782f2;
        mem[ 443] = 32'h1ae582dc;
        mem[ 444] = 32'h1a8282c7;
        mem[ 445] = 32'h1a2082b3;
        mem[ 446] = 32'h19be829e;
        mem[ 447] = 32'h195b828a;
        mem[ 448] = 32'h18f98277;
        mem[ 449] = 32'h18968263;
        mem[ 450] = 32'h18338250;
        mem[ 451] = 32'h17d0823d;
        mem[ 452] = 32'h176e822b;
        mem[ 453] = 32'h170b8218;
        mem[ 454] = 32'h16a88206;
        mem[ 455] = 32'h164581f5;
        mem[ 456] = 32'h15e281e3;
        mem[ 457] = 32'h157f81d2;
        mem[ 458] = 32'h151c81c2;
        mem[ 459] = 32'h14b981b1;
        mem[ 460] = 32'h145581a1;
        mem[ 461] = 32'h13f28191;
        mem[ 462] = 32'h138f8182;
        mem[ 463] = 32'h132b8173;
        mem[ 464] = 32'h12c88164;
        mem[ 465] = 32'h12648155;
        mem[ 466] = 32'h12018147;
        mem[ 467] = 32'h119d8139;
        mem[ 468] = 32'h113a812b;
        mem[ 469] = 32'h10d6811e;
        mem[ 470] = 32'h10728111;
        mem[ 471] = 32'h100f8104;
        mem[ 472] = 32'h0fab80f7;
        mem[ 473] = 32'h0f4780eb;
        mem[ 474] = 32'h0ee380df;
        mem[ 475] = 32'h0e8080d4;
        mem[ 476] = 32'h0e1c80c9;
        mem[ 477] = 32'h0db880be;
        mem[ 478] = 32'h0d5480b3;
        mem[ 479] = 32'h0cf080a9;
        mem[ 480] = 32'h0c8c809f;
        mem[ 481] = 32'h0c288095;
        mem[ 482] = 32'h0bc4808c;
        mem[ 483] = 32'h0b5f8083;
        mem[ 484] = 32'h0afb807a;
        mem[ 485] = 32'h0a978071;
        mem[ 486] = 32'h0a338069;
        mem[ 487] = 32'h09cf8061;
        mem[ 488] = 32'h096a805a;
        mem[ 489] = 32'h09068053;
        mem[ 490] = 32'h08a2804c;
        mem[ 491] = 32'h083e8045;
        mem[ 492] = 32'h07d9803f;
        mem[ 493] = 32'h07758039;
        mem[ 494] = 32'h07118033;
        mem[ 495] = 32'h06ac802e;
        mem[ 496] = 32'h06488028;
        mem[ 497] = 32'h05e38024;
        mem[ 498] = 32'h057f801f;
        mem[ 499] = 32'h051b801b;
        mem[ 500] = 32'h04b68017;
        mem[ 501] = 32'h04528014;
        mem[ 502] = 32'h03ed8010;
        mem[ 503] = 32'h0389800d;
        mem[ 504] = 32'h0324800b;
        mem[ 505] = 32'h02c08009;
        mem[ 506] = 32'h025b8007;
        mem[ 507] = 32'h01f78005;
        mem[ 508] = 32'h01928003;
        mem[ 509] = 32'h012e8002;
        mem[ 510] = 32'h00c98002;
        mem[ 511] = 32'h00658001;
        mem[ 512] = 32'h00008001;
        mem[ 513] = 32'hff9b8001;
        mem[ 514] = 32'hff378002;
        mem[ 515] = 32'hfed28002;
        mem[ 516] = 32'hfe6e8003;
        mem[ 517] = 32'hfe098005;
        mem[ 518] = 32'hfda58007;
        mem[ 519] = 32'hfd408009;
        mem[ 520] = 32'hfcdc800b;
        mem[ 521] = 32'hfc77800d;
        mem[ 522] = 32'hfc138010;
        mem[ 523] = 32'hfbae8014;
        mem[ 524] = 32'hfb4a8017;
        mem[ 525] = 32'hfae5801b;
        mem[ 526] = 32'hfa81801f;
        mem[ 527] = 32'hfa1d8024;
        mem[ 528] = 32'hf9b88028;
        mem[ 529] = 32'hf954802e;
        mem[ 530] = 32'hf8ef8033;
        mem[ 531] = 32'hf88b8039;
        mem[ 532] = 32'hf827803f;
        mem[ 533] = 32'hf7c28045;
        mem[ 534] = 32'hf75e804c;
        mem[ 535] = 32'hf6fa8053;
        mem[ 536] = 32'hf696805a;
        mem[ 537] = 32'hf6318061;
        mem[ 538] = 32'hf5cd8069;
        mem[ 539] = 32'hf5698071;
        mem[ 540] = 32'hf505807a;
        mem[ 541] = 32'hf4a18083;
        mem[ 542] = 32'hf43c808c;
        mem[ 543] = 32'hf3d88095;
        mem[ 544] = 32'hf374809f;
        mem[ 545] = 32'hf31080a9;
        mem[ 546] = 32'hf2ac80b3;
        mem[ 547] = 32'hf24880be;
        mem[ 548] = 32'hf1e480c9;
        mem[ 549] = 32'hf18080d4;
        mem[ 550] = 32'hf11d80df;
        mem[ 551] = 32'hf0b980eb;
        mem[ 552] = 32'hf05580f7;
        mem[ 553] = 32'heff18104;
        mem[ 554] = 32'hef8e8111;
        mem[ 555] = 32'hef2a811e;
        mem[ 556] = 32'heec6812b;
        mem[ 557] = 32'hee638139;
        mem[ 558] = 32'hedff8147;
        mem[ 559] = 32'hed9c8155;
        mem[ 560] = 32'hed388164;
        mem[ 561] = 32'hecd58173;
        mem[ 562] = 32'hec718182;
        mem[ 563] = 32'hec0e8191;
        mem[ 564] = 32'hebab81a1;
        mem[ 565] = 32'heb4781b1;
        mem[ 566] = 32'heae481c2;
        mem[ 567] = 32'hea8181d2;
        mem[ 568] = 32'hea1e81e3;
        mem[ 569] = 32'he9bb81f5;
        mem[ 570] = 32'he9588206;
        mem[ 571] = 32'he8f58218;
        mem[ 572] = 32'he892822b;
        mem[ 573] = 32'he830823d;
        mem[ 574] = 32'he7cd8250;
        mem[ 575] = 32'he76a8263;
        mem[ 576] = 32'he7078277;
        mem[ 577] = 32'he6a5828a;
        mem[ 578] = 32'he642829e;
        mem[ 579] = 32'he5e082b3;
        mem[ 580] = 32'he57e82c7;
        mem[ 581] = 32'he51b82dc;
        mem[ 582] = 32'he4b982f2;
        mem[ 583] = 32'he4578307;
        mem[ 584] = 32'he3f5831d;
        mem[ 585] = 32'he3938333;
        mem[ 586] = 32'he331834a;
        mem[ 587] = 32'he2cf8361;
        mem[ 588] = 32'he26d8378;
        mem[ 589] = 32'he20b838f;
        mem[ 590] = 32'he1a983a7;
        mem[ 591] = 32'he14883bf;
        mem[ 592] = 32'he0e683d7;
        mem[ 593] = 32'he08583f0;
        mem[ 594] = 32'he0238408;
        mem[ 595] = 32'hdfc28422;
        mem[ 596] = 32'hdf61843b;
        mem[ 597] = 32'hdf008455;
        mem[ 598] = 32'hde9f846f;
        mem[ 599] = 32'hde3e8489;
        mem[ 600] = 32'hdddd84a4;
        mem[ 601] = 32'hdd7c84bf;
        mem[ 602] = 32'hdd1b84da;
        mem[ 603] = 32'hdcba84f6;
        mem[ 604] = 32'hdc5a8512;
        mem[ 605] = 32'hdbf9852e;
        mem[ 606] = 32'hdb99854a;
        mem[ 607] = 32'hdb388567;
        mem[ 608] = 32'hdad88584;
        mem[ 609] = 32'hda7885a1;
        mem[ 610] = 32'hda1885bf;
        mem[ 611] = 32'hd9b885dd;
        mem[ 612] = 32'hd95885fb;
        mem[ 613] = 32'hd8f8861a;
        mem[ 614] = 32'hd8998638;
        mem[ 615] = 32'hd8398657;
        mem[ 616] = 32'hd7da8677;
        mem[ 617] = 32'hd77a8696;
        mem[ 618] = 32'hd71b86b6;
        mem[ 619] = 32'hd6bc86d7;
        mem[ 620] = 32'hd65d86f7;
        mem[ 621] = 32'hd5fe8718;
        mem[ 622] = 32'hd59f8739;
        mem[ 623] = 32'hd540875b;
        mem[ 624] = 32'hd4e1877c;
        mem[ 625] = 32'hd483879e;
        mem[ 626] = 32'hd42487c1;
        mem[ 627] = 32'hd3c687e3;
        mem[ 628] = 32'hd3678806;
        mem[ 629] = 32'hd3098829;
        mem[ 630] = 32'hd2ab884d;
        mem[ 631] = 32'hd24d8871;
        mem[ 632] = 32'hd1ef8895;
        mem[ 633] = 32'hd19288b9;
        mem[ 634] = 32'hd13488de;
        mem[ 635] = 32'hd0d68902;
        mem[ 636] = 32'hd0798928;
        mem[ 637] = 32'hd01c894d;
        mem[ 638] = 32'hcfbf8973;
        mem[ 639] = 32'hcf628999;
        mem[ 640] = 32'hcf0589bf;
        mem[ 641] = 32'hcea889e6;
        mem[ 642] = 32'hce4b8a0d;
        mem[ 643] = 32'hcdef8a34;
        mem[ 644] = 32'hcd928a5b;
        mem[ 645] = 32'hcd368a83;
        mem[ 646] = 32'hccda8aab;
        mem[ 647] = 32'hcc7d8ad3;
        mem[ 648] = 32'hcc218afc;
        mem[ 649] = 32'hcbc68b25;
        mem[ 650] = 32'hcb6a8b4e;
        mem[ 651] = 32'hcb0e8b78;
        mem[ 652] = 32'hcab38ba1;
        mem[ 653] = 32'hca588bcb;
        mem[ 654] = 32'hc9fc8bf6;
        mem[ 655] = 32'hc9a18c20;
        mem[ 656] = 32'hc9468c4b;
        mem[ 657] = 32'hc8eb8c76;
        mem[ 658] = 32'hc8918ca2;
        mem[ 659] = 32'hc8368ccd;
        mem[ 660] = 32'hc7dc8cf9;
        mem[ 661] = 32'hc7828d25;
        mem[ 662] = 32'hc7278d52;
        mem[ 663] = 32'hc6cd8d7f;
        mem[ 664] = 32'hc6748dac;
        mem[ 665] = 32'hc61a8dd9;
        mem[ 666] = 32'hc5c08e07;
        mem[ 667] = 32'hc5678e35;
        mem[ 668] = 32'hc50e8e63;
        mem[ 669] = 32'hc4b48e91;
        mem[ 670] = 32'hc45b8ec0;
        mem[ 671] = 32'hc4028eef;
        mem[ 672] = 32'hc3aa8f1e;
        mem[ 673] = 32'hc3518f4e;
        mem[ 674] = 32'hc2f98f7d;
        mem[ 675] = 32'hc2a08fad;
        mem[ 676] = 32'hc2488fde;
        mem[ 677] = 32'hc1f0900e;
        mem[ 678] = 32'hc198903f;
        mem[ 679] = 32'hc1419070;
        mem[ 680] = 32'hc0e990a2;
        mem[ 681] = 32'hc09290d4;
        mem[ 682] = 32'hc03b9105;
        mem[ 683] = 32'hbfe39138;
        mem[ 684] = 32'hbf8d916a;
        mem[ 685] = 32'hbf36919d;
        mem[ 686] = 32'hbedf91d0;
        mem[ 687] = 32'hbe899203;
        mem[ 688] = 32'hbe329237;
        mem[ 689] = 32'hbddc926b;
        mem[ 690] = 32'hbd86929f;
        mem[ 691] = 32'hbd3092d3;
        mem[ 692] = 32'hbcdb9308;
        mem[ 693] = 32'hbc85933d;
        mem[ 694] = 32'hbc309372;
        mem[ 695] = 32'hbbdb93a7;
        mem[ 696] = 32'hbb8693dd;
        mem[ 697] = 32'hbb319413;
        mem[ 698] = 32'hbadc9449;
        mem[ 699] = 32'hba88947f;
        mem[ 700] = 32'hba3394b6;
        mem[ 701] = 32'hb9df94ed;
        mem[ 702] = 32'hb98b9524;
        mem[ 703] = 32'hb937955c;
        mem[ 704] = 32'hb8e49593;
        mem[ 705] = 32'hb89095cb;
        mem[ 706] = 32'hb83d9603;
        mem[ 707] = 32'hb7ea963c;
        mem[ 708] = 32'hb7979675;
        mem[ 709] = 32'hb74496ae;
        mem[ 710] = 32'hb6f196e7;
        mem[ 711] = 32'hb69f9720;
        mem[ 712] = 32'hb64c975a;
        mem[ 713] = 32'hb5fa9794;
        mem[ 714] = 32'hb5a897ce;
        mem[ 715] = 32'hb5579809;
        mem[ 716] = 32'hb5059844;
        mem[ 717] = 32'hb4b4987f;
        mem[ 718] = 32'hb46398ba;
        mem[ 719] = 32'hb41298f6;
        mem[ 720] = 32'hb3c19931;
        mem[ 721] = 32'hb370996d;
        mem[ 722] = 32'hb32099aa;
        mem[ 723] = 32'hb2cf99e6;
        mem[ 724] = 32'hb27f9a23;
        mem[ 725] = 32'hb22f9a60;
        mem[ 726] = 32'hb1e09a9d;
        mem[ 727] = 32'hb1909adb;
        mem[ 728] = 32'hb1419b18;
        mem[ 729] = 32'hb0f29b56;
        mem[ 730] = 32'hb0a39b94;
        mem[ 731] = 32'hb0549bd3;
        mem[ 732] = 32'hb0059c12;
        mem[ 733] = 32'hafb79c51;
        mem[ 734] = 32'haf699c90;
        mem[ 735] = 32'haf1b9ccf;
        mem[ 736] = 32'haecd9d0f;
        mem[ 737] = 32'hae7f9d4f;
        mem[ 738] = 32'hae329d8f;
        mem[ 739] = 32'hade59dcf;
        mem[ 740] = 32'had989e10;
        mem[ 741] = 32'had4b9e51;
        mem[ 742] = 32'hacfe9e92;
        mem[ 743] = 32'hacb29ed3;
        mem[ 744] = 32'hac659f15;
        mem[ 745] = 32'hac199f56;
        mem[ 746] = 32'habce9f98;
        mem[ 747] = 32'hab829fdb;
        mem[ 748] = 32'hab37a01d;
        mem[ 749] = 32'haaeba060;
        mem[ 750] = 32'haaa0a0a3;
        mem[ 751] = 32'haa56a0e6;
        mem[ 752] = 32'haa0ba129;
        mem[ 753] = 32'ha9c1a16d;
        mem[ 754] = 32'ha976a1b1;
        mem[ 755] = 32'ha92da1f5;
        mem[ 756] = 32'ha8e3a239;
        mem[ 757] = 32'ha899a27e;
        mem[ 758] = 32'ha850a2c2;
        mem[ 759] = 32'ha807a307;
        mem[ 760] = 32'ha7bea34d;
        mem[ 761] = 32'ha775a392;
        mem[ 762] = 32'ha72da3d8;
        mem[ 763] = 32'ha6e4a41e;
        mem[ 764] = 32'ha69ca464;
        mem[ 765] = 32'ha654a4aa;
        mem[ 766] = 32'ha60da4f1;
        mem[ 767] = 32'ha5c5a537;
        mem[ 768] = 32'ha57ea57e;
        mem[ 769] = 32'ha537a5c5;
        mem[ 770] = 32'ha4f1a60d;
        mem[ 771] = 32'ha4aaa654;
        mem[ 772] = 32'ha464a69c;
        mem[ 773] = 32'ha41ea6e4;
        mem[ 774] = 32'ha3d8a72d;
        mem[ 775] = 32'ha392a775;
        mem[ 776] = 32'ha34da7be;
        mem[ 777] = 32'ha307a807;
        mem[ 778] = 32'ha2c2a850;
        mem[ 779] = 32'ha27ea899;
        mem[ 780] = 32'ha239a8e3;
        mem[ 781] = 32'ha1f5a92d;
        mem[ 782] = 32'ha1b1a976;
        mem[ 783] = 32'ha16da9c1;
        mem[ 784] = 32'ha129aa0b;
        mem[ 785] = 32'ha0e6aa56;
        mem[ 786] = 32'ha0a3aaa0;
        mem[ 787] = 32'ha060aaeb;
        mem[ 788] = 32'ha01dab37;
        mem[ 789] = 32'h9fdbab82;
        mem[ 790] = 32'h9f98abce;
        mem[ 791] = 32'h9f56ac19;
        mem[ 792] = 32'h9f15ac65;
        mem[ 793] = 32'h9ed3acb2;
        mem[ 794] = 32'h9e92acfe;
        mem[ 795] = 32'h9e51ad4b;
        mem[ 796] = 32'h9e10ad98;
        mem[ 797] = 32'h9dcfade5;
        mem[ 798] = 32'h9d8fae32;
        mem[ 799] = 32'h9d4fae7f;
        mem[ 800] = 32'h9d0faecd;
        mem[ 801] = 32'h9ccfaf1b;
        mem[ 802] = 32'h9c90af69;
        mem[ 803] = 32'h9c51afb7;
        mem[ 804] = 32'h9c12b005;
        mem[ 805] = 32'h9bd3b054;
        mem[ 806] = 32'h9b94b0a3;
        mem[ 807] = 32'h9b56b0f2;
        mem[ 808] = 32'h9b18b141;
        mem[ 809] = 32'h9adbb190;
        mem[ 810] = 32'h9a9db1e0;
        mem[ 811] = 32'h9a60b22f;
        mem[ 812] = 32'h9a23b27f;
        mem[ 813] = 32'h99e6b2cf;
        mem[ 814] = 32'h99aab320;
        mem[ 815] = 32'h996db370;
        mem[ 816] = 32'h9931b3c1;
        mem[ 817] = 32'h98f6b412;
        mem[ 818] = 32'h98bab463;
        mem[ 819] = 32'h987fb4b4;
        mem[ 820] = 32'h9844b505;
        mem[ 821] = 32'h9809b557;
        mem[ 822] = 32'h97ceb5a8;
        mem[ 823] = 32'h9794b5fa;
        mem[ 824] = 32'h975ab64c;
        mem[ 825] = 32'h9720b69f;
        mem[ 826] = 32'h96e7b6f1;
        mem[ 827] = 32'h96aeb744;
        mem[ 828] = 32'h9675b797;
        mem[ 829] = 32'h963cb7ea;
        mem[ 830] = 32'h9603b83d;
        mem[ 831] = 32'h95cbb890;
        mem[ 832] = 32'h9593b8e4;
        mem[ 833] = 32'h955cb937;
        mem[ 834] = 32'h9524b98b;
        mem[ 835] = 32'h94edb9df;
        mem[ 836] = 32'h94b6ba33;
        mem[ 837] = 32'h947fba88;
        mem[ 838] = 32'h9449badc;
        mem[ 839] = 32'h9413bb31;
        mem[ 840] = 32'h93ddbb86;
        mem[ 841] = 32'h93a7bbdb;
        mem[ 842] = 32'h9372bc30;
        mem[ 843] = 32'h933dbc85;
        mem[ 844] = 32'h9308bcdb;
        mem[ 845] = 32'h92d3bd30;
        mem[ 846] = 32'h929fbd86;
        mem[ 847] = 32'h926bbddc;
        mem[ 848] = 32'h9237be32;
        mem[ 849] = 32'h9203be89;
        mem[ 850] = 32'h91d0bedf;
        mem[ 851] = 32'h919dbf36;
        mem[ 852] = 32'h916abf8d;
        mem[ 853] = 32'h9138bfe3;
        mem[ 854] = 32'h9105c03b;
        mem[ 855] = 32'h90d4c092;
        mem[ 856] = 32'h90a2c0e9;
        mem[ 857] = 32'h9070c141;
        mem[ 858] = 32'h903fc198;
        mem[ 859] = 32'h900ec1f0;
        mem[ 860] = 32'h8fdec248;
        mem[ 861] = 32'h8fadc2a0;
        mem[ 862] = 32'h8f7dc2f9;
        mem[ 863] = 32'h8f4ec351;
        mem[ 864] = 32'h8f1ec3aa;
        mem[ 865] = 32'h8eefc402;
        mem[ 866] = 32'h8ec0c45b;
        mem[ 867] = 32'h8e91c4b4;
        mem[ 868] = 32'h8e63c50e;
        mem[ 869] = 32'h8e35c567;
        mem[ 870] = 32'h8e07c5c0;
        mem[ 871] = 32'h8dd9c61a;
        mem[ 872] = 32'h8dacc674;
        mem[ 873] = 32'h8d7fc6cd;
        mem[ 874] = 32'h8d52c727;
        mem[ 875] = 32'h8d25c782;
        mem[ 876] = 32'h8cf9c7dc;
        mem[ 877] = 32'h8ccdc836;
        mem[ 878] = 32'h8ca2c891;
        mem[ 879] = 32'h8c76c8eb;
        mem[ 880] = 32'h8c4bc946;
        mem[ 881] = 32'h8c20c9a1;
        mem[ 882] = 32'h8bf6c9fc;
        mem[ 883] = 32'h8bcbca58;
        mem[ 884] = 32'h8ba1cab3;
        mem[ 885] = 32'h8b78cb0e;
        mem[ 886] = 32'h8b4ecb6a;
        mem[ 887] = 32'h8b25cbc6;
        mem[ 888] = 32'h8afccc21;
        mem[ 889] = 32'h8ad3cc7d;
        mem[ 890] = 32'h8aabccda;
        mem[ 891] = 32'h8a83cd36;
        mem[ 892] = 32'h8a5bcd92;
        mem[ 893] = 32'h8a34cdef;
        mem[ 894] = 32'h8a0dce4b;
        mem[ 895] = 32'h89e6cea8;
        mem[ 896] = 32'h89bfcf05;
        mem[ 897] = 32'h8999cf62;
        mem[ 898] = 32'h8973cfbf;
        mem[ 899] = 32'h894dd01c;
        mem[ 900] = 32'h8928d079;
        mem[ 901] = 32'h8902d0d6;
        mem[ 902] = 32'h88ded134;
        mem[ 903] = 32'h88b9d192;
        mem[ 904] = 32'h8895d1ef;
        mem[ 905] = 32'h8871d24d;
        mem[ 906] = 32'h884dd2ab;
        mem[ 907] = 32'h8829d309;
        mem[ 908] = 32'h8806d367;
        mem[ 909] = 32'h87e3d3c6;
        mem[ 910] = 32'h87c1d424;
        mem[ 911] = 32'h879ed483;
        mem[ 912] = 32'h877cd4e1;
        mem[ 913] = 32'h875bd540;
        mem[ 914] = 32'h8739d59f;
        mem[ 915] = 32'h8718d5fe;
        mem[ 916] = 32'h86f7d65d;
        mem[ 917] = 32'h86d7d6bc;
        mem[ 918] = 32'h86b6d71b;
        mem[ 919] = 32'h8696d77a;
        mem[ 920] = 32'h8677d7da;
        mem[ 921] = 32'h8657d839;
        mem[ 922] = 32'h8638d899;
        mem[ 923] = 32'h861ad8f8;
        mem[ 924] = 32'h85fbd958;
        mem[ 925] = 32'h85ddd9b8;
        mem[ 926] = 32'h85bfda18;
        mem[ 927] = 32'h85a1da78;
        mem[ 928] = 32'h8584dad8;
        mem[ 929] = 32'h8567db38;
        mem[ 930] = 32'h854adb99;
        mem[ 931] = 32'h852edbf9;
        mem[ 932] = 32'h8512dc5a;
        mem[ 933] = 32'h84f6dcba;
        mem[ 934] = 32'h84dadd1b;
        mem[ 935] = 32'h84bfdd7c;
        mem[ 936] = 32'h84a4dddd;
        mem[ 937] = 32'h8489de3e;
        mem[ 938] = 32'h846fde9f;
        mem[ 939] = 32'h8455df00;
        mem[ 940] = 32'h843bdf61;
        mem[ 941] = 32'h8422dfc2;
        mem[ 942] = 32'h8408e023;
        mem[ 943] = 32'h83f0e085;
        mem[ 944] = 32'h83d7e0e6;
        mem[ 945] = 32'h83bfe148;
        mem[ 946] = 32'h83a7e1a9;
        mem[ 947] = 32'h838fe20b;
        mem[ 948] = 32'h8378e26d;
        mem[ 949] = 32'h8361e2cf;
        mem[ 950] = 32'h834ae331;
        mem[ 951] = 32'h8333e393;
        mem[ 952] = 32'h831de3f5;
        mem[ 953] = 32'h8307e457;
        mem[ 954] = 32'h82f2e4b9;
        mem[ 955] = 32'h82dce51b;
        mem[ 956] = 32'h82c7e57e;
        mem[ 957] = 32'h82b3e5e0;
        mem[ 958] = 32'h829ee642;
        mem[ 959] = 32'h828ae6a5;
        mem[ 960] = 32'h8277e707;
        mem[ 961] = 32'h8263e76a;
        mem[ 962] = 32'h8250e7cd;
        mem[ 963] = 32'h823de830;
        mem[ 964] = 32'h822be892;
        mem[ 965] = 32'h8218e8f5;
        mem[ 966] = 32'h8206e958;
        mem[ 967] = 32'h81f5e9bb;
        mem[ 968] = 32'h81e3ea1e;
        mem[ 969] = 32'h81d2ea81;
        mem[ 970] = 32'h81c2eae4;
        mem[ 971] = 32'h81b1eb47;
        mem[ 972] = 32'h81a1ebab;
        mem[ 973] = 32'h8191ec0e;
        mem[ 974] = 32'h8182ec71;
        mem[ 975] = 32'h8173ecd5;
        mem[ 976] = 32'h8164ed38;
        mem[ 977] = 32'h8155ed9c;
        mem[ 978] = 32'h8147edff;
        mem[ 979] = 32'h8139ee63;
        mem[ 980] = 32'h812beec6;
        mem[ 981] = 32'h811eef2a;
        mem[ 982] = 32'h8111ef8e;
        mem[ 983] = 32'h8104eff1;
        mem[ 984] = 32'h80f7f055;
        mem[ 985] = 32'h80ebf0b9;
        mem[ 986] = 32'h80dff11d;
        mem[ 987] = 32'h80d4f180;
        mem[ 988] = 32'h80c9f1e4;
        mem[ 989] = 32'h80bef248;
        mem[ 990] = 32'h80b3f2ac;
        mem[ 991] = 32'h80a9f310;
        mem[ 992] = 32'h809ff374;
        mem[ 993] = 32'h8095f3d8;
        mem[ 994] = 32'h808cf43c;
        mem[ 995] = 32'h8083f4a1;
        mem[ 996] = 32'h807af505;
        mem[ 997] = 32'h8071f569;
        mem[ 998] = 32'h8069f5cd;
        mem[ 999] = 32'h8061f631;
        mem[1000] = 32'h805af696;
        mem[1001] = 32'h8053f6fa;
        mem[1002] = 32'h804cf75e;
        mem[1003] = 32'h8045f7c2;
        mem[1004] = 32'h803ff827;
        mem[1005] = 32'h8039f88b;
        mem[1006] = 32'h8033f8ef;
        mem[1007] = 32'h802ef954;
        mem[1008] = 32'h8028f9b8;
        mem[1009] = 32'h8024fa1d;
        mem[1010] = 32'h801ffa81;
        mem[1011] = 32'h801bfae5;
        mem[1012] = 32'h8017fb4a;
        mem[1013] = 32'h8014fbae;
        mem[1014] = 32'h8010fc13;
        mem[1015] = 32'h800dfc77;
        mem[1016] = 32'h800bfcdc;
        mem[1017] = 32'h8009fd40;
        mem[1018] = 32'h8007fda5;
        mem[1019] = 32'h8005fe09;
        mem[1020] = 32'h8003fe6e;
        mem[1021] = 32'h8002fed2;
        mem[1022] = 32'h8002ff37;
        mem[1023] = 32'h8001ff9b;
    end
    always @(posedge clk) dout <= mem[addr];
endmodule
