3321485853ray-hue/Rhythm-of-Notes/fpga/src/reverb.v

// reverb.v — 混响

module reverb (
    input  wire               clk,
    input  wire               rst_n,        // 顶层恒接 1'b1
    input  wire               sample_strobe,
    input  wire [1:0]         gear_in,
    input  wire signed [15:0] din,          // 单极性（0..~8190）
    input  wire [11:0]        dc_in,
    output wire signed [19:0] wet_out,
    output wire signed [15:0] dout
);

    wire [1:0] rev_gear = gear_in;

    wire signed [15:0] p0, p1, p2, p3, p4, p5, p6, p7;

`ifndef REV_MOD_SH
    `define REV_MOD_SH 7           // >>>7 ⇒ ±128（Q4）⇒ ±8 个采样点
`endif

    reg [25:0] lfo_cnt = 26'd0;
    always @(posedge clk) lfo_cnt <= lfo_cnt + 26'd1;

    function [14:0] tri15;             // 26 位相位 → 15 位三角波 0..32767
        input [25:0] p;
        begin
            tri15 = p[25] ? ~p[24:10] : p[24:10];
        end
    endfunction

    wire [25:0] ph0 = lfo_cnt + 26'h000_0000;
    wire [25:0] ph1 = lfo_cnt + 26'h080_0000;
    wire [25:0] ph2 = lfo_cnt + 26'h100_0000;
    wire [25:0] ph3 = lfo_cnt + 26'h180_0000;
    wire [25:0] ph4 = lfo_cnt + 26'h200_0000;
    wire [25:0] ph5 = lfo_cnt + 26'h280_0000;
    wire [25:0] ph6 = lfo_cnt + 26'h300_0000;
    wire [25:0] ph7 = lfo_cnt + 26'h380_0000;

    wire [25:0] ph8  = lfo_cnt + 26'h040_0000;
    wire [25:0] ph9  = lfo_cnt + 26'h140_0000;
    wire [25:0] ph10 = lfo_cnt + 26'h2C0_0000;

`ifdef REV_MOD_OFF
    wire signed [15:0] mod0 = 16'sd0;   // 关掉调制：恒 0 ⇒ 插值退化成取整数抽头
    wire signed [15:0] mod1 = 16'sd0;
    wire signed [15:0] mod2 = 16'sd0;
    wire signed [15:0] mod3 = 16'sd0;
    wire signed [15:0] mod4 = 16'sd0;
    wire signed [15:0] mod5 = 16'sd0;
    wire signed [15:0] mod6 = 16'sd0;
    wire signed [15:0] mod7 = 16'sd0;
    wire signed [15:0] modd0 = 16'sd0;  // 扩散级三路（同样可关）
    wire signed [15:0] modd1 = 16'sd0;
    wire signed [15:0] modd2 = 16'sd0;
`else
    wire signed [15:0] mod0 = ($signed({1'b0, tri15(ph0)}) - 16'sd16384) >>> `REV_MOD_SH;
    wire signed [15:0] mod1 = ($signed({1'b0, tri15(ph1)}) - 16'sd16384) >>> `REV_MOD_SH;
    wire signed [15:0] mod2 = ($signed({1'b0, tri15(ph2)}) - 16'sd16384) >>> `REV_MOD_SH;
    wire signed [15:0] mod3 = ($signed({1'b0, tri15(ph3)}) - 16'sd16384) >>> `REV_MOD_SH;
    wire signed [15:0] mod4 = ($signed({1'b0, tri15(ph4)}) - 16'sd16384) >>> `REV_MOD_SH;
    wire signed [15:0] mod5 = ($signed({1'b0, tri15(ph5)}) - 16'sd16384) >>> `REV_MOD_SH;
    wire signed [15:0] mod6 = ($signed({1'b0, tri15(ph6)}) - 16'sd16384) >>> `REV_MOD_SH;
    wire signed [15:0] mod7 = ($signed({1'b0, tri15(ph7)}) - 16'sd16384) >>> `REV_MOD_SH;

    wire signed [15:0] modd0 = ($signed({1'b0, tri15(ph8 )}) - 16'sd16384) >>> `REV_MOD_SH;
    wire signed [15:0] modd1 = ($signed({1'b0, tri15(ph9 )}) - 16'sd16384) >>> `REV_MOD_SH;
    wire signed [15:0] modd2 = ($signed({1'b0, tri15(ph10)}) - 16'sd16384) >>> `REV_MOD_SH;
`endif

    reg [9:0] rc = 10'd0;
    always @(posedge clk) rc <= rc + 10'd1;
    wire st_c0 = (rc == 10'd200);   // 并联梳状 0..3
    wire st_c1 = (rc == 10'd300);   // 并联梳状 4..7
    wire st_a  = (rc == 10'd400);   // 扩散级全通
    wire st_d  = (rc == 10'd500);   // 直流斜坡
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
